capopaul/Toxic-Detection-PCB/SW/esp32/hello_world/README.md

# Hello World Example

Run the following command:

- `idf.py set-target esp32`
- `idf.py build`
- Put the jumper `JP1` to GND. You might need to press ESP reset button (`SW1`).
- `idf.py flash monitor`
- Put the jumper `JP1` to 3V3. Press ESP reset button (`SW1`).
