capopaul/Toxic-Detection-PCB/doc/design_notes_v4.0.pdf

design_notes.md | 2026-02-13

# Toxic Detection PCB - Schematic design notes

## Revision

Revision | Date | Author | Comment
v4.0 | 2026 Feb 12 | Paul Capgras | First draft : Pre-Layout

## Related Documents

Product Brief.
All components datasheets, reference manuals, evaluation boards available in doc/components/. Alphasense sensors' datasheets.

## Purpose

The purpose of Toxic Detection PCB - Schematic design notes is to document the design choices and provide details on the project.

## Table of Content

. Features
. Architecture
. Component choice
. Schematic
. Microcontroller - STM32H755ZIT3
. STM32 - Power Supply
. STM32 - Booting and programming . STM32 - Clocks
. STM32 - Debug
. STM32 - Flash
. Analog Front End
. LDOs
. Power Gating
. WiFi module - ESP32-WROOM-32E-N16 . ESP32 - Booting and programming . ESP32 - Debug
. STM32 - ESP32 communication . ESP32 - Pin assignments
. GNSS module and antenna - SAM-M10Q . MicroSD card
. Debug Features
. Shematic Revision 4.0
. Layout

## 1. Features

Toxic-Detection-PCB supports 2 sets of 4 chemical sensors from Alphasense. Toxic-Detection-PCB integrates an high performance microcontroller (STM32H755). Toxic-Detection-PCB can communicate via WiFi, Bluetooth v4.2 and BLE (ESP32). Toxic-Detection-PCB supports concurrent reception of four GNSS (GPS, GLONASS, Galileo, and BeiDou).
Toxic-Detection-PCB is powered through USB-C connector, or via 5V UARTs. Toxic-Detection-PCB is reprogrammable: ESP32 is programmable with UART, STM32 is programmable with UART and USB 2.0. Note: Programming thanks to usb can be disable. Toxic-Detection-PCB provide power for a 5V-fan.
STM32 and ESP32 can be debugged via JTAG.
STM32 have access to a 2MB internal flash, 32MB external flash (QSPI), MicroSD card (SDMMC 4 lines).
Toxic-Detection-PCB embedded protection against short ciruits (1A fuse), return currents, ESD (on UARTs, USB, SD card).
Toxic-Detection-PCB can turnoff power for each Analog Front End and for the fan. Toxic-Detection-PCB includes 1 red and 2 green LEDs. The red led indicates the board is powered and there are no short circuit detected. The 1rst green led is controlled by the ESP32, the 2nd by the STM32. It is up to the user to define their meaning.
Unused GPIOs of STM32, ESP32 and channels of ADCs are routed to headers.

## 2. Architecture

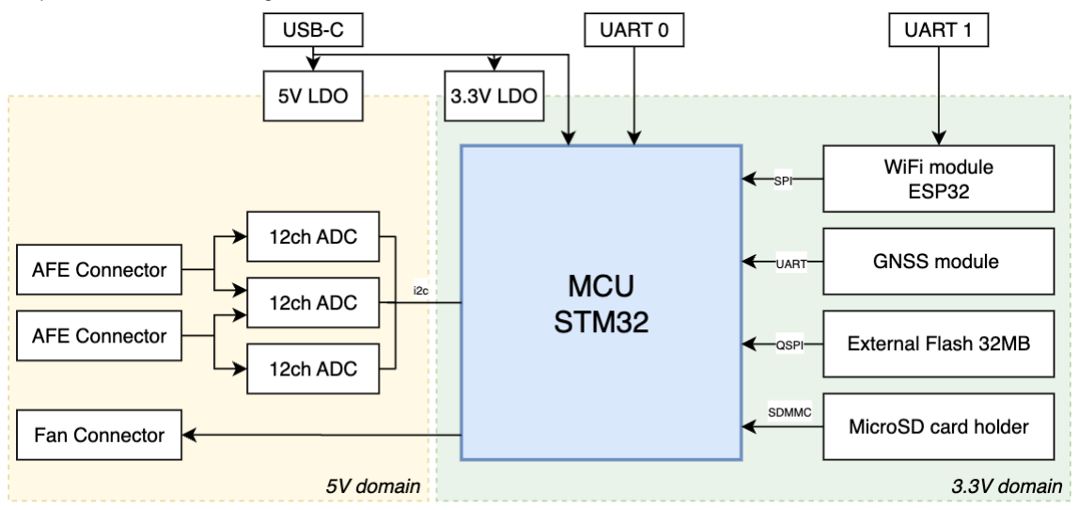
[picture p77: figure]

Simplified architecture diagram:

Complete architecture diagram:


## 3. Component choice

Many components are based on the previous board design: Revision 3.3 (April 2024) and Revision 3.3.1 (August 2024).

MCU: STM32H755ZIT3 is chosen as the Machine Learning applications have been tested on the Nucleo-h755zi development board which contains the STM32H755ZIT3.
WIFI: ESP32-WROOM-32E is picked because it is easy to use.
GNSS: SAM-M10Q is selected because it includes both GNSS module and antenna.

## 4. Schematic

4.1 Microcontroller - STM32H755ZIT3

4.1.1 STM32 - Power supply

According to the STM 32 power supply figure:


There are multiple key power domain:

. VDD domain (clocks, Batterie charging, IOs ring) : It is powered by VDD (3.3V).
. Analog domain : it is powered by (3.3VA).
. Core domain : it can be powered by internal SMPS or internal LDO. Default configuration is SMPS (3.3V input, Vcore at 1.2V).
. USB power domain: not used in this board.


Schematic:

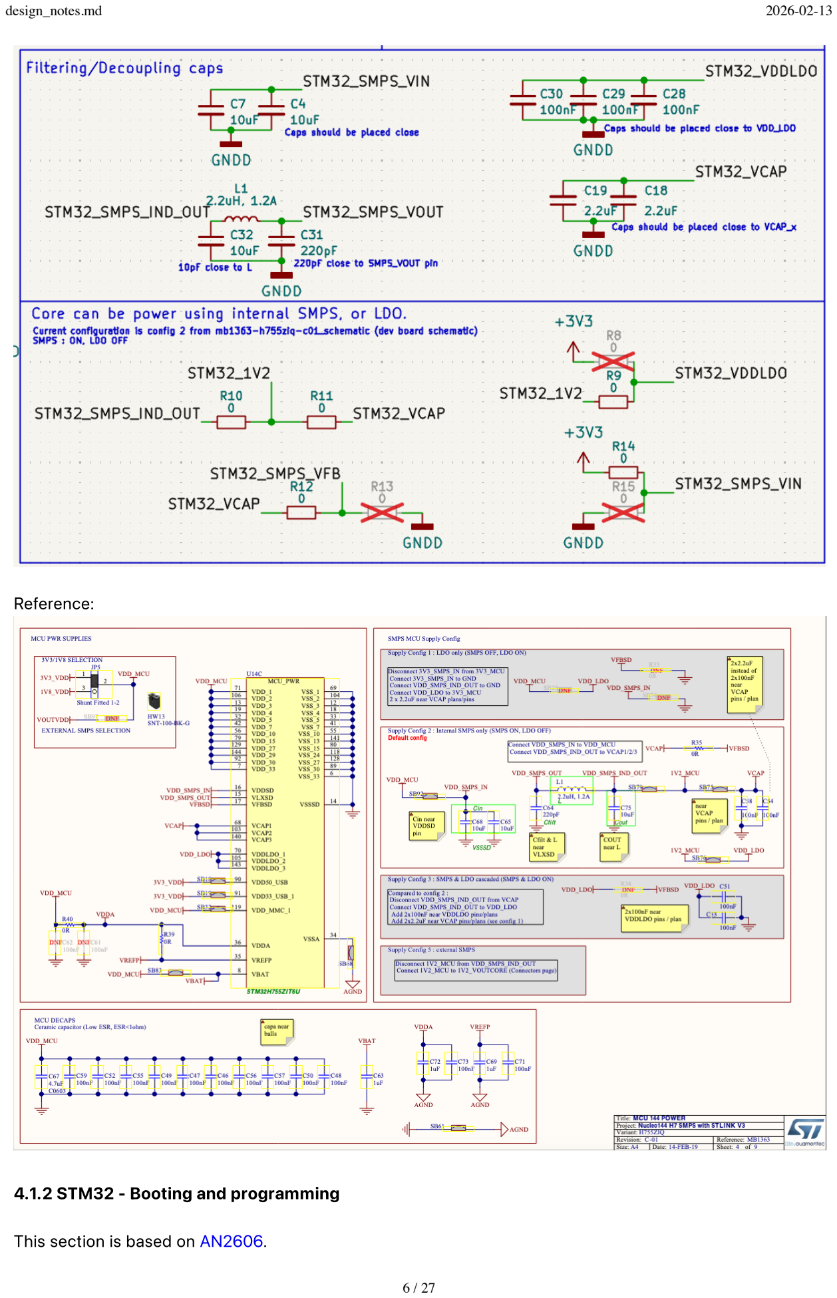
[picture p78: page 6]

Reference:

4.1.2 STM32 - Booting and programming

This section is based on AN2606.

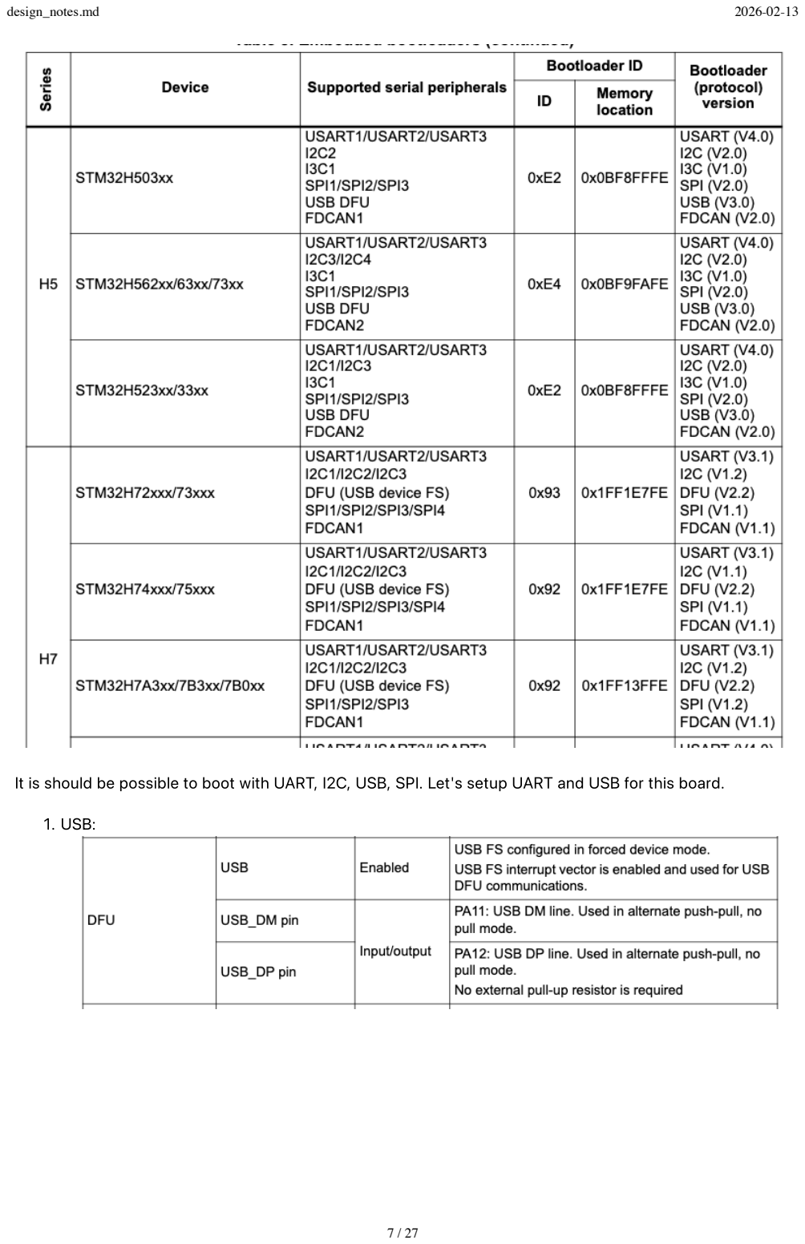
[picture p79: page 7]

It is should be possible to boot with UART, I2C, USB, SPI. Let's setup UART and USB for this board.

. USB:

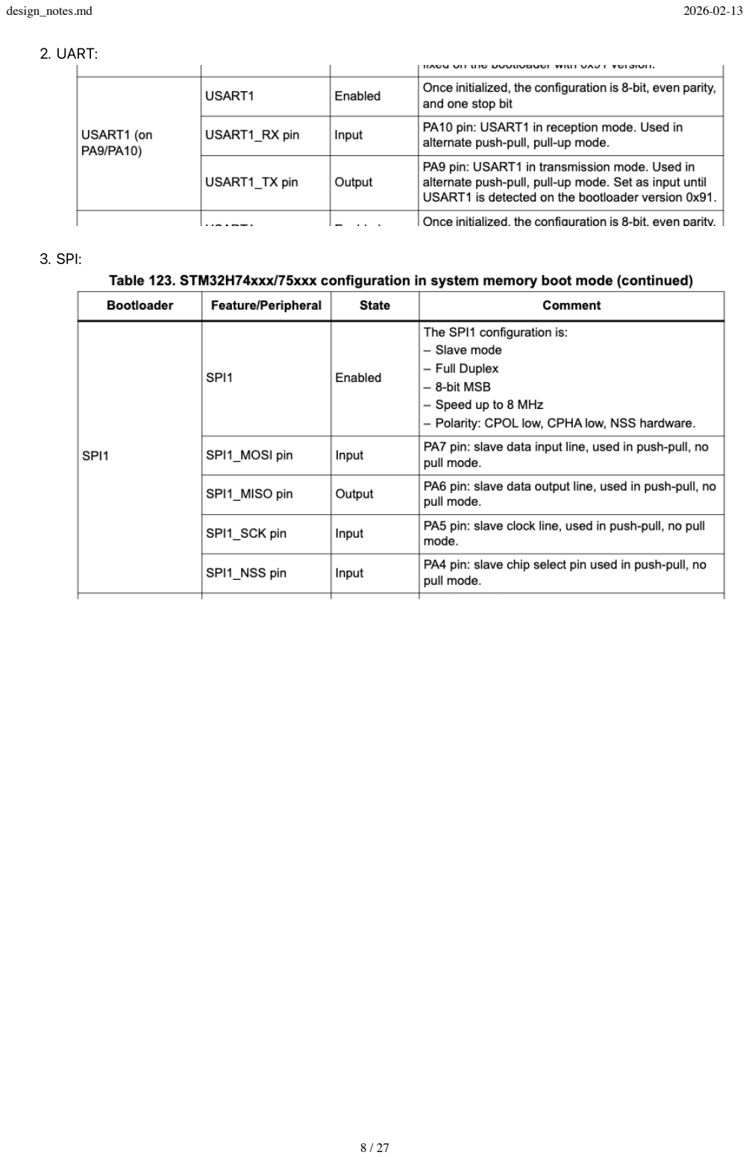
[picture p80: page 8]

. UART:

. SPI:


Schematic:

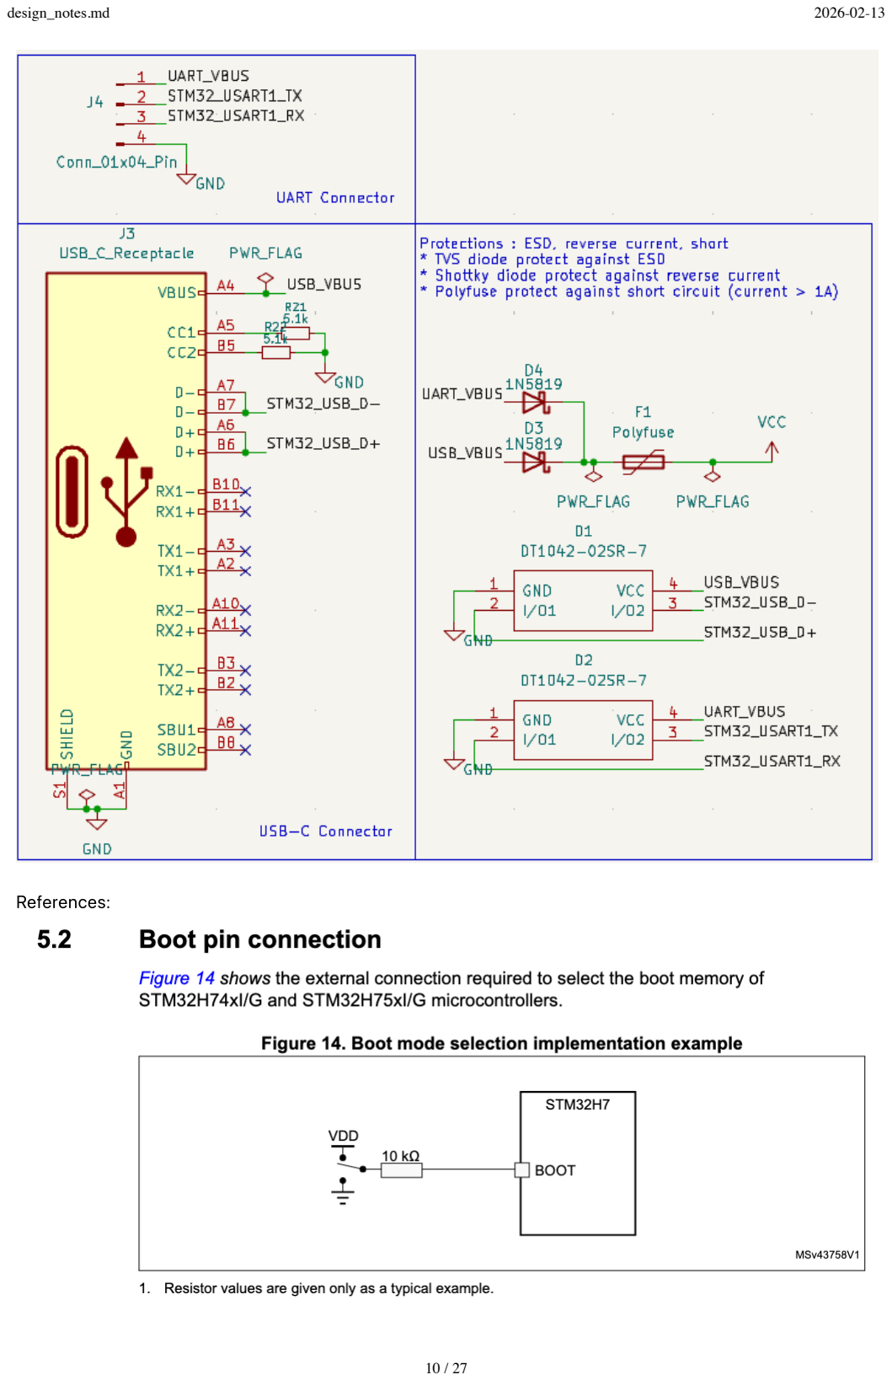
[picture p81: page 10]

References:

4.1.3 STM32 - Clocks

Schematic:


References: It is based on AN4938.


Section 4.1.2 of :

The external oscillator frequency ranges from 4 to 48 MHz. The external oscillator has the advantage of producing a very accurate main clock. The associated hardware configuration is shown in Figure 11. Using a 25 MHz oscillator frequency is a good choice to get accurate Ethernet, USB OTG high-speed peripheral, I2S, and SAI.
The resonator and the load capacitors have to be connected as close as possible to the oscillator pins to minimize the output distortion and startup stabilization time. The load capacitance values must be adjusted according to the selected oscillator.
For CL1 and CL2 it is recommended to use high-quality ceramic capacitors in the 5 pF to 25 pF range (typical), designed for high-frequency applications and selected to meet the requirements of the crystal or resonator. CL1 and CL2 are usually the same value. The crystal manufacturer typically specifies a load capacitance that is the series combination of CL1 and CL2. The PCB and MCU pin capacitances must be included when sizing CL1 and CL2 (10 pF can be used as a rough estimate of the combined pin and board capacitance).

Datasheet for the 25MHz clock (HSE): ECX_2236B2. The Load capacitance of this clock is 18pF (its in the name, do not refer to datasheet). So the Capacitors are 16pF to have 18 = 10 + 16/2

Datasheet for the 32.768kHz clock(OSC32): CM9V-T1A. The load capacitance of this clock is 12.5pF. So the capacitors are 5pF to have 12.5 = 10 + 5/2

4.1.4 STM32 - Debug

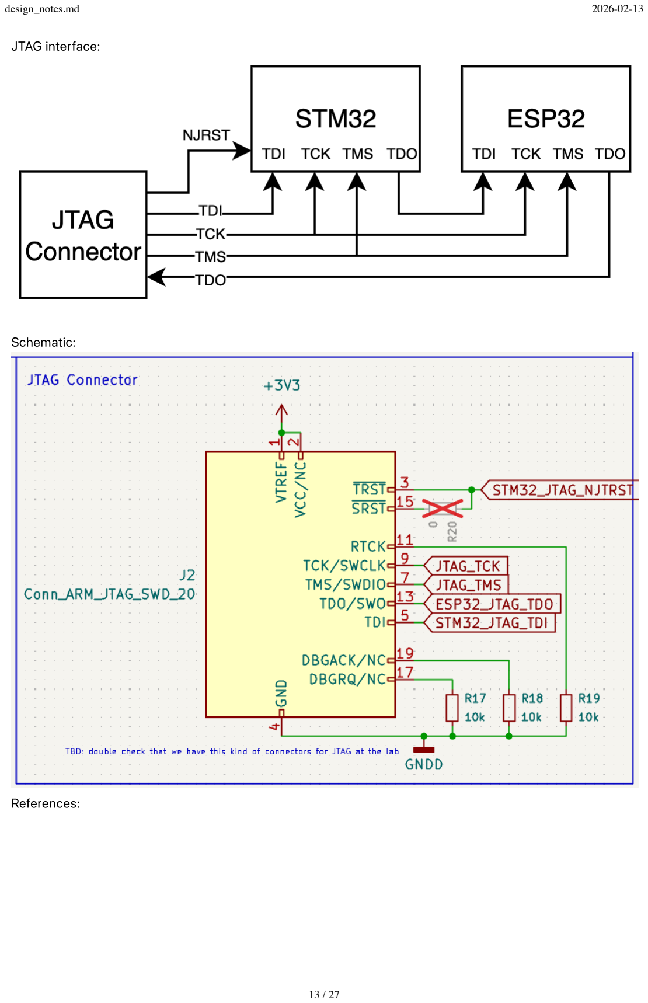
[picture p82: page 13]

JTAG interface:

Schematic:

References:

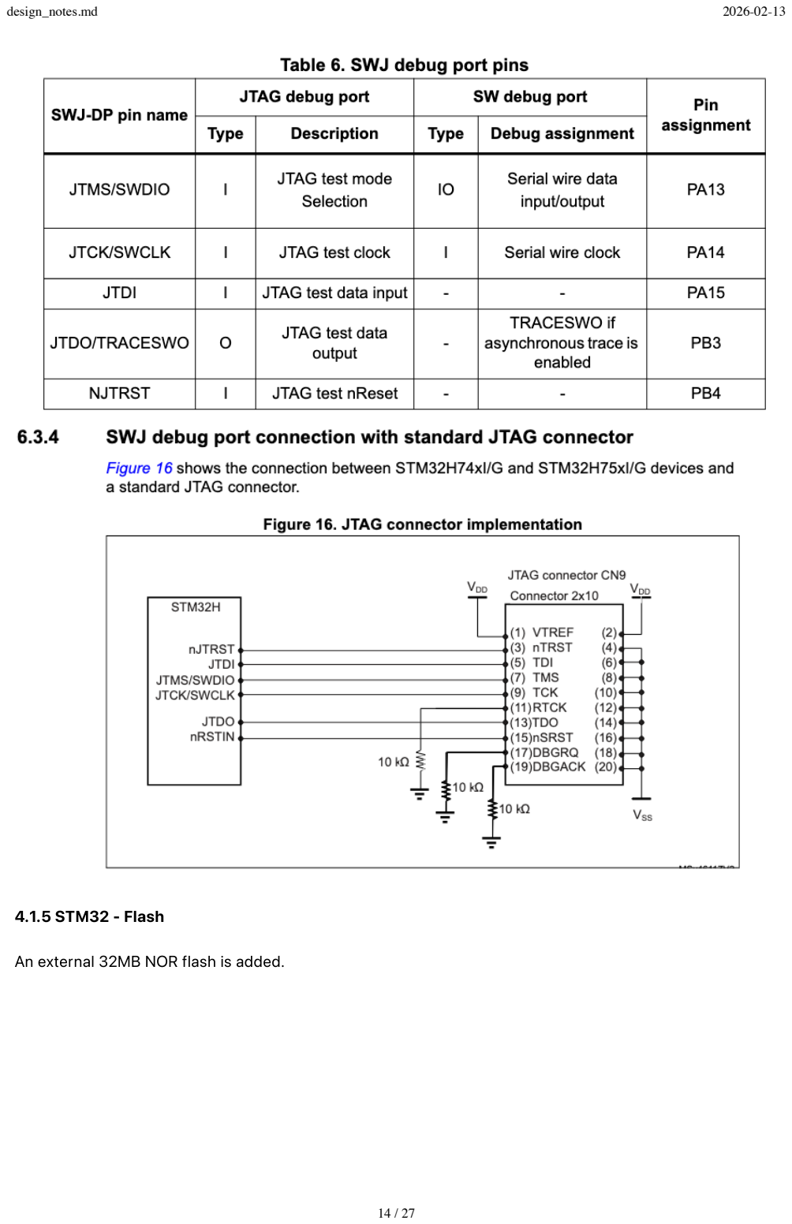
[picture p83: page 14]

4.1.5 STM32 - Flash

An external 32MB NOR flash is added.

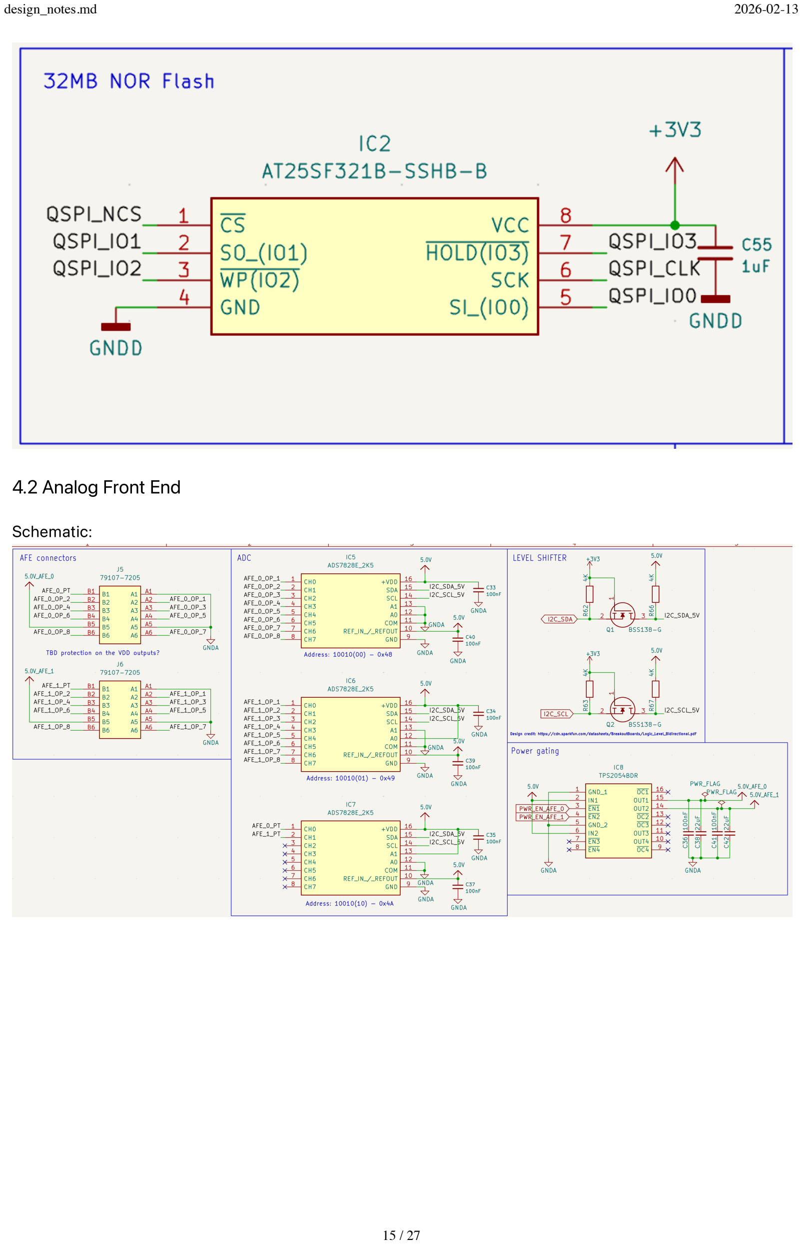
[picture p84: page 15]

4.2 Analog Front End

Schematic:

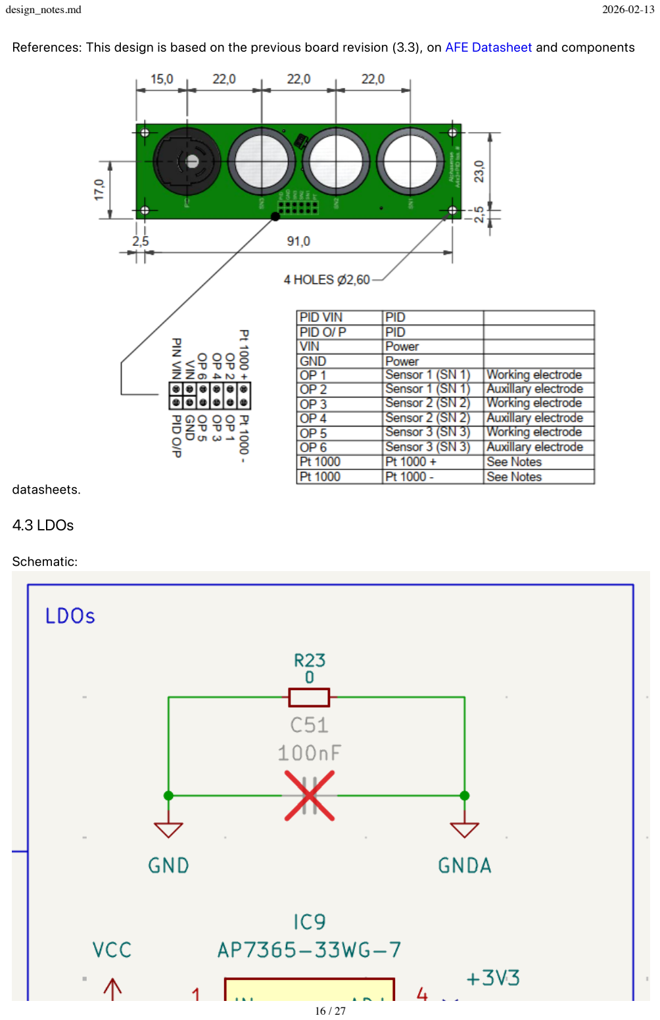
[picture p85: page 16]

References: This design is based on the previous board revision (3.3), on AFE Datasheet and components

datasheets.

4.3 LDOs

Schematic:

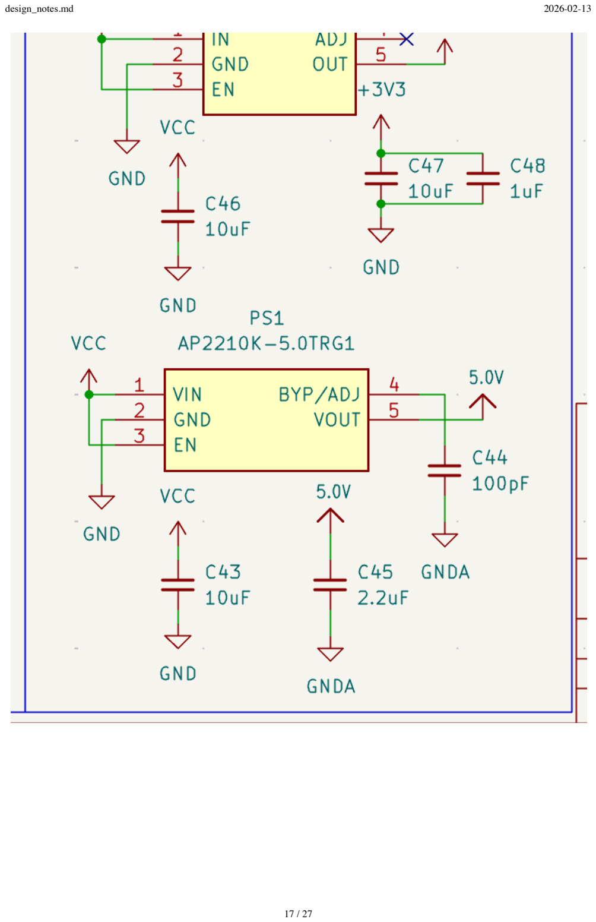
[picture p86: page 17]
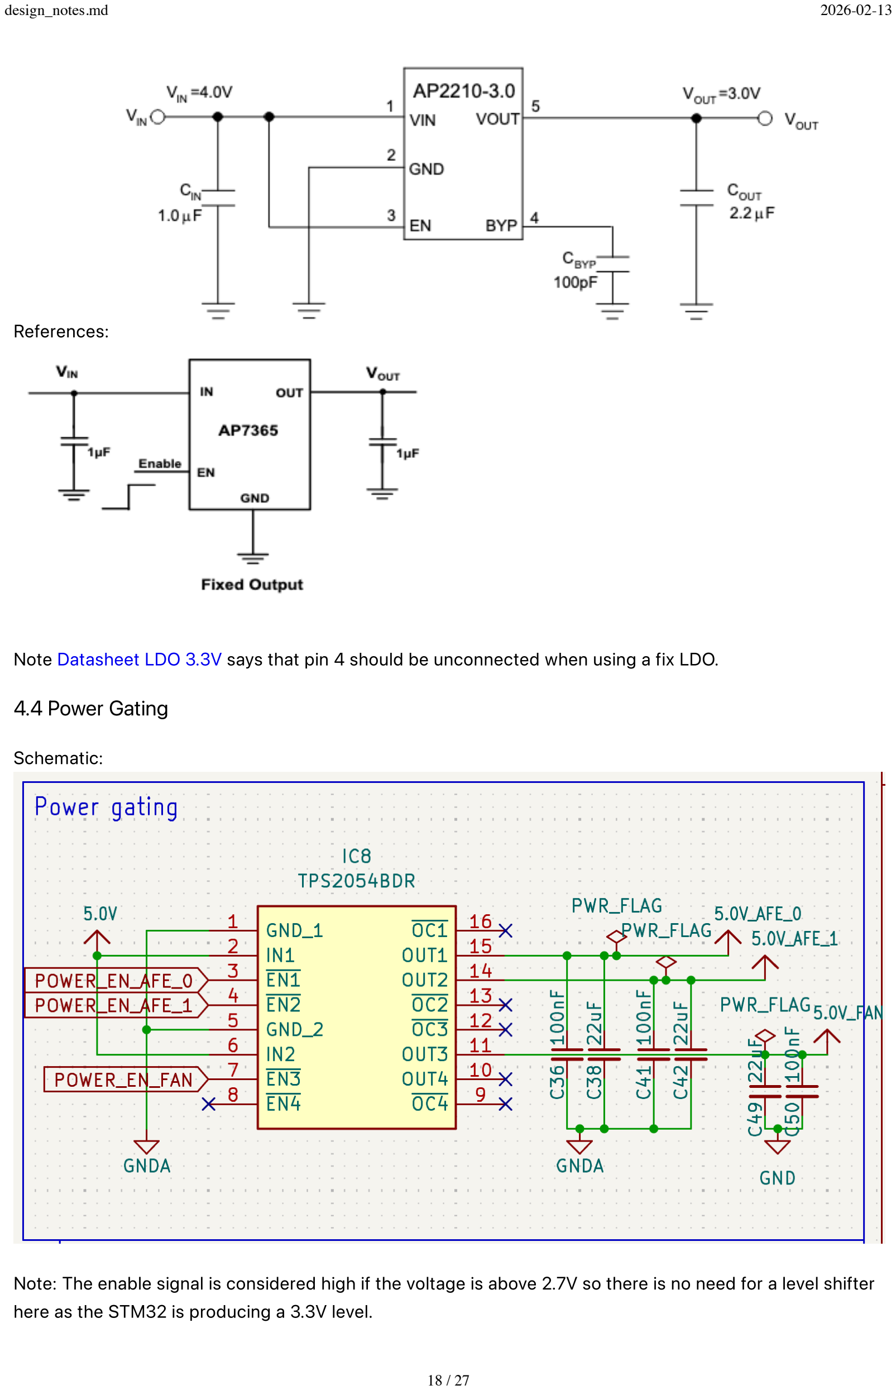
[picture p87: page 18]

References:

Note Datasheet LDO 3.3V says that pin 4 should be unconnected when using a fix LDO.

4.4 Power Gating

Schematic:

Note: The enable signal is considered high if the voltage is above 2.7V so there is no need for a level shifter here as the STM32 is producing a 3.3V level.

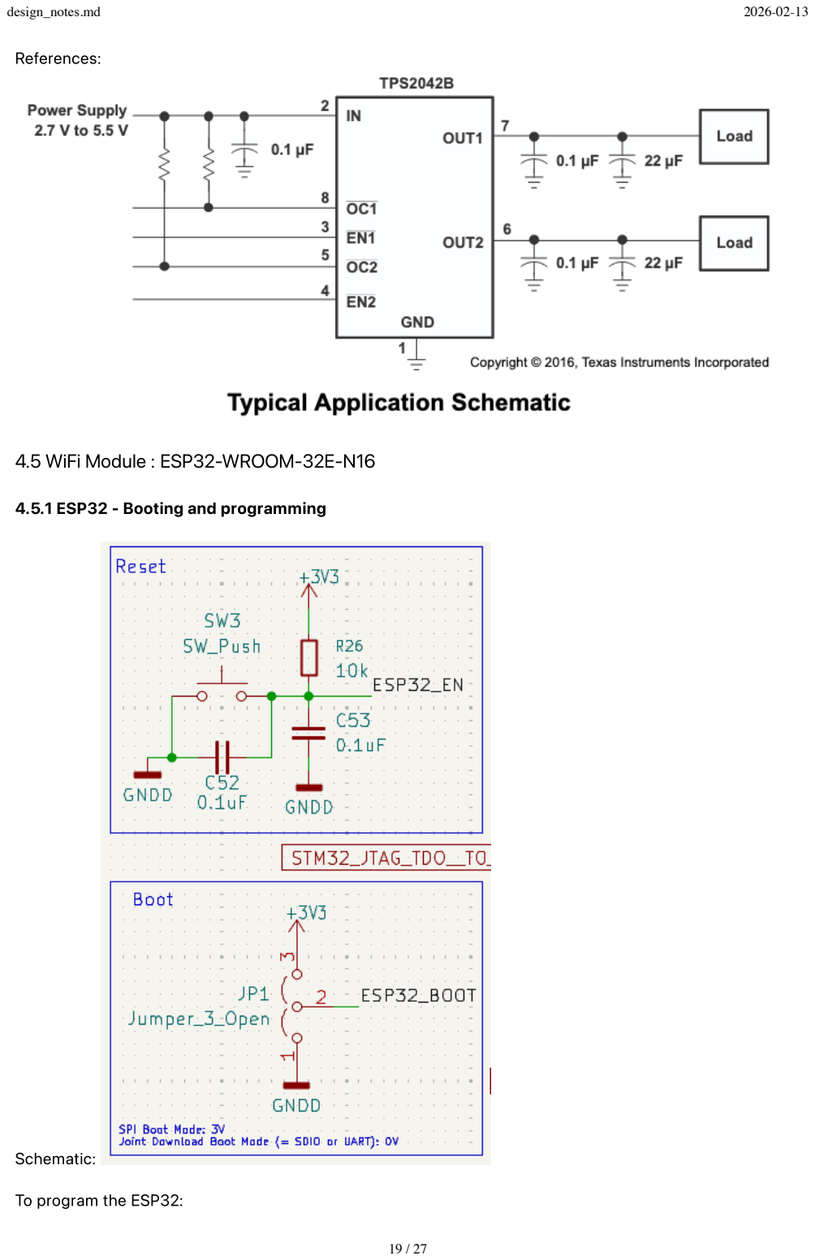
[picture p88: page 19]

References:

4.5 WiFi Module : ESP32-WROOM-32E-N16

4.5.1 ESP32 - Booting and programming

Schematic:

To program the ESP32:

First, connect ESP32_BOOT to GND using the jumper.
Then program the 16MB flash using UART.
Finally, put the jumper back to 3.3v to boot from the flash that has been programmed.

References:

DevKitC V4.

4.5.2 ESP32 - Debug

Debug can be performed via JTAG. See STM32 debug section.

4.5.3 STM32 - ESP32 communication

To communicate with the ESP from the STM32, decision is made to use SPI because it is fast and the ESP32 has SPI slave available natively.

References: The General Purpose SPI can behave in slave mode. For them any GPIO is possible, however for best performance, it is better to use parallel QSPI pins. Since HSPI pins are used by JTAG, decision is


made to use the VSPI pins.

Schematic:


4.5.4 ESP32 - Pin assignments

This table contains all the pin assignments. It was updated during layout to make rooting easier.

IO° | Type | Active Mode | Debug/Bringup
IO0 | I/O | | booting
IO1 TXD0 | I/O | | esp32_uart_tx
IO2 | I/O | | booting
IO3 RXD0 | I/O | | esp32_uart_rx
IO4 | I/O
IO5 | I/O | esp32_spi_cs
IO12 | I/O | | jtag_tdi
IO13 | I/O | | jtag_tck
IO14 | I/O | | jtag_tms
IO15 | I/O | | jtag_tdo
IO16 | I/O | esp32_led_0

IO° | Type | Active Mode | Debug/Bringup
IO17 | I/O
IO18 | I/O | esp32_spi_sclk
IO19 | I/O | esp32_spi_miso
IO21 | I/O
IO22 | I/O
IO23 | I/O | esp32_spi_mosi
IO25 | I/O
IO26 | I/O | stm32_esp32_irq_1
IO27 | I/O | stm32_esp32_irq_2
IO32 | I/O
IO33 | I/O
IO34 | I
IO35 | I
IO36 SENSOR_VP | I
IO39 SENSOR_VN | I

4.6 GNSS module and antenna - SAM-M10Q


Schematic:

References:


4.7 MicroSD card

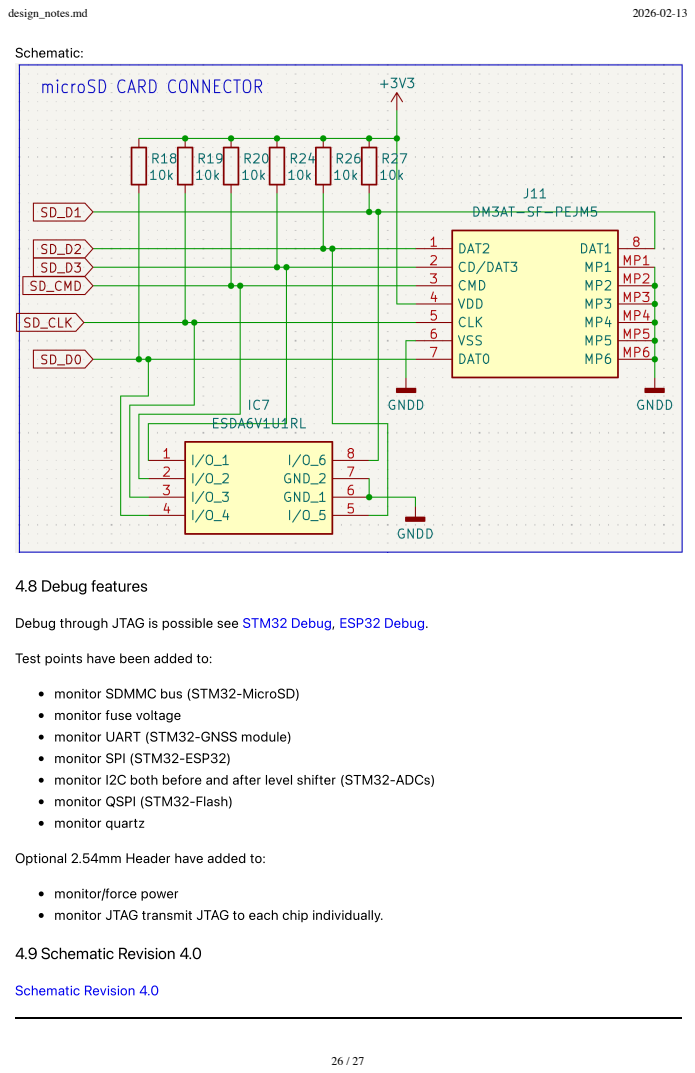
[picture p89: page 26]
Schematic:; 4.8 Debug features; 4.9 Schematic Revision 4.0; Schematic Revision 4.0

Debug through JTAG is possible see STM32 Debug, ESP32 Debug.

Test points have been added to:

monitor SDMMC bus (STM32-MicroSD)
monitor fuse voltage
monitor UART (STM32-GNSS module)
monitor SPI (STM32-ESP32)
monitor I2C both before and after level shifter (STM32-ADCs)
monitor QSPI (STM32-Flash)
monitor quartz

Optional 2.54mm Header have added to:

monitor/force power
monitor JTAG transmit JTAG to each chip individually.

## 5. Layout
