capopaul/Toxic-Detection-PCB/doc/images/AirU_System_Diagram.jpg

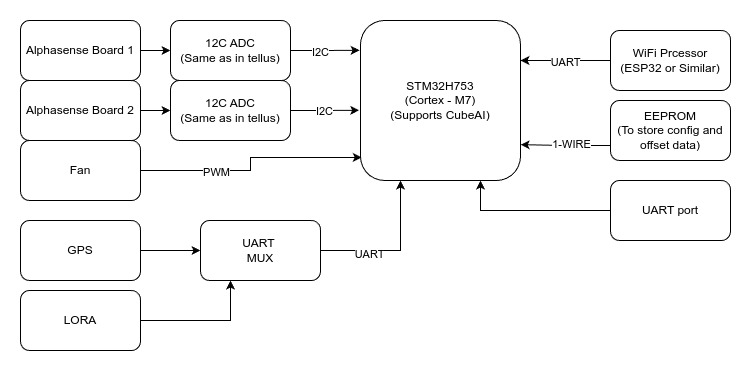
doc/images/AirU_System_Diagram.jpg
