capopaul/Toxic-Detection-PCB/doc/images/schematic_jtag.png

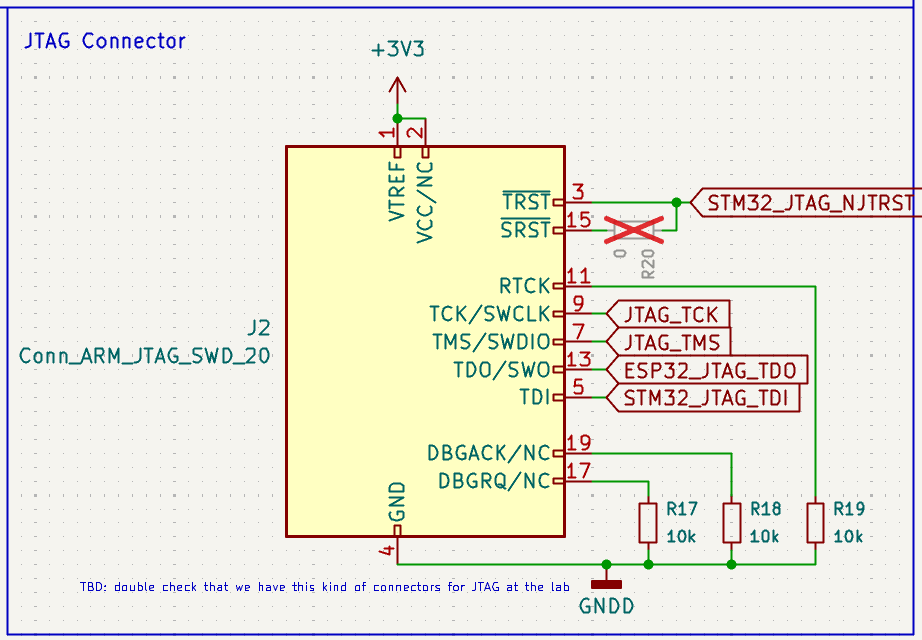
doc/images/schematic_jtag.png
