capopaul/Toxic-Detection-PCB/doc/components/AFE Connector 79107-7204/79107-7204.pdf

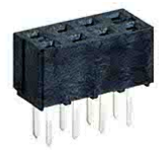
[picture p94: figure]

Part Number : 791077204 (https://www.molex.com/en-us/products/part-detail/791077204)
Product Description : 2.00mm Pitch Milli-Grid Receptacle, Vertical, Through Hole, Dual Row, 1.91mm Tail Length, 0.38µm Gold (Au) Selective Plating, 10 Circuits, Lead-Free, Tube
Series Number : 79107
Status : Active
Product Category : PCB Headers and Receptacles

### Documents and Resources

Drawings
791077204_sd.pdf (https://www.molex.com/content/dam/molex/molex-dot-com/products/automated/en-us/salesdrawingpdf/791/79107/791077204_sd.pdf)
PK-70873-0180-001.pdf (https://www.molex.com/content/dam/molex/molex-dot-com/products/automated/en-us/packagingdesigndrawing/708/70873/PK-70873-0180-001.pdf)
3D Models and Design Files STEP (https://www.molex.com/bin/molex/traceparts/cad-request?partNumber=791077204&cadFormatId=659) AP242 (https://www.molex.com/bin/molex/traceparts/cad-request?partNumber=791077204&cadFormatId=659)
SOLIDWORKS (https://www.molex.com/bin/molex/traceparts/cad-request?partNumber=791077204&cadFormatId=7)
Creo (https://www.molex.com/bin/molex/traceparts/cad-request?partNumber=791077204&cadFormatId=16)
Symbol (https://www.molex.com/en-us/products/part-3d-cad/791077204) and (https://www.molex.com/en-us/products/part-3d-cad/791077204) Footprint (https://www.molex.com/en-us/products/part-3d-cad/791077204) (Multi- (https://www.molex.com/en-us/products/part-3d-cad/791077204)Format) (https://www.molex.com/en-us/products/part-3d-cad/791077204) Specifications
503940001- (https://www.molex.com/content/dam/molex/molex-dot-com/products/automated/en-us/applicationspecificationspdf/503/50394/503940001-AS-000.pdf)AS-000.pdf (https://www.molex.com/content/dam/molex/molex-dot-com/products/automated/en-us/applicationspecificationspdf/503/50394/503940001-AS-000.pdf)
PS-79107-001.pdf (https://www.molex.com/content/dam/molex/molex-dot-com/products/automated/en-us/productspecificationpdf/791/79107/PS-79107-001.pdf)

### Product Environment Compliance

Compliance
GADSL/IMDS | Not Relevant
China RoHS | per SJ/T 11365-2006
EU ELV | Not Relevant
Low-Halogen Status | Low-Halogen per IEC 61249-2-21
REACH SVHC | Not Contained per D(2025)6375-DC (05 Nov 2025)
EU RoHS | Compliant per EU 2015/863

Compliance (https://www.molex.com/en-us/product-compliance#pn=791077204) Statements (https://www.molex.com/en-us/product-compliance#pn=791077204)
EU RoHS
REACH SVHC
Low-Halogen
Industry (https://www.molex.com/en-us/industry-compliance?pn=791077204) Documents (https://www.molex.com/en-us/industry-compliance?pn=791077204)
IPC 1752A Class C
IPC 1752A Class D
Molex Product Compliance Declaration IEC-62474
chemSHERPA (xml)
Substances (https://www.molex.com/en-us/substances-of-interest?pn=791077204) of (https://www.molex.com/en-us/substances-of-interest?pn=791077204) Interest (https://www.molex.com/en-us/substances-of-interest?pn=791077204)
PFAS
EU (https://www.molex.com/en-us/rohs-pdf?pn=791077204) RoHS (https://www.molex.com/en-us/rohs-pdf?pn=791077204) Certificate (https://www.molex.com/en-us/rohs-pdf?pn=791077204) of (https://www.molex.com/en-us/rohs-pdf?pn=791077204) Compliance (https://www.molex.com/en-us/rohs-pdf?pn=791077204) Additional (https://www.molex.com/en-us/about/product-compliance) Product (https://www.molex.com/en-us/about/product-compliance) Compliance (https://www.molex.com/en-us/about/product-compliance) Information (https://www.molex.com/en-us/about/product-compliance)

### Part Details

General
Status | Active
Category | PCB Headers and Receptacles
Series | 79107
Description | 2.00mm Pitch Milli-Grid Receptacle, Vertical, Through Hole, Dual Row, 1.91mm Tail Length, 0.38µm Gold (Au) Selective Plating, 10 Circuits, Lead-Free, Tube
Application | Board-to-Board, Signal
Component Type | PCB Receptacle
Product Name | Milli-Grid
UPC | 822348475018

Agency
CSA | LR19980
UL | E29179

Electrical
Current - Maximum per Contact | 1.0A
Voltage - Maximum | 125V

Physical
Circuits (Loaded) | 10
Circuits (maximum) | 10
Color - Resin | Black
Durability (mating cycles max) | 50
First Mate / Last Break | No
Flammability | 94V-0
Glow-Wire Capable | No
Lock to Mating Part | No
Material - Metal | Phosphor Bronze
Material - Plating Mating | Gold
Material - Plating Termination | Tin
Material - Resin | High Temperature Thermoplastic
Net Weight | 285.580/mg
Number of Rows | 2
Orientation | Vertical
Packaging Type | Tube
PCB Locator | No
PCB Retention | None
PCB Thickness - Recommended | 0.80mm
PC Tail Length | 1.91mm
Pitch - Mating Interface | 2.00mm
Pitch - Termination Interface | 2.00mm
Plating min - Mating | 0.381µm
Plating min - Termination | 1.905µm
Polarized to Mating Part | No
Polarized to PCB | No
Temperature Range - Operating | -55° to +125°C
Termination Interface Style | Through Hole

Solder Process Data
Max-Duration | 10
Lead-Free Process Capability | WAVE
Max-Cycle | 1
Max-Temp | 260

### Mates With / Use With

Mates with Part(s)
Description | Part Number
Milli-Grid Vertical Through Hole Headers | 87758 (https://www.molex.com/en-us/part-list/87758?physical_circuitsMaximum="10"&physical_numberOfRows="2")
Milli-Grid Vertical Surface Mount Headers | 87759 (https://www.molex.com/en-us/part-list/87759?physical_circuitsMaximum="10"&physical_numberOfRows="2")
Milli-Grid Right-Angle Through Hole Headers | 87760 (https://www.molex.com/en-us/part-list/87760?physical_circuitsMaximum="10"&physical_numberOfRows="2")
Milli-Grid Vertical, Dual Row, Through Hole Headers | 87831 (https://www.molex.com/en-us/part-list/87831?physical_circuitsMaximum="10"&physical_numberOfRows="2")
Milli-Grid Vertical, Dual Row, Surface Mount Headers | 87832 (https://www.molex.com/en-us/part-list/87832?physical_circuitsMaximum="10"&physical_numberOfRows="2")
Milli-Grid Vertical, Dual Row, Through Hole Headers | 151117 (https://www.molex.com/en-us/part-list/151117?physical_circuitsMaximum="10"&physical_numberOfRows="2")
Milli-Grid Vertical, Dual Row, Surface Mount Headers | 151118 (https://www.molex.com/en-us/part-list/151118?physical_circuitsMaximum="10"&physical_numberOfRows="2")
Milli-Grid Right-Angle, Dual Row, Through Hole Headers | 151119 (https://www.molex.com/en-us/part-list/151119?physical_circuitsMaximum="10"&physical_numberOfRows="2")
Milli-Grid Right-Angle, Dual Row, Surface Mount Headers | 151120 (https://www.molex.com/en-us/part-list/151120?physical_circuitsMaximum="10"&physical_numberOfRows="2")

This document was generated on Feb 10, 2026
