capopaul/Toxic-Detection-PCB/doc/components/Quartz 25MHz/ECX_2236B2.pdf

# ECX-2236B2 SMD CRYSTAL

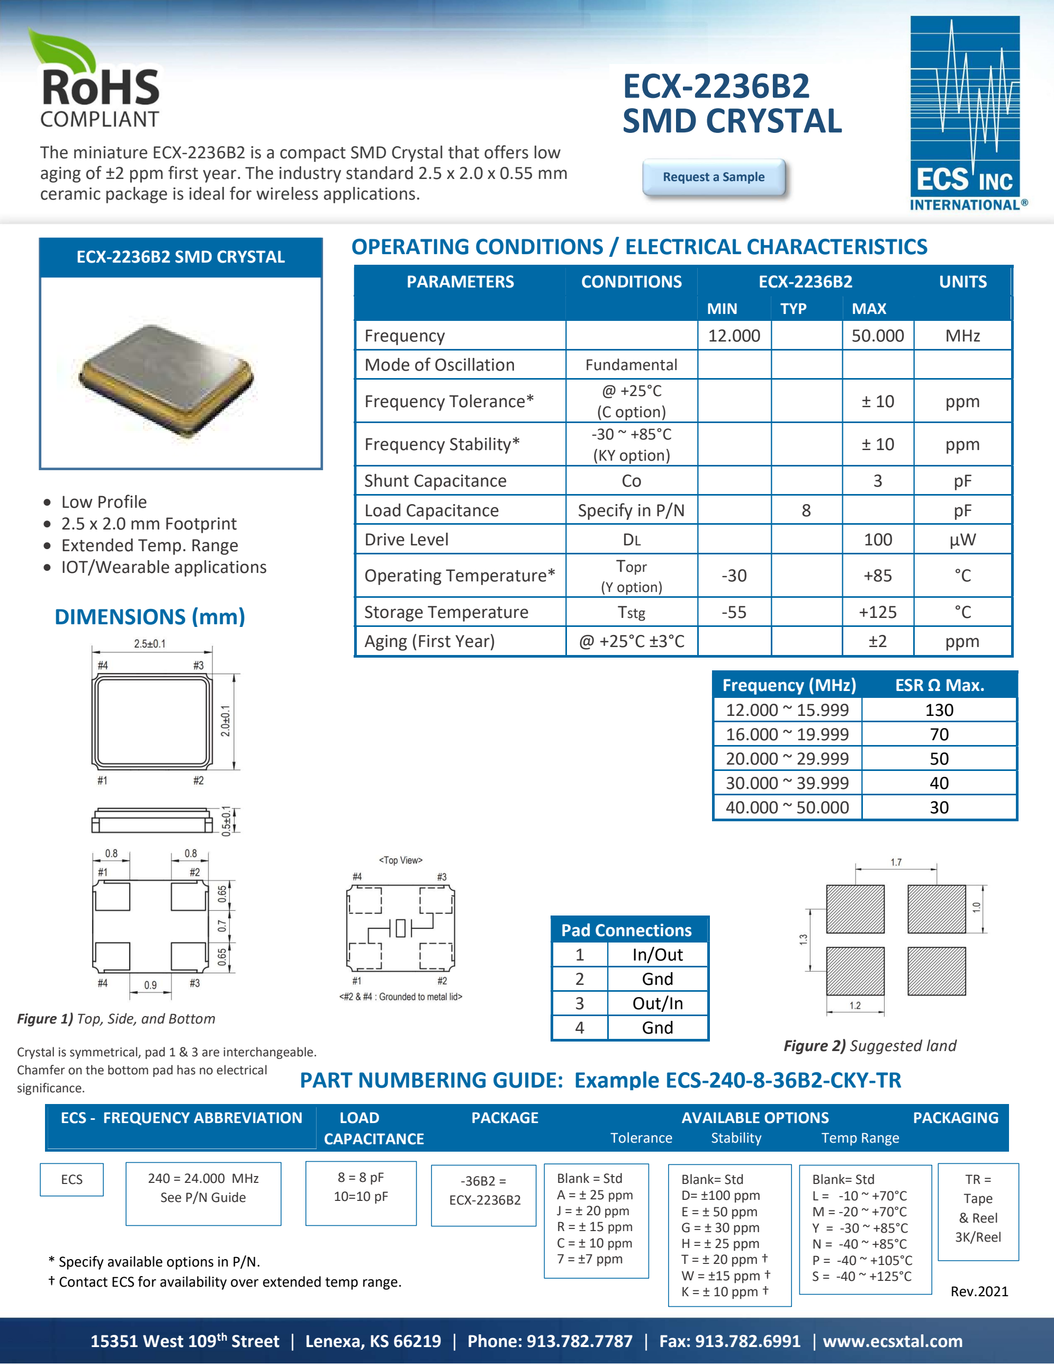
[picture p95: page 1]

15351 West 109th Street | Lenexa, KS 66219 | Phone: 913.782.7787 | Fax: 913.782.6991 | www.ecsxtal.com
PARAMETERS | CONDITIONS | ECX-2236B2 | UNITS
| | MIN | TYP | MAX
Frequency | | 12.000 | | 50.000 | MHz
Mode of Oscillation | Fundamental
Frequency Tolerance* | @ +25°C (C option) | | | ± 10 | ppm
Frequency Stability* | -30 ~ +85°C (KY option) | | | ± 10 | ppm
Shunt Capacitance | Co | | | 3 | pF
Load Capacitance | Specify in P/N | | 8 | | pF
Drive Level | DL | | | 100 | μW
Operating Temperature* | Topr (Y option) | -30 | | +85 | °C
Storage Temperature | Tstg | -55 | | +125 | °C
Aging (First Year) | @ +25°C ±3°C | | | ±2 | ppm
ECS - FREQUENCY ABBREVIATION | LOAD
CAPACITANCE
PACKAGE | AVAILABLE OPTIONS
Tolerance | Stability | Temp Range

PACKAGING

Frequency (MHz) | ESR Ω Max.
12.000 ~ 15.999 | 130
16.000 ~ 19.999 | 70
20.000 ~ 29.999 | 50
30.000 ~ 39.999 | 40
40.000 ~ 50.000 | 30

Pad Connections
1 In/Out
2 Gnd
3 Out/In
4 Gnd
- Low Profile
- 2.5 x 2.0 mm Footprint
- Extended Temp. Range
- IOT/Wearable applications

Figure 1) Top, Side, and Bottom

Crystal is symmetrical, pad 1 & 3 are interchangeable. Chamfer on the bottom pad has no electrical significance.

8 = 8 pF
10=10 pF | -36B2 =
| ECX-2236B2 Blank = Std
| A = ± 25 ppm
| J = ± 20 ppm
| R = ± 15 ppm
| C = ± 10 ppm
* Specify available options in P/N. | 7 = ±7 ppm
† Contact ECS for availability over extended temp range.

Blank= Std
D= ±100 ppm
E = ± 50 ppm
G = ± 30 ppm
H = ± 25 ppm
T = ± 20 ppm †
W = ±15 ppm †
K = ± 10 ppm †

Blank= Std
L = -10 ~ +70°C
M = -20 ~ +70°C
Y = -30 ~ +85°C
N = -40 ~ +85°C
P = -40 ~ +105°C
S = -40 ~ +125°C

### OPERATING CONDITIONS / ELECTRICAL CHARACTERISTICS

The miniature ECX-2236B2 is a compact SMD Crystal that offers low aging of ±2 ppm first year. The industry standard 2.5 x 2.0 x 0.55 mm ceramic package is ideal for wireless applications.

ECX-2236B2 SMD CRYSTAL

### DIMENSIONS (mm)

Figure 2) Suggested land

### PART NUMBERING GUIDE: Example ECS-240-8-36B2-CKY-TR

Request a Sample

240 = 24.000 MHz
See P/N Guide

TR =
Tape
& Reel
3K/Reel

Rev.2021

ECS

### POCKET TAPE DIMENSIONS (mm)

# ECX-2236B2

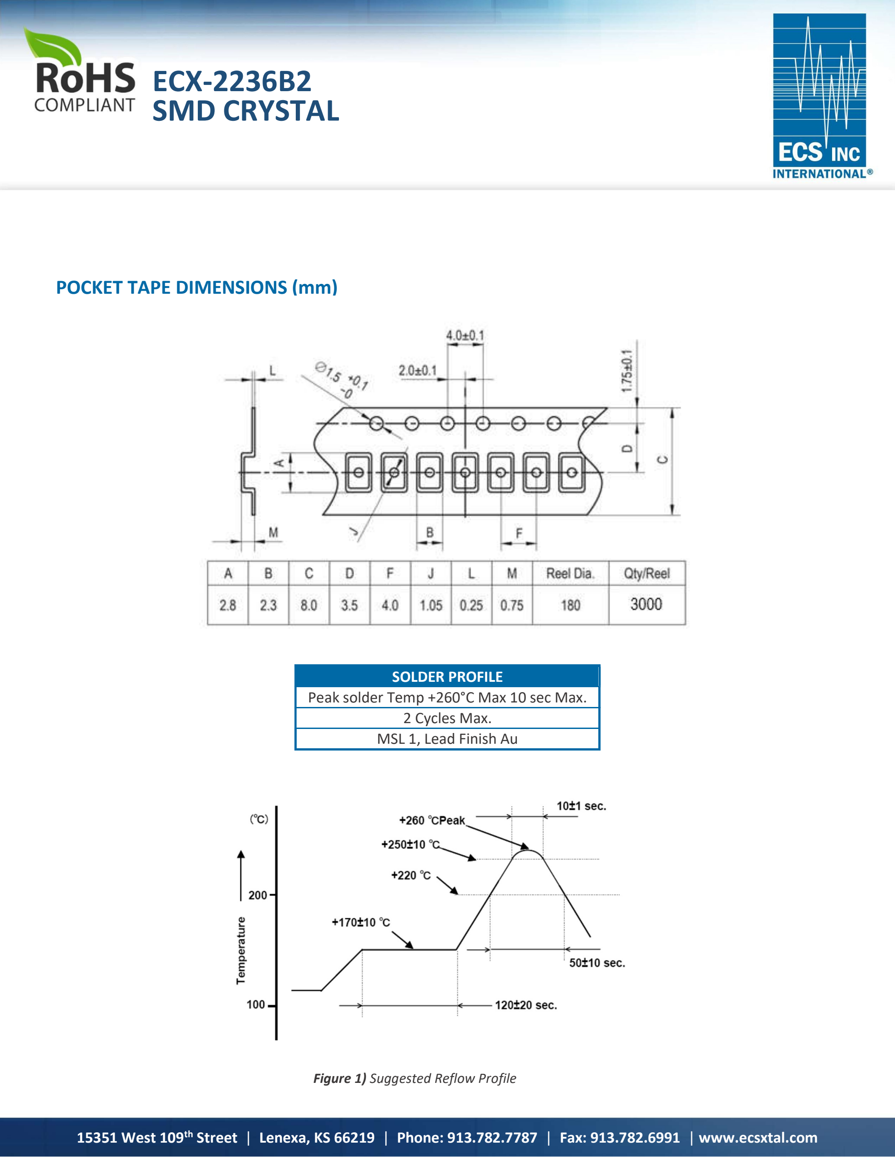
[picture p96: page 2]

15351 West 109th Street | Lenexa, KS 66219 | Phone: 913.782.7787 | Fax: 913.782.6991 | www.ecsxtal.com

SOLDER PROFILE
Peak solder Temp +260°C Max 10 sec Max. 2 Cycles Max.
MSL 1, Lead Finish Au

# SMD CRYSTAL

Figure 1) Suggested Reflow Profile
