capopaul/Toxic-Detection-PCB/doc/bom/bom_layout_v4.2_mouser.xlsm

Reference | Qty | Value | DNP | Footprint | In stock already | Mouser Order Qty | Mouser link
ANT1 | 1 | SAM-M10Q-00B |  | GNSS module and antenna:SAMM10Q00B_custom | 0 | 2 | https://www.mouser.com/ProductDetail/u-blox/MAX-M10M-00B?qs=A6eO%252BMLsxmQGh8%2FJ1ZmexA%3D%3D
C1,C3,C4,C6,C7,C9,C10,C11,C12,C13,C14,C15,C16,C17,C18,C19,C20,C27,C31,C32,C34,C36,C37,C38,C39,C40,C41,C49,C51,C54,C55 | 31 | 100nF |  | Capacitor_SMD:C_0805_2012Metric_Pad1.18x1.45mm_HandSolder | 88
C2,C46,C50,C52,C53 | 5 | 22uF |  | Capacitor_SMD:C_0805_2012Metric_Pad1.18x1.45mm_HandSolder | 9
C5 | 1 | 4.7uF |  | Capacitor_SMD:C_0805_2012Metric_Pad1.18x1.45mm_HandSolder | 97
C8,C25,C48,C56,C57,C58,C59,C60,C61,C62,C63,C64,C65,C66,C67,C68,C69,C70,C71,C72,C73,C74,C75,C76,C77,C78 | 26 | 1uF |  | Capacitor_SMD:C_0805_2012Metric_Pad1.18x1.45mm_HandSolder | 92
C21,C22,C23,C42,C43 | 5 | 10uF |  | Capacitor_SMD:C_0805_2012Metric_Pad1.18x1.45mm_HandSolder | 90
C24 | 1 | 220pF |  | Capacitor_SMD:C_0805_2012Metric_Pad1.18x1.45mm_HandSolder | 0 | 10 | https://www.mouser.com/ProductDetail/KYOCERA-AVX/KGM21BCG2A221JM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
C26,C35 | 2 | 16pF |  | Capacitor_SMD:C_0805_2012Metric_Pad1.18x1.45mm_HandSolder | 0 | 10 | https://www.mouser.com/ProductDetail/KEMET/C0805C160K3HACTU?qs=W0yvOO0ixfHxDqYJqurddw%3D%3D
C28,C33,C45 | 3 | 2.2uF |  | Capacitor_SMD:C_0805_2012Metric_Pad1.18x1.45mm_HandSolder | 0 | 10 | https://www.mouser.com/ProductDetail/Walsin/0805B225K100CT?qs=fIkAfuXiAQIAYTg2Qx2YBg%3D%3D
C29,C30 | 2 | 5pF |  | Capacitor_SMD:C_0805_2012Metric_Pad1.18x1.45mm_HandSolder | 0 | 10 | https://www.mouser.com/ProductDetail/KYOCERA-AVX/08053A5R0CAT2A?qs=bb%252B1MDm7h6IsPEvrtWkfEA%3D%3D
C44 | 1 | 100nF | DNP | Capacitor_SMD:C_0805_2012Metric_Pad1.18x1.45mm_HandSolder | 88
C47 | 1 | 100pF |  | Capacitor_SMD:C_0805_2012Metric_Pad1.18x1.45mm_HandSolder | 0 | 10 | https://www.mouser.com/ProductDetail/KEMET/C0805C101K5HACTU?qs=W0yvOO0ixfFGnDz2NfWDlg%3D%3D
D1,D2,D3 | 3 | DT1042-02SR-7 |  | USB_ESD_protection:DT104202SR7 | 0 | 10 | https://www.mouser.com/ProductDetail/Diodes-Incorporated/DT1042-02SR-7?qs=d9U39LAeJF0XUzMTT2aorQ%3D%3D
D4,D5 | 2 | 1N5819 |  | Diode_SMD:D_SOD-123 |  | 10 | https://www.mouser.com/ProductDetail/onsemi/SS25FA?qs=R26iFe%2FkX%2FL1fF1k08x8zQ%3D%3D
D6 | 1 | RED_LED_2mA |  | LED Green:LEDC2012X120N |  | 10 | https://www.mouser.com/ProductDetail/Kingbright/APT2012LSECK-J3-PRV?qs=6oMev5NRZMEkGJkKIsAalQ%3D%3D
D7,D8 | 2 | GREEN_LED_2mA |  | LED Green:LEDC2012X120N |  | 10 | https://www.mouser.com/ProductDetail/Kingbright/APTD2012LCGCK?qs=AQlKX63v8RvNHN%2F9EGvNTg%3D%3D
F1 | 1 | Polyfuse |  | Fuse:Fuse_1210_3225Metric_Pad1.42x2.65mm_HandSolder |  | 5 | https://www.mouser.com/ProductDetail/Littelfuse/1210L110-12WR?qs=TVaBpCI%2FeOiQpakeccCs1g%3D%3D
IC1 | 1 | ESP32-WROOM-32E-N16 |  | ESP32-WROOM-32E-N16:ESP32WROOM32EN16 |  | 2 | https://www.mouser.com/ProductDetail/Espressif-Systems/ESP32-WROOM-32E-N16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
IC2 | 1 | STM32H755ZIT3 |  | Package_QFP:LQFP-144_20x20mm_P0.5mm |  | 2 | https://www.mouser.com/ProductDetail/STMicroelectronics/STM32H755ZIT3?qs=sPbYRqrBIVmQlNF6lTdaDQ%3D%3D
IC3 | 1 | AT25SF321B-SSHB-B |  | NOR Flash:SOIC127P600X175-8N |  | 2 | https://www.mouser.com/ProductDetail/Renesas-Dialog/AT25SF321B-SSHB-B?qs=IS%252B4QmGtzzoKA0j9aoz1jA%3D%3D
IC4,IC5,IC6 | 3 | ADS7828E_2K5 |  | ADC ADS7828:SOP65P640X120-16N |  | 10 | https://www.mouser.com/ProductDetail/Texas-Instruments/ADS7828E-2K5?qs=%252BvKcWiXw%252BzTDfgQYOO5VWA%3D%3D
IC7 | 1 | ESDA6V1U1RL |  | TVS_diodes:SOIC127P600X175-8N |  | 2 | https://www.mouser.com/ProductDetail/STMicroelectronics/ESDA6V1U1RL?qs=jM0G0S7oE2ijLJcZLKDOhQ%3D%3D
IC8 | 1 | AZ1084CD-3.3TRG1 |  | LDO 3.3V:AZ1084CD33TRG1 |  | 10 | https://www.mouser.com/ProductDetail/Diodes-Incorporated/AZ1084CD-3.3TRG1?qs=FKu9oBikfSkIi2fxMEvJQA%3D%3D
IC9 | 1 | TPS2054BDR |  | Power Gating TPS2054BDR:SOIC127P600X175-16N |  | 2 | www.mouser.com/ProductDetail/Texas-Instruments/TPS2054BDR?qs=D8ivcil3VuyT4fCLpnAlBw%3D%3D
J1 | 1 | Conn_01x11_Pin |  | Connector_PinHeader_2.54mm:PinHeader_1x11_P2.54mm_Vertical | 100
J2 | 1 | Conn_01x10_Pin |  | Connector_PinHeader_2.54mm:PinHeader_1x10_P2.54mm_Vertical | 100
J3 | 1 | Conn_01x14_Pin |  | Connector_PinHeader_2.54mm:PinHeader_2x07_P2.54mm_Vertical | 100
J4 | 1 | Conn_01x16_Pin |  | Connector_PinHeader_2.54mm:PinHeader_2x08_P2.54mm_Vertical | 100
J5 | 1 | Conn_01x18_Pin |  | Connector_PinHeader_2.54mm:PinHeader_2x09_P2.54mm_Vertical | 100
J6,J7 | 2 | 79107-7205 |  | AFE Connector 79107-7205:791077205 |  | 4 | https://www.mouser.com/ProductDetail/Molex/79107-7205?qs=twZKxcNrvDYEJ65%2FtIoaGw%3D%3D
J8 | 1 | Conn_01x06_Pin |  | Connector_PinHeader_2.54mm:PinHeader_2x03_P2.54mm_Vertical | 100
J9,J10 | 2 | Conn_01x04_Pin |  | Connector_PinHeader_2.54mm:PinHeader_1x04_P2.54mm_Vertical | 100
J11 | 1 | USB_C_Receptacle |  | Connector_USB:USB_C_Receptacle_GCT_USB4105-xx-A_16P_TopMnt_Horizontal | 10
J12 | 1 | DM3AT-SF-PEJM5 |  | SD card holder:DM3ATSFPEJM5 |  | 2 | https://www.mouser.com/ProductDetail/Hirose-Connector/DM3AT-SF-PEJM5?qs=LZSZKJVF%252B2WTDKp%252BR7IYAQ%3D%3D
J13 | 1 | Conn_01x03_Pin |  | Connector_PinHeader_2.54mm:PinHeader_1x03_P2.54mm_Vertical | 100
J14,J15,J16,J18 | 4 | Conn_01x01_Pin | DNP | Connector_PinSocket_2.54mm:PinSocket_1x01_P2.54mm_Vertical | 100
J20 | 1 | Conn_01x02_Pin |  | Connector_PinHeader_2.54mm:PinHeader_1x02_P2.54mm_Vertical | 100
J21 | 1 | FTSH-105-01-L-DV-K |  | jtag connector:FTSH10501LDVK |  | 2 | https://www.mouser.com/ProductDetail/Samtec/FTSH-105-01-L-DV-K?qs=%252B5JSS813miOqo3Vy%252BvhCFg%3D%3D
JP1,JP2 | 2 | Jumper_3_Open |  | Connector_PinHeader_2.54mm:PinHeader_1x03_P2.54mm_Vertical | 100
L1 | 1 | 2.2uH, 1.2A |  | Inductor_SMD:L_0805_2012Metric_Pad1.05x1.20mm_HandSolder |  | 5 | https://www.mouser.com/ProductDetail/Murata-Electronics/LQM21PN2R2MGHL?qs=wM4AZDOQ8I6HkSUIfztW6Q%3D%3D
PS1 | 1 | AP2210K-5.0TRG1 |  | LDO 5V:SOT95P282X145-5N |  | 2 | https://www.mouser.com/ProductDetail/Diodes-Incorporated/AP2210K-5.0TRG1?qs=x6A8l6qLYDCAXUjYnFg7HQ%3D%3D
Q1,Q2 | 2 | BSS138-G |  | NMOS-BSS138G:SOT96P237X111-3N |  | 4 | https://www.mouser.com/ProductDetail/Comchip-Technology/BSS138-G?qs=PqoDHHvF64%252BWsXO1u6lRRQ%3D%3D
R1,R2,R9,R18,R19,R20,R24,R26,R27,R14,R15,R16,R17 | 13 | 10k |  | Resistor_SMD:R_0805_2012Metric_Pad1.20x1.40mm_HandSolder | 87
R3,R7,R8,R10,R13 | 5 | 0 | DNP | Resistor_SMD:R_0805_2012Metric_Pad1.20x1.40mm_HandSolder | 93
R4,R5,R6,R11,R12,R21,R22,R28 | 8 | 0 |  | Resistor_SMD:R_0805_2012Metric_Pad1.20x1.40mm_HandSolder | 93
R23,R25 | 2 | 5.1k |  | Resistor_SMD:R_0805_2012Metric_Pad1.20x1.40mm_HandSolder | 98
R29,R30,R33 | 3 | 2k |  | Resistor_SMD:R_0805_2012Metric_Pad1.20x1.40mm_HandSolder | 0 | 10 | https://www.mouser.com/ProductDetail/TE-Connectivity-Holsworthy/CRG0805F2K0
R31,R32,R34,R35,R36,R37,R38,R39,R40,R41,R42,R43,R44,R45,R46,R47,R48,R49,R50,R51,R52,R53,R54,R55 | 24 | 6.2 |  | Resistor_SMD:R_0805_2012Metric_Pad1.20x1.40mm_HandSolder | 0 | 100 | https://www.mouser.com/ProductDetail/KOA-Speer/RK73H2ATTD6R20F
SW1,SW2 | 2 | SW_Push |  | Button_Switch_THT:SW_PUSH_6mm | 100
TP1,TP2,TP3,TP4,TP5,TP6,TP7,TP8,TP9,TP10,TP11,TP12,TP13,TP14,TP15,TP16,TP17,TP18,TP19,TP20,TP21,TP22,TP23,TP24,TP25 | 25 | TestPoint_Small |  | TestPoint:TestPoint_Pad_D1.0mm | 100
Y1 | 1 | ECS-250-18-36B2-CTY-TR |  | Quartz 25MHz:ECS2501836B2CTYTR_custom |  | 2 | https://www.mouser.com/ProductDetail/ECS/ECS-250-18-36B2-CTY-TR?qs=aP1CjGhiNiFniXuPEM212w%3D%3D
Y2 | 1 | CM9V-T1A-32.768KHZ-12.5PF-20PPM-TA-QC |  | Quartz 32.768KHz:CM9VT1A |  | 2 | https://www.mouser.com/ProductDetail/Micro-Crystal/CM9V-T1A-32.768kHz-12.5pF-20PPM-TA-QC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
