capopaul/Toxic-Detection-PCB/doc/components/STM32H755/dev_board_nucleo/mb1363/MB1363C/MB1363-H745ZIQ-C01_BOM.xlsx

 |  |  | Bill of materials
 |  |  | Board reference: | MB1363
 |  |  | Variant: | H745ZIQ
 |  |  | PCB revision: | C
 |  |  | Assembly revision: | 01
 |  |  | Date: | 14/02/2019
Designator | Description | Package | Manufacturer | Manufacturer_Part_Number | Fitted | Quantity
LD4 | LED Bicolor |  | AVAGO TECHNOLOGIES | HSMF-A201-A00J1 | Fitted | 1
U17 | Discrete Magnetic Transformer Module, 16 pins, SMT, 100 Base-TX |  | DONGGUAN KEYOUDA ELECTRONIC TECHNOLOGY | KMS-1102NL | Fitted | 1
CN14 | RJ45 jack, single port, with LEDS, Metal shielded dip low profile |  | DONGGUAN KEYOUDA ELECTRONIC TECHNOLOGY | KRJ-CB4.2GYZNL | Fitted | 1
LD6 | LED, Red, 0603 | LED 0603 | EVERLIGHT | 19-213-R6C-AP1Q2B/3T | Fitted | 1
CN13 | USB-MICRO-AB Receptacle, RA, SMT + DIP, Standard, Top Mount, USB certified (symbol & footprint compatible with MCD-00022) |  | HIROSE | ZX62RD-AB-5P8(30) | Fitted | 1
HW9 | Blue Hat for switch TD0341X-G01-BLU |  | JIUBABA | 988.16.09.3.00002_SH-517 | Fitted | 1
HW11 | Black Hat for switch TD0341X-G01-BLA |  | JIUBABA | 988.16.09.3.00003_SH-517 | Fitted | 1
U15 | 10/100M RMII Ethernet transceiver |  | MICROCHIP | LAN8742A-CZ-TR | Fitted | 1
CN1 | USB-MICRO-B, 0.65mm, RA, SMT, Bottom Mount, |  | MOLEX | 1050170001 | Fitted | 1
L1 | Inductor, 2.2uH, 20%, Isat 1.2A, DCR 0.228Ohm, 0805 | L0805 | MURATA | DFE201210U-2R2M=P2 | Fitted | 1
C80 | Capacitor, MLCC, 1uF, 6V3, X5R, 10%, 0402, T=0,5mm | C0402 | MURATA | GRM155R61E105KA12 | Fitted | 1
C75 | Capacitor, MLCC, 10uF, 6V3, X5R, 20%, 0603, T=0,8mm | C0603 | MURATA | GRM188R60J106ME47D | Fitted | 1
C87 | Capacitor, MLCC, 10µF, 10V, X5R, 10%, 0603, T=0.8mm | C0603 | MURATA | GRM188R61A106KAAL | Fitted | 1
C39, C43, C45, C67 | Capacitor, MLCC, 4.7µF, 10V, X5R, 20%, 0603, T=0,8mm | C0603 | MURATA | GRM188R61A475ME15 | Fitted | 4
C40 | Capacitor, MLCC, 4.7uF, 16V, X5R, 20%, 0603, T=0,8mm | C0603 | MURATA | GRM188R61C475KE11 | Fitted | 1
HW20 | BLISTER CARD |  | n/a | n/a | Fitted | 1
HW21 | BLISTER |  | n/a | n/a | Fitted | 1
X4 | Crystal 25MHz, 6pF, +-20ppm, 80ohms max, SMD | NX2016SA | NDK | NX2016SA 25MHz EXS00A-CS11321 | Fitted | 1
X3 | Crystal 32.768kHz, 6pF, +-20ppm, 50Kohms max, SMD |  | NDK | NX3215SA 32.768KHz EXS00A-MU00525 | Fitted | 1
X1 | Oscillator 25Mhz, +-50ppm, Vcc:3.3V typ, square wave: [0.1Vcc;0.9Vcc], Enable pin, SMD |  | NDK | NZ2520SH 25MHz END4869C | Fitted | 1
Q1, Q2, Q3, T1 | NPN Bipolar Transistor | SOT23 | ON SEMICONDUCTOR | BSR14 | Fitted | 4
LD1, LD5, LD8 | LED Green, 0603 SMD, Forward Voltage Typ=2V, Max=2.5V | LED 0603 | OSRAM OPTO SEMICONDUCTORS | LG Q396-PS-35 | Fitted | 3
LD3 | LED Red, 0603 SMD, Forward Voltage Typ=2V, Max=2.5V | LED 0603 | OSRAM OPTO SEMICONDUCTORS | LS Q976-NR-1 | Fitted | 1
LD2 | LED Yellow, 0603 SMD, Forward Voltage min=1.7V, Typ=2V, Max=2.3V |  | OSRAM OPTO SEMICONDUCTORS | LY Q396-P1Q2-36 | Fitted | 1
CN5 | Header 5x2, 1.27mm, Dual row, Straight, Surface mount, vertical male connector. 3.05mm lead. Mates with FFSD connector. Footprint compatible with FTSH-107-01-L-DV,-K,-A,-P,-ES (STDC14 MEDIUM) |  | SAMTEC | FTSH-105-01-L-DV-K | Fitted | 1
HW1, HW2, HW3, HW4, HW6, HW7, HW8, HW12, HW13, HW14, HW15 | SHUNT 2.54mm BLACK |  | SAMTEC | SNT-100-BK-G | Fitted | 11
CN8 | Socket, 8x2, 2.54mm, VR, TH, Height 8.51mm/10mm, Low insertion force. |  | SAMTEC | SSW-108-23-x-D | Fitted | 1
CN7 | Socket, 10x2, 2.54mm, VR, TH, Height 8.51mm/10mm, Low insertion force. |  | SAMTEC | SSW-110-23-x-D | Fitted | 1
CN9 | Socket, 15x2, 2.54mm, VR, TH, Height 8.51mm/10mm, Low insertion force. |  | SAMTEC | SSW-115-23-x-D | Fitted | 1
CN10 | Socket, 17x2, 2.54mm, VR, TH, Height 8.51mm/10mm, Low insertion force |  | SAMTEC | SSW-117-23-x-D | Fitted | 1
JP1 | Header, 2x1, 2,54mm, VR, TH, Height 5.84mm/2.54mm |  | SAMTEC | TSW-102-07-x-S | Fitted | 1
JP3, JP4, JP6, JP7, JP8 | Header, 2x1, 2,54mm, VR, TH, Height 5.84mm/2.54mm - Shunt Fitted by default |  | SAMTEC | TSW-102-07-x-S | Fitted | 5
CN3, CN4, CN15, CN16 | Header, 2x1, 2,54mm, VR, TH, Height 5.84mm/10.16mm |  | SAMTEC | TSW-102-09-x-S | Fitted | 4
JP5 | Header, 3x1, 2,54mm, VR, TH, Height 5.84mm/2.54mm - Shunt Fitted 1-2 by default |  | SAMTEC | TSW-103-07-F-S | Fitted | 1
JP2 | Header, 4x2, 2,54mm, VR, TH, Height 5.84mm/2.54mm - Shunt Fitted 1-2 |  | SAMTEC | TSW-104-07-x-D | Fitted | 1
D1, D2, D3 | BAT60JFILM |  | STMICROELECTRONICS | BAT60JFILM | Fitted | 3
U5 | Common mode filter with ESD protection for USB 2.0 interface |  | STMICROELECTRONICS | ECMF02-2AMX6 | Fitted | 1
U6, U21 | High power transient voltage suppressor, 7V breakdown |  | STMICROELECTRONICS | ESDA7P60-1U1M | Fitted | 2
U3, U4, U20, U22, U23 | ESD protection 6V1 |  | STMICROELECTRONICS | ESDALC6V1-1U2 | Fitted | 5
U8, U24 | Dual Transil array for ESD protection |  | STMICROELECTRONICS | ESDALC6V1W5 | Fitted | 2
U12 | IC REG LDO 5V 0.8A SOT223 | SOT-223 | STMICROELECTRONICS | LD1117S50TR | Fitted | 1
U9 | Ultra low drop-low noise BiCMOS voltage, regulators low ESR capacitors compatible |  | STMICROELECTRONICS | LD3985M33R | Fitted | 1
U13 | LDO Linear Voltage Regulator IC Positive Adjustable 1 Output Adjustable 1.3A 6-DFN (3x3) | DFN6 (3x3) | STMICROELECTRONICS | ST1L05BPUR | Fitted | 1
U11 | LDO, 3.3V, 1.3A, Very low quiescent current BiCMOS voltage regulator | DFN6-3x3 | STMICROELECTRONICS | ST1L05CPU33R | Fitted | 1
U7 | STM32F723IEK (STM32F7) BGA176 |  | STMICROELECTRONICS | STM32F723IEK6 | Fitted | 1
U14 | STM32H745ZIT6U, LQFP144 package, 20x20 | LQFP144 20x20 | STMICROELECTRONICS | STM32H745ZIT6U | Fitted | 1
U18 | Enhanced single channel power switches with active low enable pin |  | STMICROELECTRONICS | STMPS2141STR | Fitted | 1
U2 | 500mA, Enhanced single channel power switches with active high enable pin |  | STMICROELECTRONICS | STMPS2151STR | Fitted | 1
U19 | Very low capacitance ESD protection |  | STMICROELECTRONICS | USBLC6-2SC6 | Fitted | 1
U16 | Very low capacitance ESD protection , 4 lines |  | STMICROELECTRONICS | USBLC6-4SC6 | Fitted | 1
L2 | SMD Chip ferrite bead, 600R@100MHz +/-25%, 350mA, 500mohm DC, 0603, T=0.8mm |  | TAI-TECH | FCM1608KF-601T03 | Fitted | 1
U1, U10 | Dual bit dual supply bus transceiver |  | TEXAS INSTRUMENTS | SN74LVC2T45DCUT | Fitted | 2
LD7 | LED Red, 0603 SMD, 2V Forward Voltage | LED 0603 | VISHAY | VLMS1300-GS08 | Fitted | 1
B1 | Non-Open Push-Button 0.1A 24V |  | WEALTHMETAL | TD-0341 | Fitted | 1
B2 | Non-Open Push-Button 0.1A 24V BLACK |  | WEALTHMETAL | TD-0341 | Fitted | 1
C81, C83 | Capacitor, MLCC, 5.6pF, 50V, NPO, 5%, 0402, T=0,5mm | C0402 | YAGEO | CC0402BRNPO9BN5R6 | Fitted | 2
C6 | Capacitor, MLCC, 100pF, 50V, NPO, 5%, 0402, T=0,5mm | C0402 | YAGEO | CC0402JRNPO9BN101 | Fitted | 1
C5 | Capacitor, MLCC, 20pF, 50V, NPO, 5%, 0402, T=0,5mm | C0402 | YAGEO | CC0402JRNPO9BN200 | Fitted | 1
C64 | Capacitor, MLCC, 220pF, 50V, NPO, 5%, 0402, T=0,5mm | C0402 | YAGEO | CC0402JRNPO9BN221 | Fitted | 1
C82 | Capacitor, MLCC, 470pF, 50V, NPO, 5%, 0402, T=0,5mm | C0402 | YAGEO | CC0402JRNPO9BN471 | Fitted | 1
C19 | Capacitor, MLCC, 10nF, 16V, X7R, 10%, 0402, T=0.5mm | C0402 | YAGEO | CC0402KRX7R7BB103 | Fitted | 1
C38, C44, C46, C47, C48, C49, C50, C51, C52, C53, C54, C55, C56, C57, C58, C59, C71, C73 | Capacitor, MLCC, 100nF, 16V, X7R, 10%, 0402, T=0.5mm | C0402 | YAGEO | CC0402KRX7R7BB104 | Fitted | 18
C8, C9, C10, C11, C14, C15, C16, C17, C20, C21, C22, C24, C25, C28, C29, C30, C31, C32, C33, C34, C37 | Capacitor, MLCC, 100nF, 16V, X7R, 10%, 0402, T=0,5mm | C0402 | YAGEO | CC0402KRX7R7BB104 | Fitted | 21
C65, C68 | Capacitor, MLCC, 10uF, 6V3, X5R, 20%, 0402, T=0.5mm | C0402 | YAGEO | CC0402MRX5R5BB106 | Fitted | 2
C26, C27, C60, C66, C70, C79, C84, C85, C86, C88, C89 | Capacitor, MLCC, 100nF, 6V3, X5R, 10%, 0603, T=0,8mm | C0603 | YAGEO | CC0603KRX5R5BB104 | Fitted | 11
C1, C3, C18, C63, C69, C72 | Capacitor, MLCC, 1uF, 6V3, X5R, 10%, 0603, T=0,8mm | C0603 | YAGEO | CC0603KRX5R5BB105 | Fitted | 6
C7, C12, C13 | Capacitor, MLCC, 2.2uF, 10V, X5R, 10%, 0603, T=0,8mm | C0603 | YAGEO | CC0603KRX5R6BB225 | Fitted | 3
C23, C36 | Capacitor, MLCC, 1uF, 16V, X5R, 10%, 0603, T=0,8mm | C0603 | YAGEO | CC0603KRX5R7BB105 | Fitted | 2
C35, C91 | Capacitor, MLCC, 4.7uF, 16V, X5R, 10%, 0603, T=0.8mm | C0603 | YAGEO | CC0603KRX5R7BB475 | Fitted | 2
C2, C4 | Capacitor, MLCC, 100nF, 16V, X7R, 10%, 0603, T=0,8mm | C0603 | YAGEO | CC0603KRX7R7BB104 | Fitted | 2
C41, C42 | Capacitor, MLCC, 10uF, 25V, X5R, 10%, 0805, T=0,85mm | C0805 | YAGEO | CC0805KRX5R8BB106 | Fitted | 2
C90 | Capacitor, MLCC, 1nF, 2KV, X7R, 10%, 1206, T=1,25mm | C1206 | YAGEO | CC1206KKX7RDBB102 | Fitted | 1
R5, R17, R21 | Resistor,100R,0402,1%,1/16W | R0402 | YAGEO | RC0402FR-07100RL | Fitted | 3
R22, R24, R25, R30, R43, R45, R46, R49, R51, R60, R63, R66 | Resistor,10K,0402,1%,1/16W | R0402 | YAGEO | RC0402FR-0710KL | Fitted | 12
R54 | Resistor,12K1,0402,1%,1/16W | R0402 | YAGEO | RC0402FR-0712K1L | Fitted | 1
R50 | Resistor,1K5,0402,1%,1/16W | R0402 | YAGEO | RC0402FR-071K5L | Fitted | 1
R28, R61, R62, R69 | Resistor,270R,0402,1%,1/16W | R0402 | YAGEO | RC0402FR-07270RL | Fitted | 4
R31 | Resistor,27K,0402,1%,1/16W | R0402 | YAGEO | RC0402FR-0727KL | Fitted | 1
R15 | Resistor,2K7,0402,1%,1/16W | R0402 | YAGEO | RC0402FR-072K7L | Fitted | 1
R44, R47, R48, R52 | Resistor,33R,0402,1%,1/16W | R0402 | YAGEO | RC0402FR-0733RL | Fitted | 4
R68 | Resistor,360R,0402,1%,1/16W | R0402 | YAGEO | RC0402FR-07360RL | Fitted | 1
R6 | Resistor,3K,0402,1%,1/16W | R0402 | YAGEO | RC0402FR-073KL | Fitted | 1
R59, R64, R65 | Resistor,47K,0402,1%,1/16W | R0402 | YAGEO | RC0402FR-0747KL | Fitted | 3
R3, R10, R11, R13, R23, R29 | Resistor,47R,0402,1%,1/16W | R0402 | YAGEO | RC0402FR-0747RL | Fitted | 6
R78, R79, R80, R81 | Resistor,49R9,0402,1%,1/16W | R0402 | YAGEO | RC0402FR-0749R9L | Fitted | 4
R14, R18, R20 | Resistor,4K7,0402,1%,1/16W | R0402 | YAGEO | RC0402FR-074K7L | Fitted | 3
R32 | Resistor,56K,0402,1%,1/16W | R0402 | YAGEO | RC0402FR-0756KL | Fitted | 1
R55, R56 | Resistor,75R,0402,1%,1/16W | R0402 | YAGEO | RC0402FR-0775RL | Fitted | 2
R35, R53 | Resistor,0R,0402,5%,1/16W | R0402 | YAGEO | RC0402JR-070RL | Fitted | 2
SB14, SB37 | Solder Bridge 0402 ON | SB0402 | YAGEO | RC0402JR-070RL | Fitted | 2
R1, R4, R67, R71, R72, R73 | Resistor,100K,0603,1%,1/10W | R0603 | YAGEO | RC0603FR-07100KL | Fitted | 6
R7, R36, R37 | Resistor,10K,0603,1%,1/10W | R0603 | YAGEO | RC0603FR-0710KL | Fitted | 3
R2 | Resistor,1K,0603,1%,1/10W | R0603 | YAGEO | RC0603FR-071KL | Fitted | 1
R8, R9, R77 | Resistor,330R,0603,1%,1/10W | R0603 | YAGEO | RC0603FR-07330RL | Fitted | 3
R26 | Resistor,360R,0603,1%,1/10W | R0603 | YAGEO | RC0603FR-07360RL | Fitted | 1
R27 | Resistor,470R,0603,1%,1/10W | R0603 | YAGEO | RC0603FR-07470RL | Fitted | 1
R74, R75, R76 | Resistor,47K,0603,1%,1/10W | R0603 | YAGEO | RC0603FR-0747KL | Fitted | 3
R12 | Resistor,620R,0603,1%,1/10W | R0603 | YAGEO | RC0603FR-07620RL | Fitted | 1
R39, R40, R41, R42 | Resistor,0R,0603,5%,1/10W | R0603 | YAGEO | RC0603JR-070RL | Fitted | 4
SB1, SB2, SB6, SB7, SB11, SB16, SB17, SB18, SB19, SB21, SB26, SB27, SB28, SB29, SB30, SB31, SB32, SB33, SB34, SB35, SB36, SB40, SB41, SB42, SB43, SB45, SB46, SB48, SB49, SB50, SB51, SB52, SB53, SB54, SB57, SB59, SB60, SB61, SB63, SB68, SB69, SB72, SB73, SB75, SB76, SB79, SB80, SB82, SB83, SB84, SB85, SB86, SB87, SB88, SB89, SB92, SB93, SB96, SB98, SB100, SB103, SB104 | Solder Bridge ON | SB0603 | YAGEO | RC0603JR-070RL | Fitted | 62
X2 | Crystal 25MHz, 6pF, +-20ppm, 80ohms max, SMD | NX2016SA | NDK | NX2016SA 25MHz EXS00A-CS11321 | Not Fitted | 0
CN6 | Header, 4x2, 2,54mm, VR, TH, Height 5.84mm/2.54mm |  | SAMTEC | TSW-104-07-x-D | Not Fitted | 0
CN2 | Header, 4x1, 2,54mm, VR, TH, Height 5.84mm/2.54mm |  | SAMTEC | TSW-104-07-x-S | Not Fitted | 0
CN11, CN12 | Header, 35x2, 2,54mm, VR, TH, Height 5.84mm/2.54mm |  | SAMTEC | TSW-135-07-x-D | Not Fitted | 0
C74, C76 | Capacitor, MLCC, 5.6pF, 50V, NPO, 5%, 0402, T=0,5mm | C0402 | YAGEO | CC0402BRNPO9BN5R6 | Not Fitted | 0
C61, C62 | Capacitor, MLCC, 100nF, 16V, X7R, 10%, 0402, T=0.5mm | C0402 | YAGEO | CC0402KRX7R7BB104 | Not Fitted | 0
C77, C78 | Capacitor,5.1pF,0.25pF,50V,NPO,0603 | C0603 | YAGEO | CC0603CRNPO9BN5R1 | Not Fitted | 0
R70 | Resistor,100R,0402,1%,1/16W | R0402 | YAGEO | RC0402FR-07100RL | Not Fitted | 0
R57, R58 | Resistor,75R,0402,1%,1/16W | R0402 | YAGEO | RC0402FR-0775RL | Not Fitted | 0
R33, R34 | Resistor,0R,0402,5%,1/16W | R0402 | YAGEO | RC0402JR-070RL | Not Fitted | 0
SB13, SB24, SB38 | Solder Bridge 0402 ON | SB0402 | YAGEO | RC0402JR-070RL | Not Fitted | 0
R38 | Resistor,10K,0603,1%,1/10W | R0603 | YAGEO | RC0603FR-0710KL | Not Fitted | 0
SB3, SB4, SB5, SB8, SB9, SB10, SB12, SB15, SB20, SB22, SB23, SB25, SB39, SB44, SB47, SB55, SB56, SB58, SB62, SB64, SB65, SB66, SB67, SB70, SB71, SB74, SB77, SB78, SB81, SB90, SB91, SB94, SB95, SB97, SB99, SB101, SB102 | Solder Bridge ON | SB0603 | YAGEO | RC0603JR-070RL | Not Fitted | 0
