capopaul/Toxic-Detection-PCB/doc/components/ADC ADS7828/ADS7828E_2K5.stp

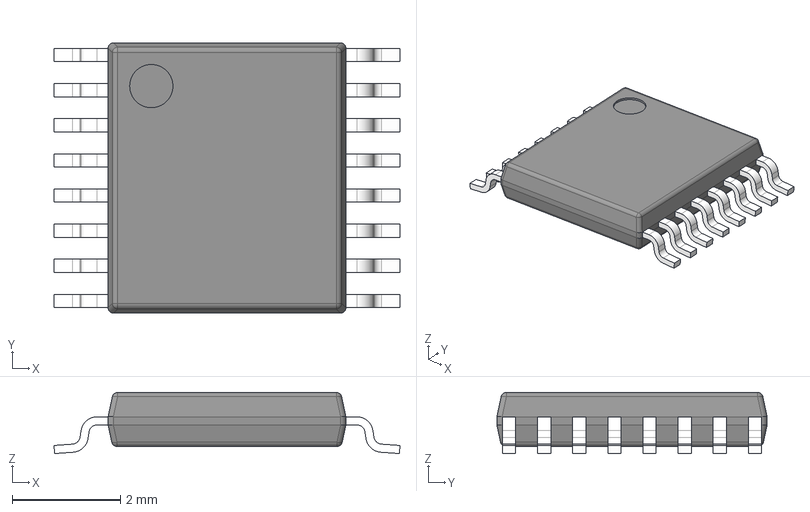
[picture p97: CAD file, 2026-02-09]
doc/components/ADC ADS7828/ADS7828E_2K5.stp
6.40 x 5.00 x 1.13 mm
BODY-TSSOP
LEAD-TSSOP x 16
PIN1
