capopaul/Toxic-Detection-PCB/doc/components/diode_1N5819/1N5819HW-7-F.stp

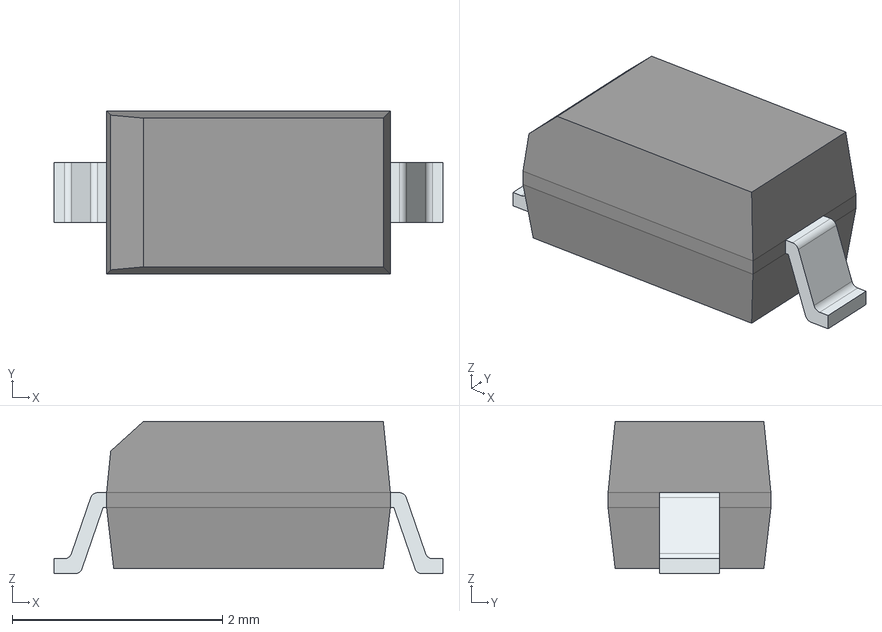
[picture p98: CAD file, 2026-02-13]
doc/components/diode_1N5819/1N5819HW-7-F.stp
3.70 x 1.55 x 1.45 mm
FilletPinL
FilletPinR
