capopaul/Toxic-Detection-PCB/doc/components/ESP32-WROOM-32E-N16/ESP32-WROOM-32E-N16.stp

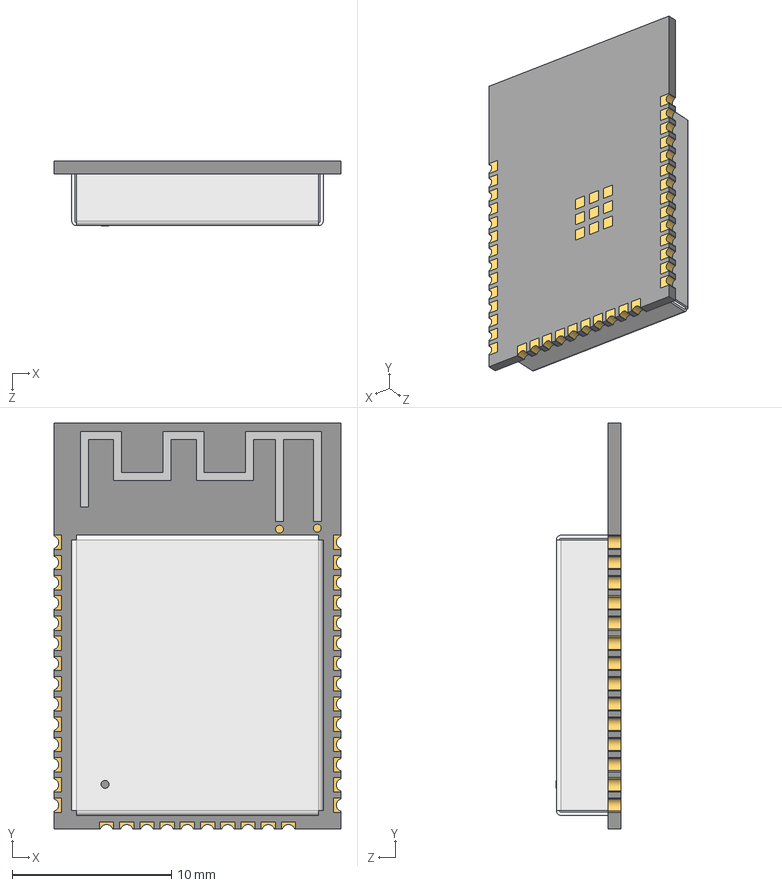
[picture p99: CAD file, 2026-02-09]
doc/components/ESP32-WROOM-32E-N16/ESP32-WROOM-32E-N16.stp
18.0 x 25.5 x 4.05 mm
Board
Top
Pieza143_26
Pieza143_15
Pieza143_9
Pieza143_28
Pieza143_42
Pieza143_36
Pieza143_1
Pieza143_19
Pieza143_32
Pieza143_12
Pieza143_6
Pieza143_18
Pieza143_29
Pieza143_10
Pieza143_40
Pieza143_35
Pieza143_41
Pieza143_24
Pieza143_8
Pieza143_14
Pieza143_22
Pieza143_30
Pieza143_23
Pieza143_45
Pieza143_46
Pieza143_25
Pieza143_33
Pieza143_3
Pieza143_20
Pieza143_2
Pieza143_39
Pieza143_11
Pieza143_34
Pieza143
Pieza143_16
Pieza143_38
Pieza143_17
Pieza143_5
Pieza143_37
Pieza143_44
Pieza143_7
Pieza143_27
Pieza143_13
Pieza143_43
Pieza143_21
Pieza143_31
Pieza143_4
Pieza144_2
Pieza144
Pieza144_1
Dot
