capopaul/Toxic-Detection-PCB/doc/components/GNSS module and antenna/SAM-M10Q-00B.stp

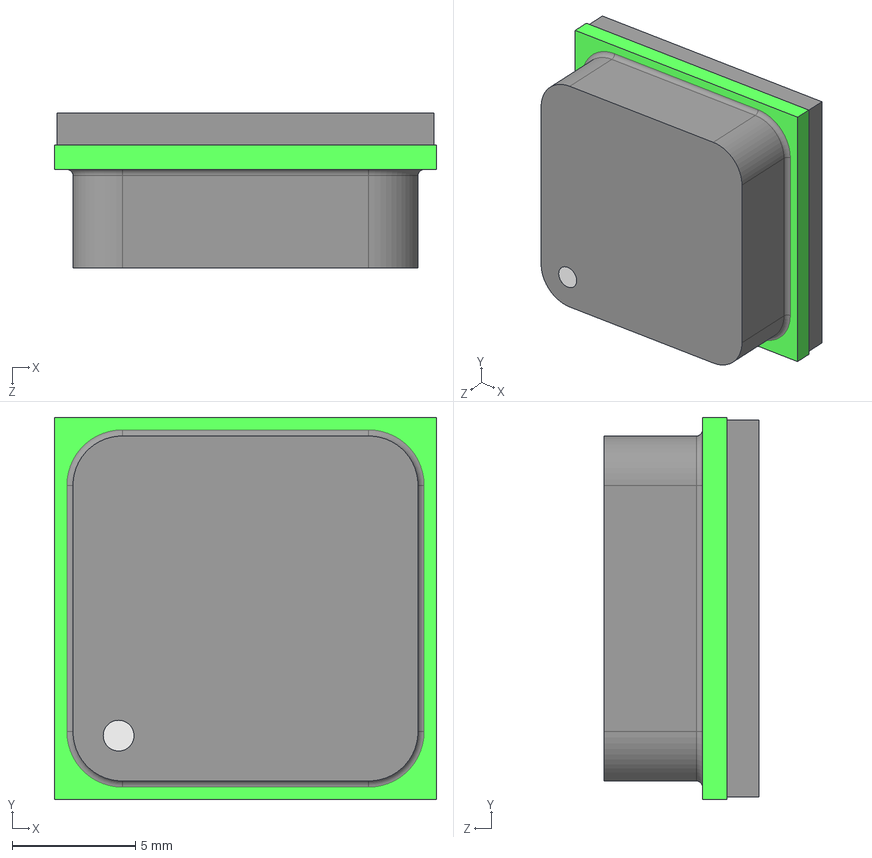
[picture p100: CAD file, 2026-02-12]
doc/components/GNSS module and antenna/SAM-M10Q-00B.stp
15.5 x 15.5 x 6.30 mm
