capopaul/Toxic-Detection-PCB/doc/components/jtag connector/FTSH-105-01-L-DV-K.stp

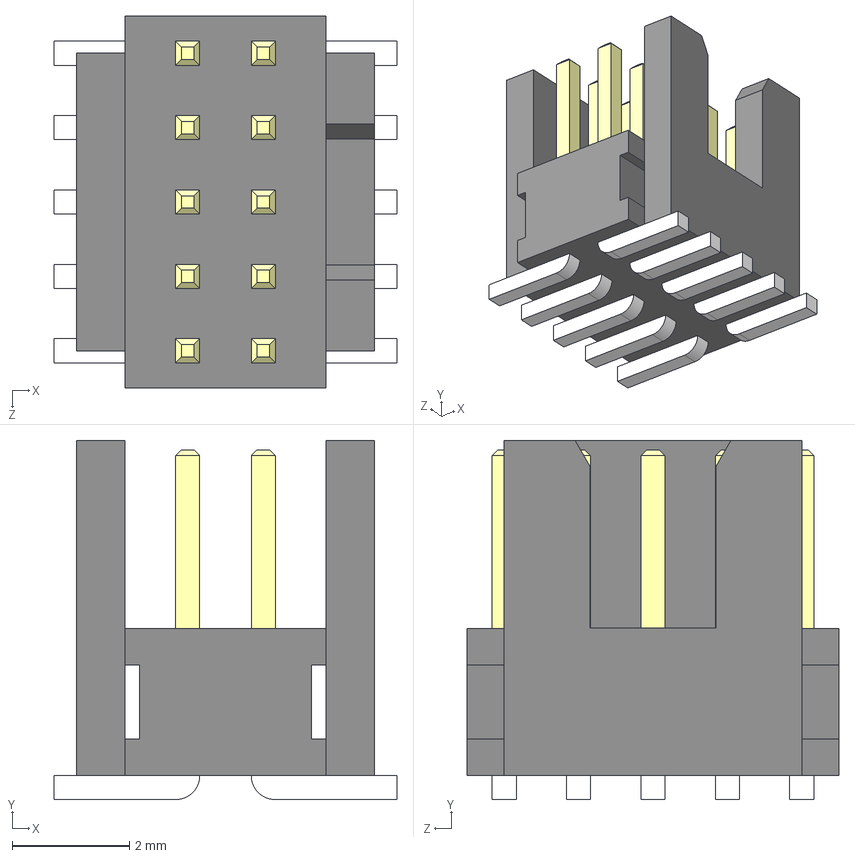
[picture p101: CAD file, 2026-03-03]
doc/components/jtag connector/FTSH-105-01-L-DV-K.stp
5.85 x 6.13 x 6.35 mm
