capopaul/Toxic-Detection-PCB/doc/components/LDO 3.3V/AZ1084CD-3.3TRG1.stp

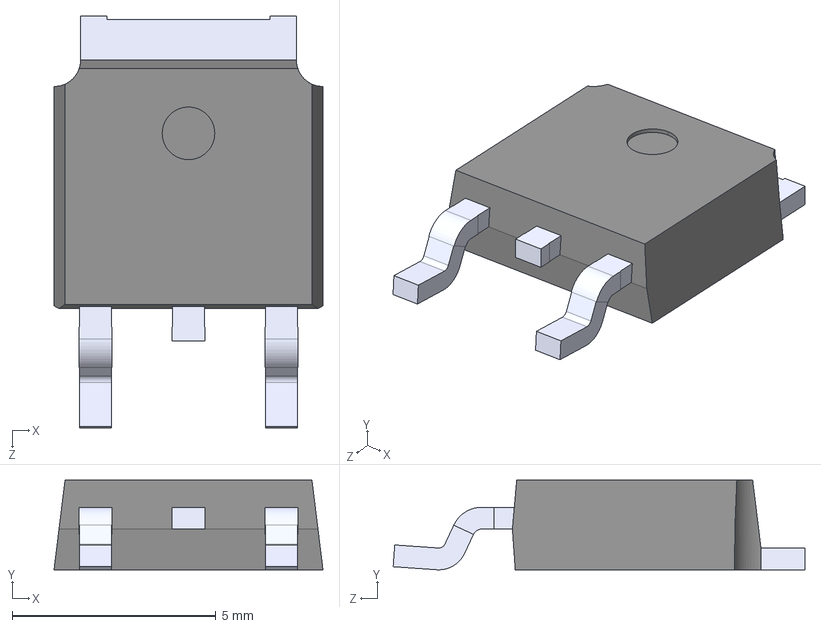
[picture p102: CAD file, 2026-03-17]
doc/components/LDO 3.3V/AZ1084CD-3.3TRG1.stp
6.60 x 2.20 x 10.1 mm
