capopaul/Toxic-Detection-PCB/doc/components/LDO 5V/AP2210K-5.0TRG1.stp

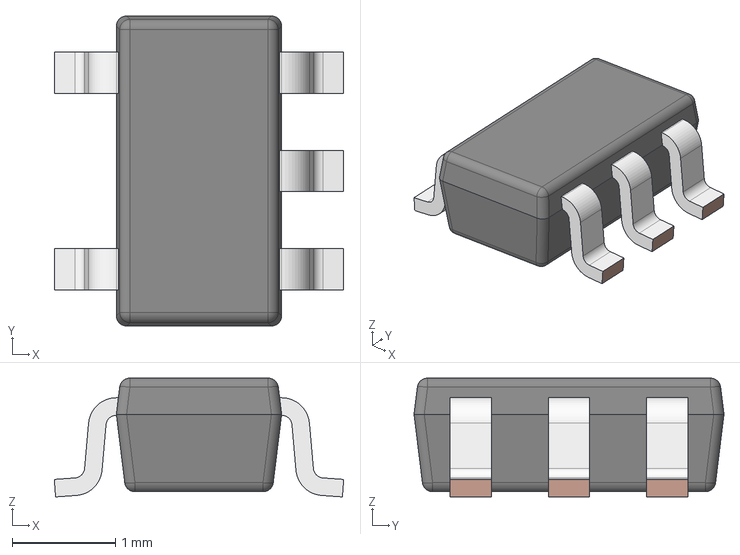
[picture p103: CAD file, 2026-02-10]
doc/components/LDO 5V/AP2210K-5.0TRG1.stp
2.80 x 3.00 x 1.15 mm
CPD
LDF
