capopaul/Toxic-Detection-PCB/doc/components/LED Green/APTD2012LCGCK.stp

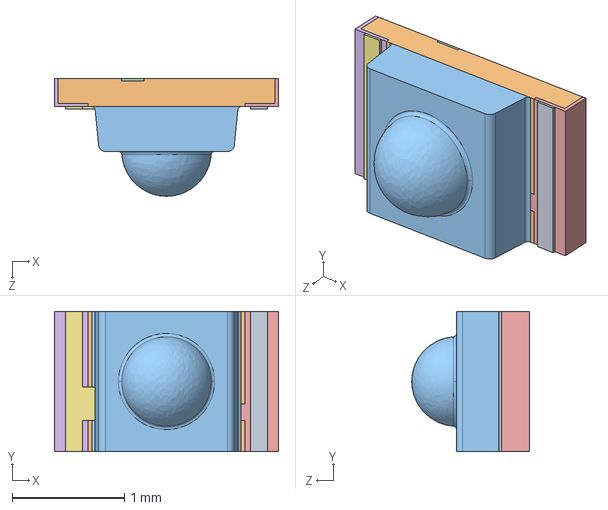
[picture p104: CAD file, 2026-02-12]
doc/components/LED Green/APTD2012LCGCK.stp
2.00 x 1.25 x 1.05 mm
