capopaul/Toxic-Detection-PCB/doc/components/NMOS-BSS138G/BSS138-G.stp

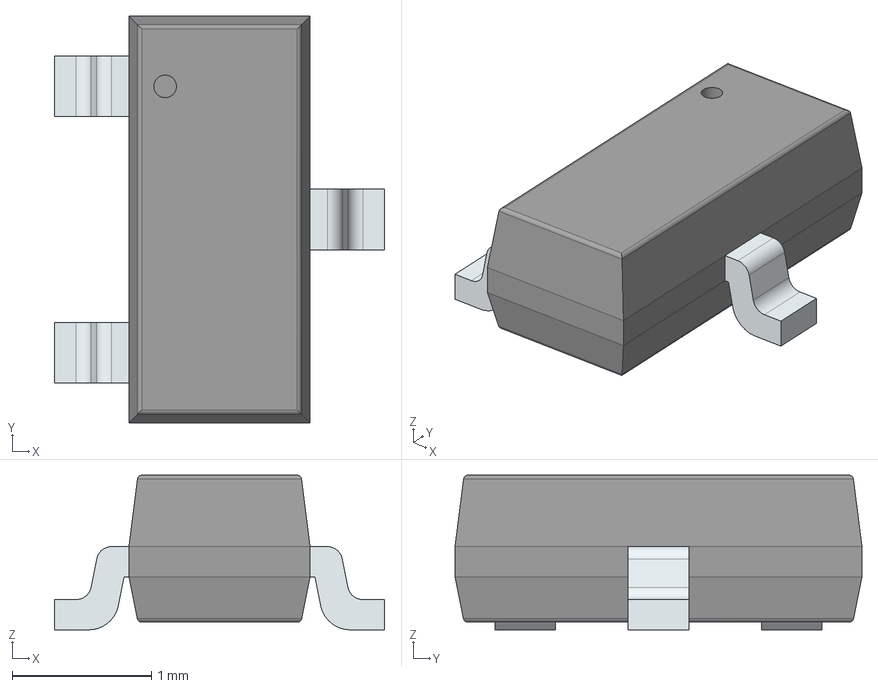
[picture p105: CAD file, 2026-02-09]
doc/components/NMOS-BSS138G/BSS138-G.stp
2.37 x 2.92 x 1.11 mm
PinsArrayL
FilletPinR
