capopaul/Toxic-Detection-PCB/doc/components/NOR Flash/AT25SF321B-SSHB-B.stp

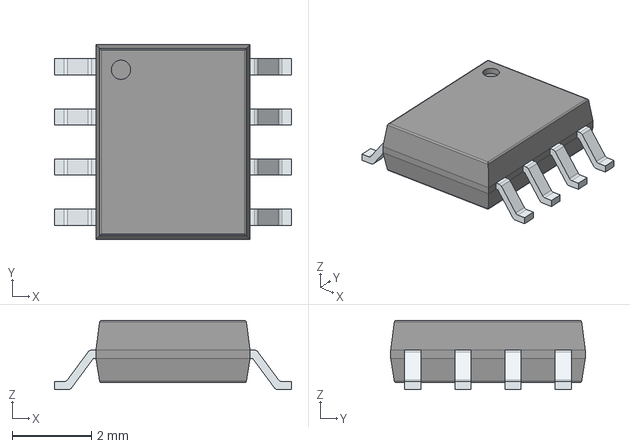
[picture p106: CAD file, 2026-02-12]
doc/components/NOR Flash/AT25SF321B-SSHB-B.stp
6.00 x 4.92 x 1.75 mm
PinsArrayLR
