capopaul/Toxic-Detection-PCB/doc/components/Power Gating TPS2054BDR/TPS2054BDR.stp

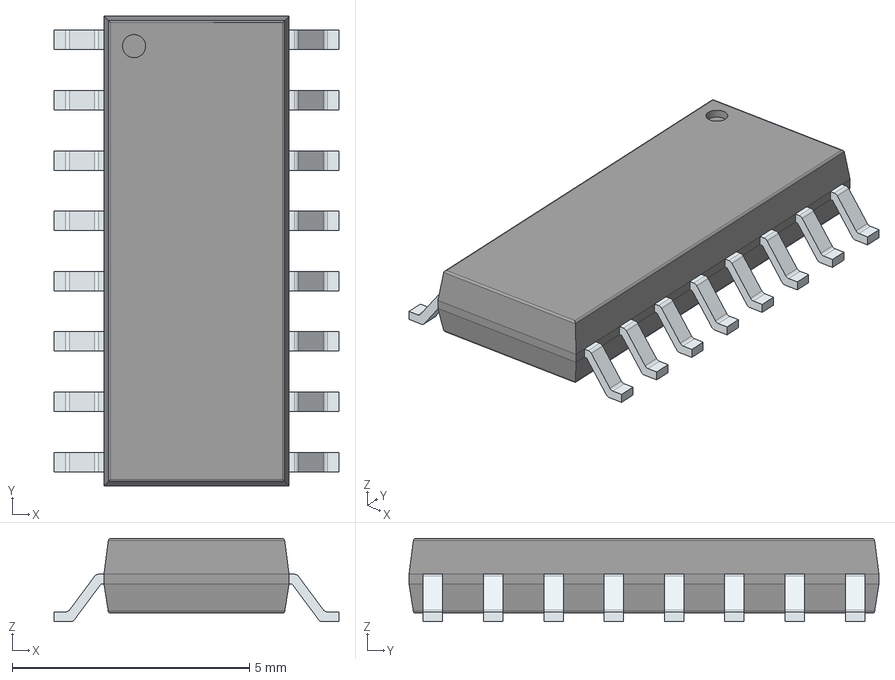
[picture p107: CAD file, 2026-02-10]
doc/components/Power Gating TPS2054BDR/TPS2054BDR.stp
6.00 x 9.90 x 1.75 mm
PinsArrayLR
