capopaul/Toxic-Detection-PCB/doc/components/Quartz 25MHz/ECS-250-18-36B2-CTY-TR.stp

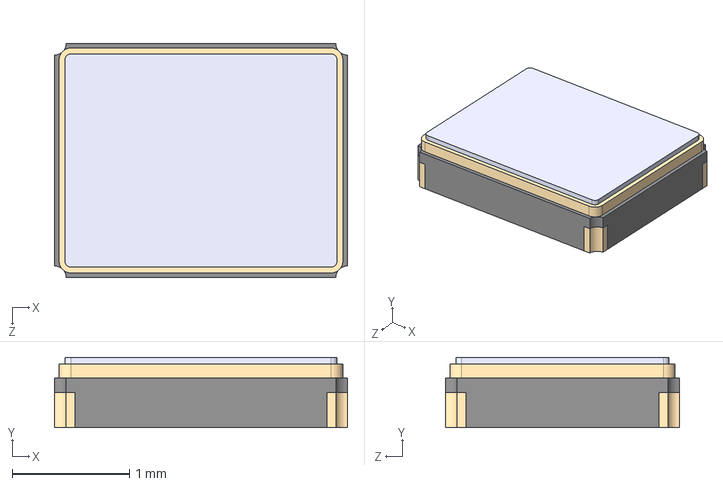
[picture p108: CAD file, 2026-02-09]
doc/components/Quartz 25MHz/ECS-250-18-36B2-CTY-TR.stp
2.50 x 0.6 x 2.00 mm
