capopaul/Toxic-Detection-PCB/doc/components/Quartz 32.768KHz/CM9V-T1A-32.768KHZ-12.5PF-20PPM-TA-QC.stp

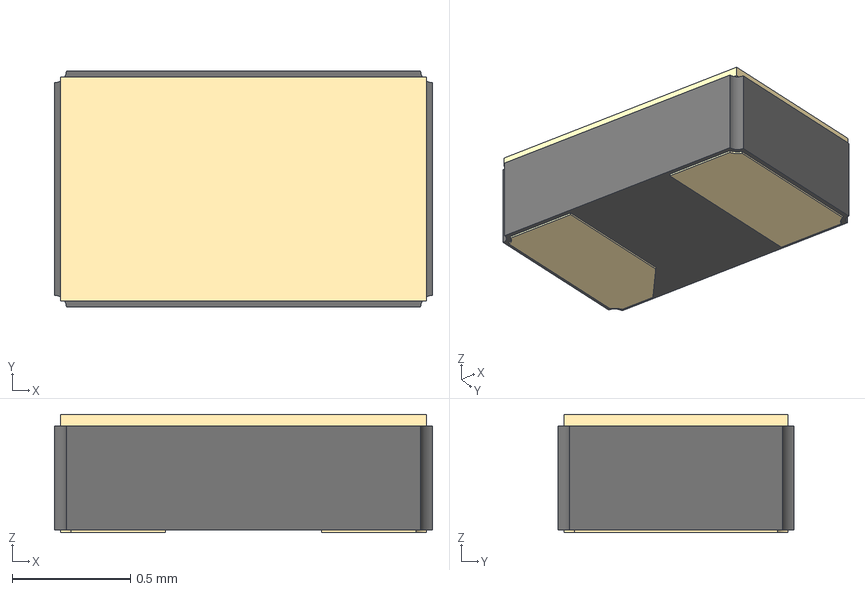
[picture p109: CAD file, 2026-02-09]
doc/components/Quartz 32.768KHz/CM9V-T1A-32.768KHZ-12.5PF-20PPM-TA-QC.stp
1.60 x 1.00 x 0.5 mm
Rect2
Terminal
