capopaul/Toxic-Detection-PCB/doc/components/USB_ESD_protection/DT1042-02SR-7.stp

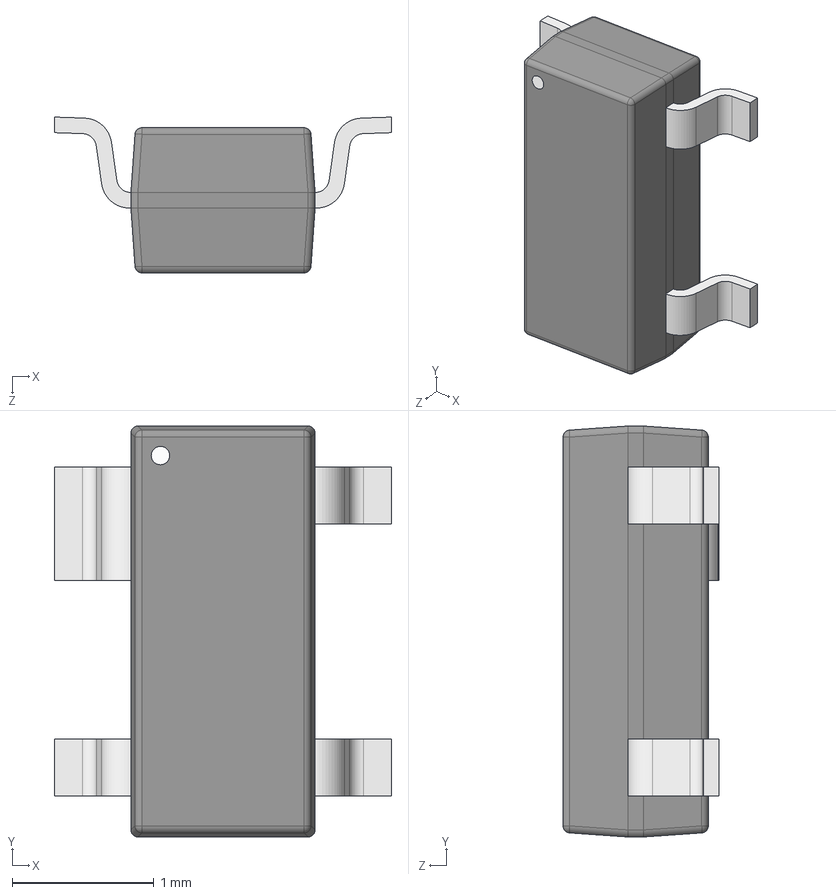
[picture p110: CAD file, 2026-02-09]
doc/components/USB_ESD_protection/DT1042-02SR-7.stp
2.38 x 2.90 x 1.10 mm
