capopaul/Toxic-Detection-PCB/doc/components/LDO 5V/NCP716BCSN500T1G.stp

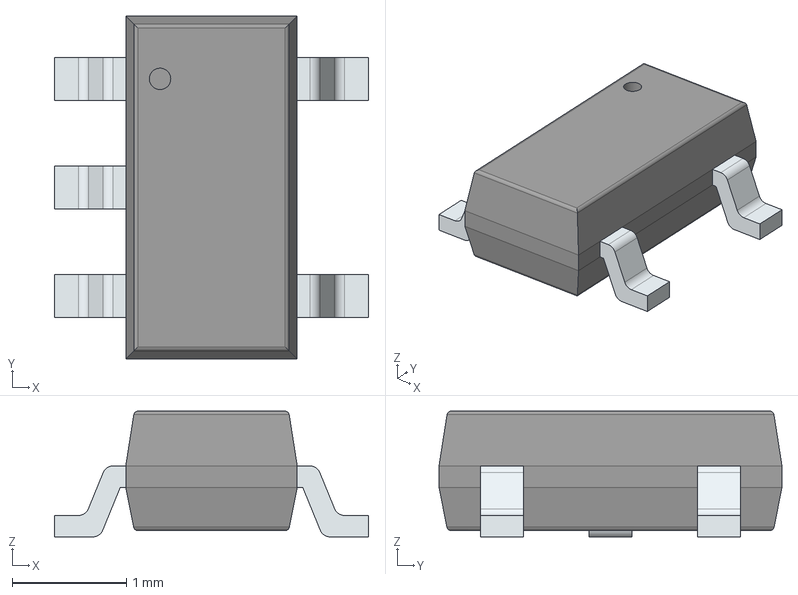
[picture p111: CAD file, 2026-02-09]
doc/components/LDO 5V/NCP716BCSN500T1G.stp
2.75 x 3.00 x 1.10 mm
PinsArrayL
PinsArrayR
