capopaul/Toxic-Detection-PCB/doc/components/AFE Connector 79107-7204/79107-7204.stp

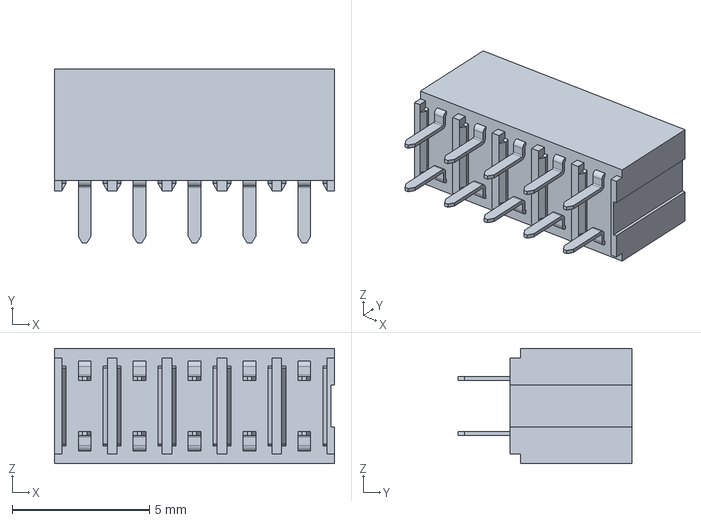
[picture p112: CAD file, 2026-02-10]
doc/components/AFE Connector 79107-7204/79107-7204.stp
10.2 x 6.35 x 4.19 mm
