capopaul/Toxic-Detection-PCB/doc/components/AFE Connector 79107-7205/79107-7205.stp

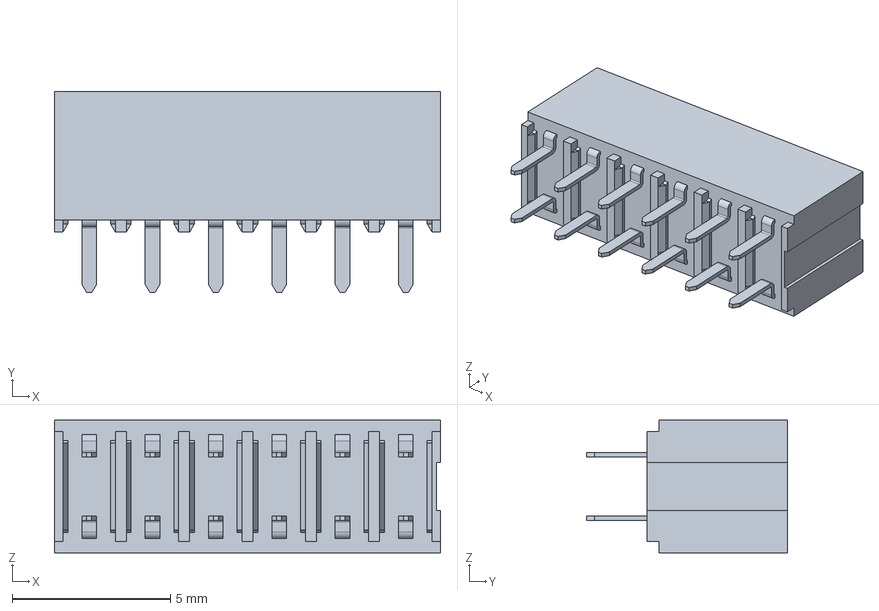
[picture p113: CAD file, 2026-02-10]
doc/components/AFE Connector 79107-7205/79107-7205.stp
12.2 x 6.35 x 4.19 mm
