capopaul/Toxic-Detection-PCB/(list of files, cad)

Other CAD files:
doc/components/TVS_diodes/ESDA6V1U1RL.stp
doc/components/USB-C connector/105450-0101.stp
