capopaul/Toxic-Detection-PCB/doc/schematic_v4.3.pdf

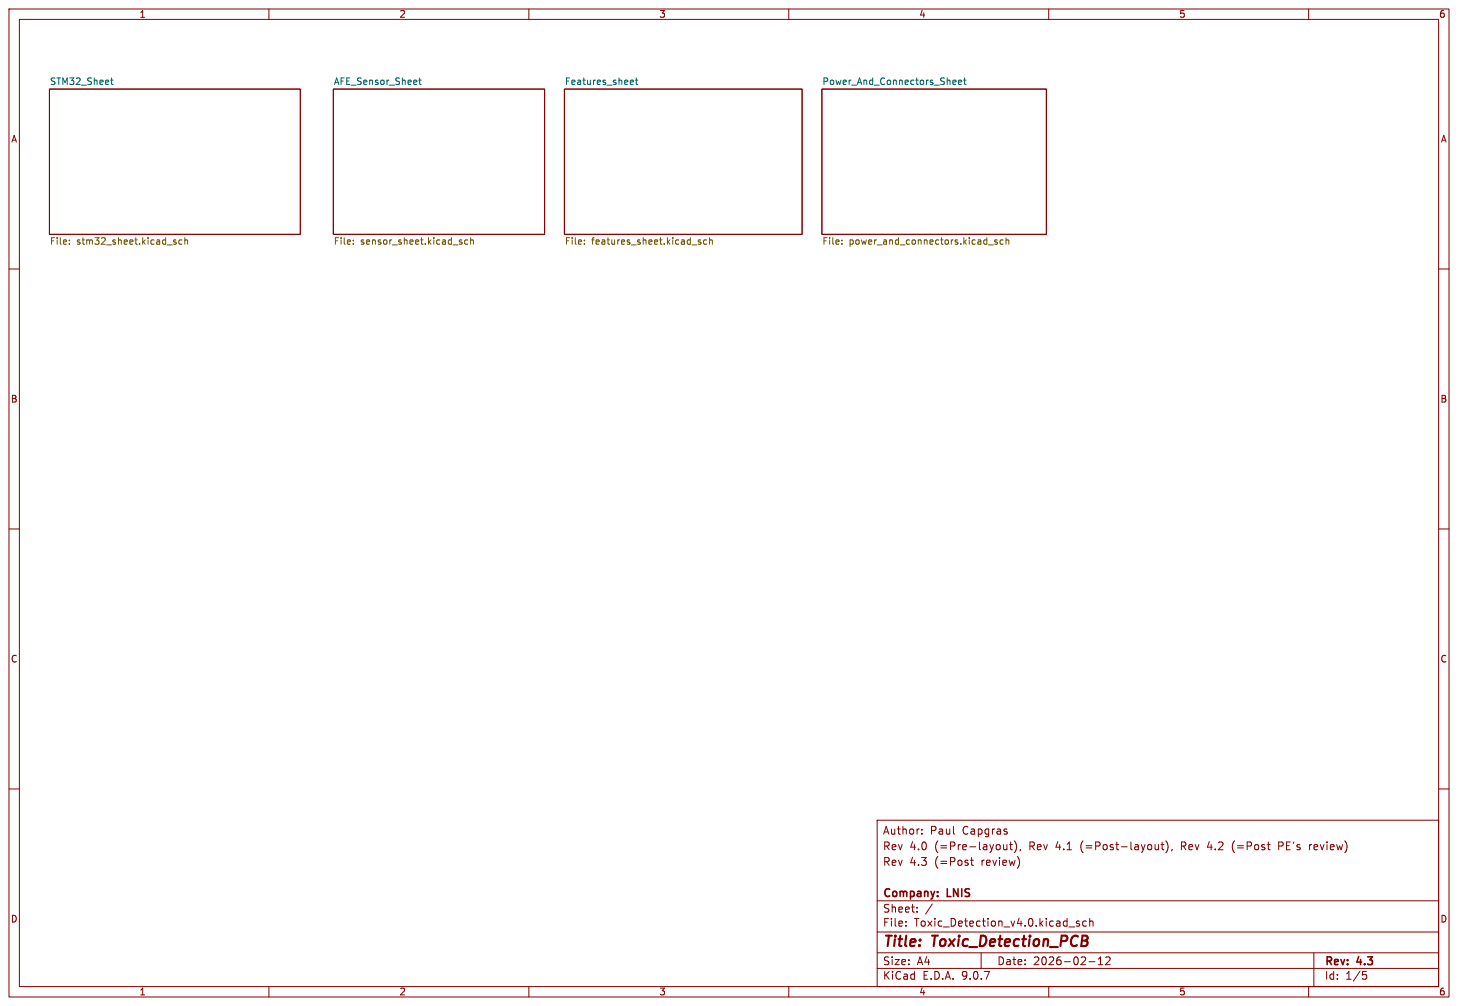
[picture p114: page 1]

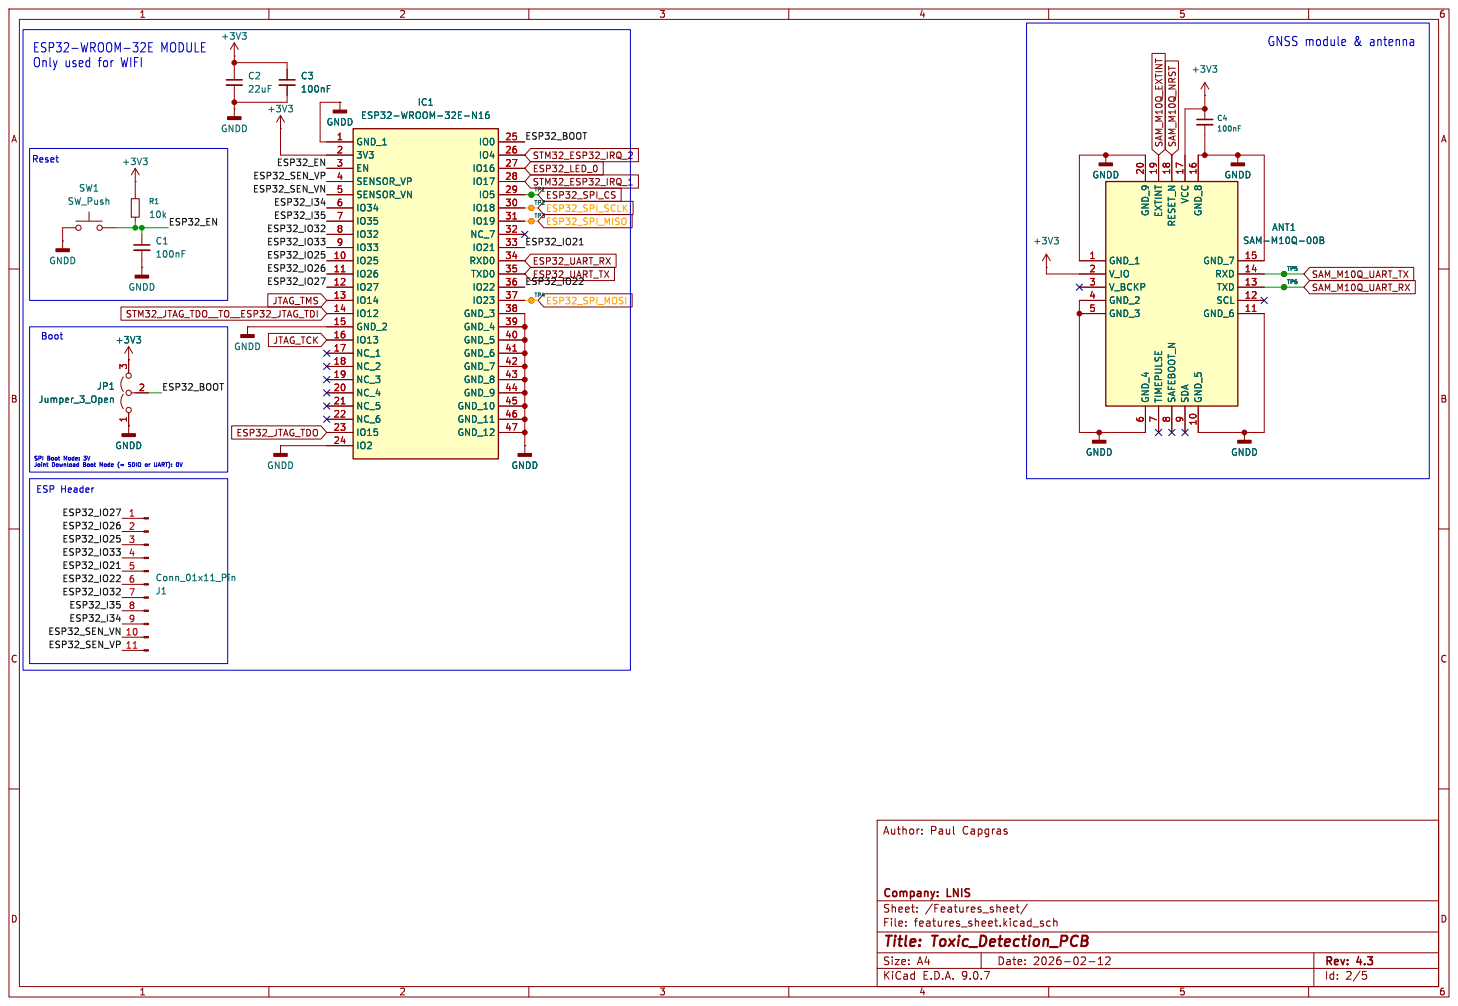
[picture p115: page 2]

Only used for WIFI Reset Boot SPI Boot Mode: 3V
22uF GNDD

9 GND_8 16 GND_5 10 GND_7 15 RXD 14 TXD 13 SCL 12 GND_6 11 ANT1 SAM-M10Q-00B GNDD GNDD

9 GND_8 16 GND_5 10 GND_7 15 RXD 14 TXD 13 SCL 12 GND_6 11 GNDD GNDD

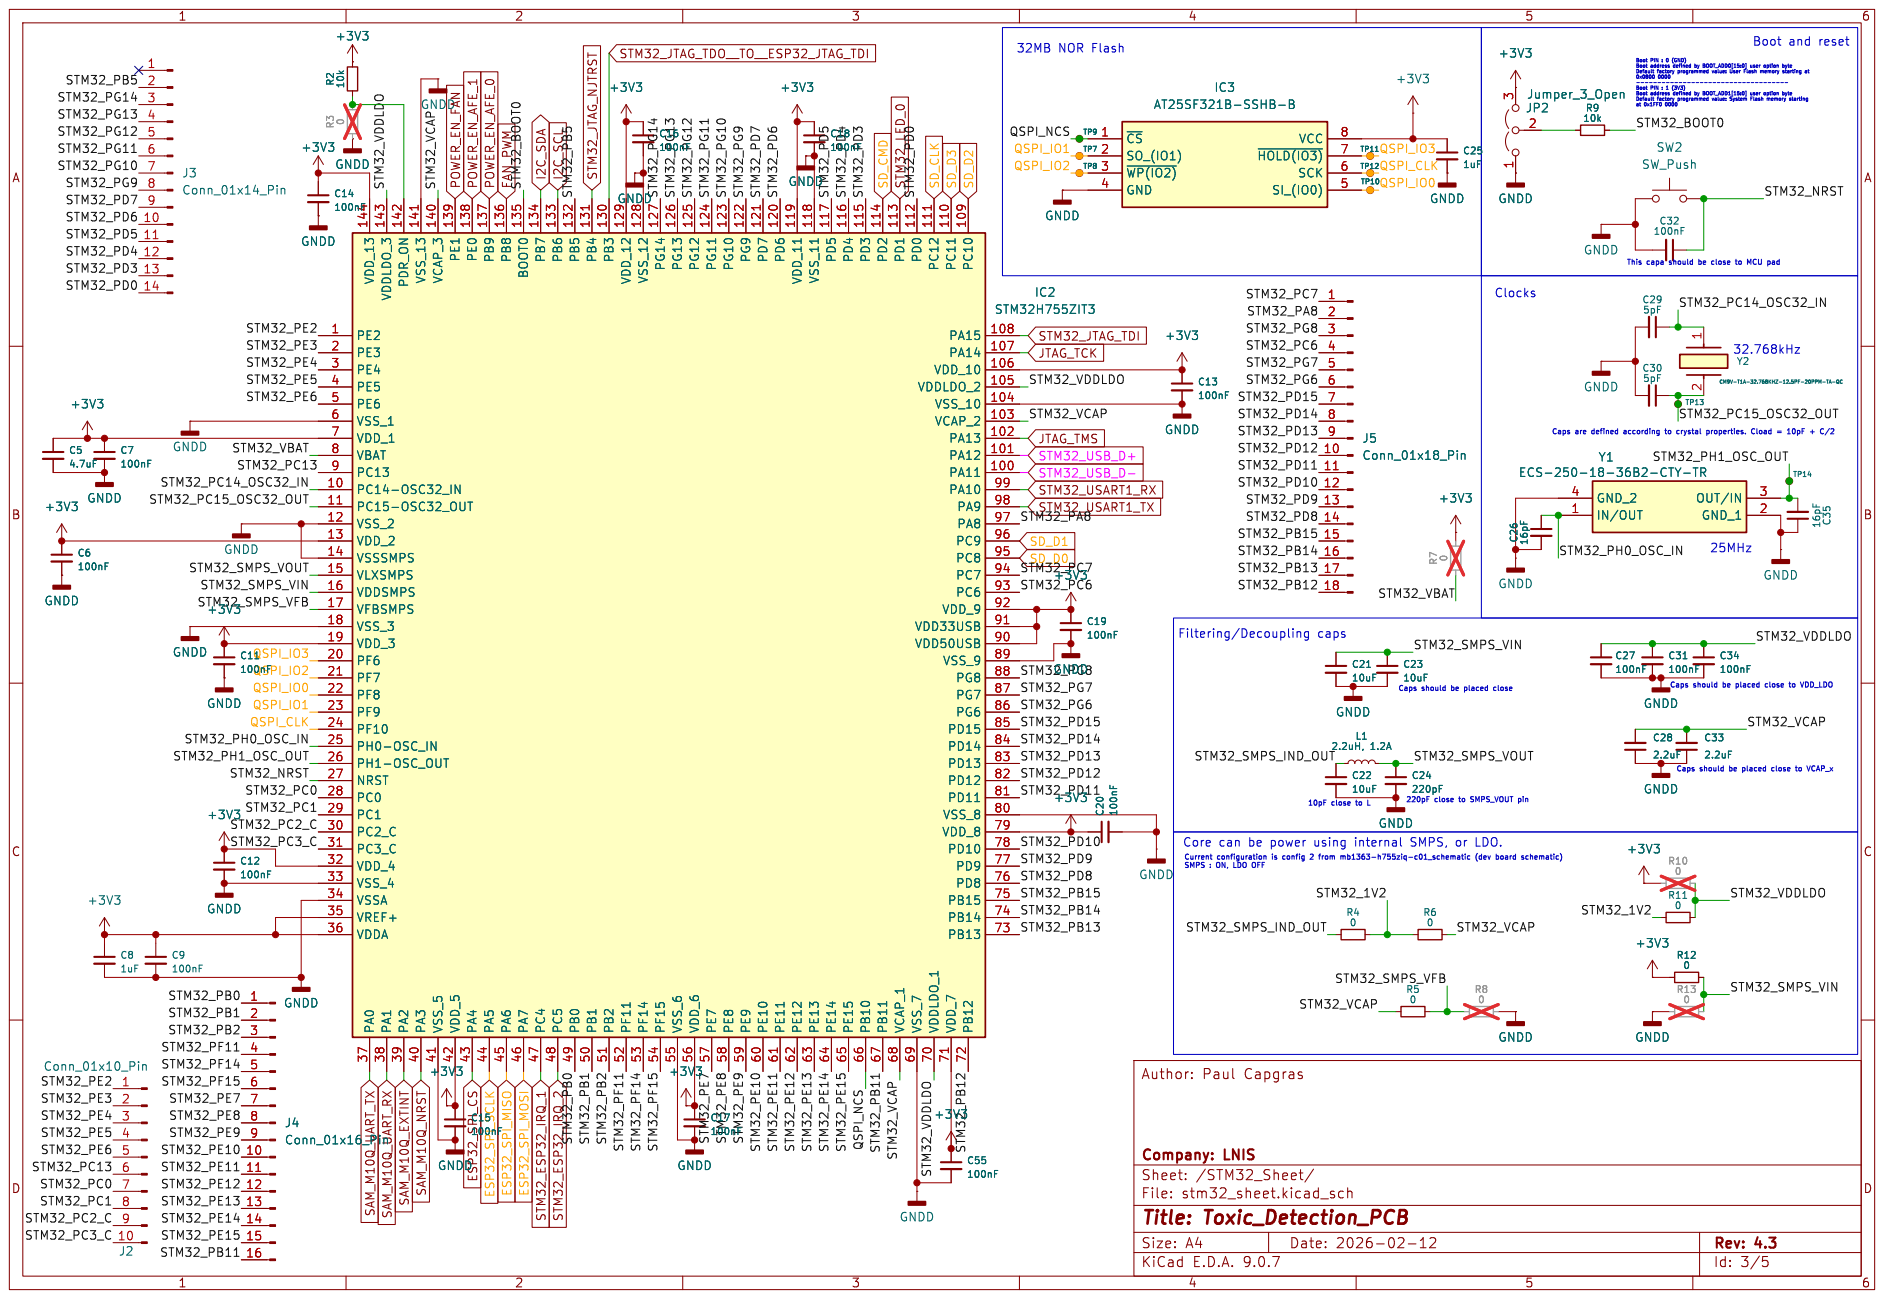
[picture p116: page 3]

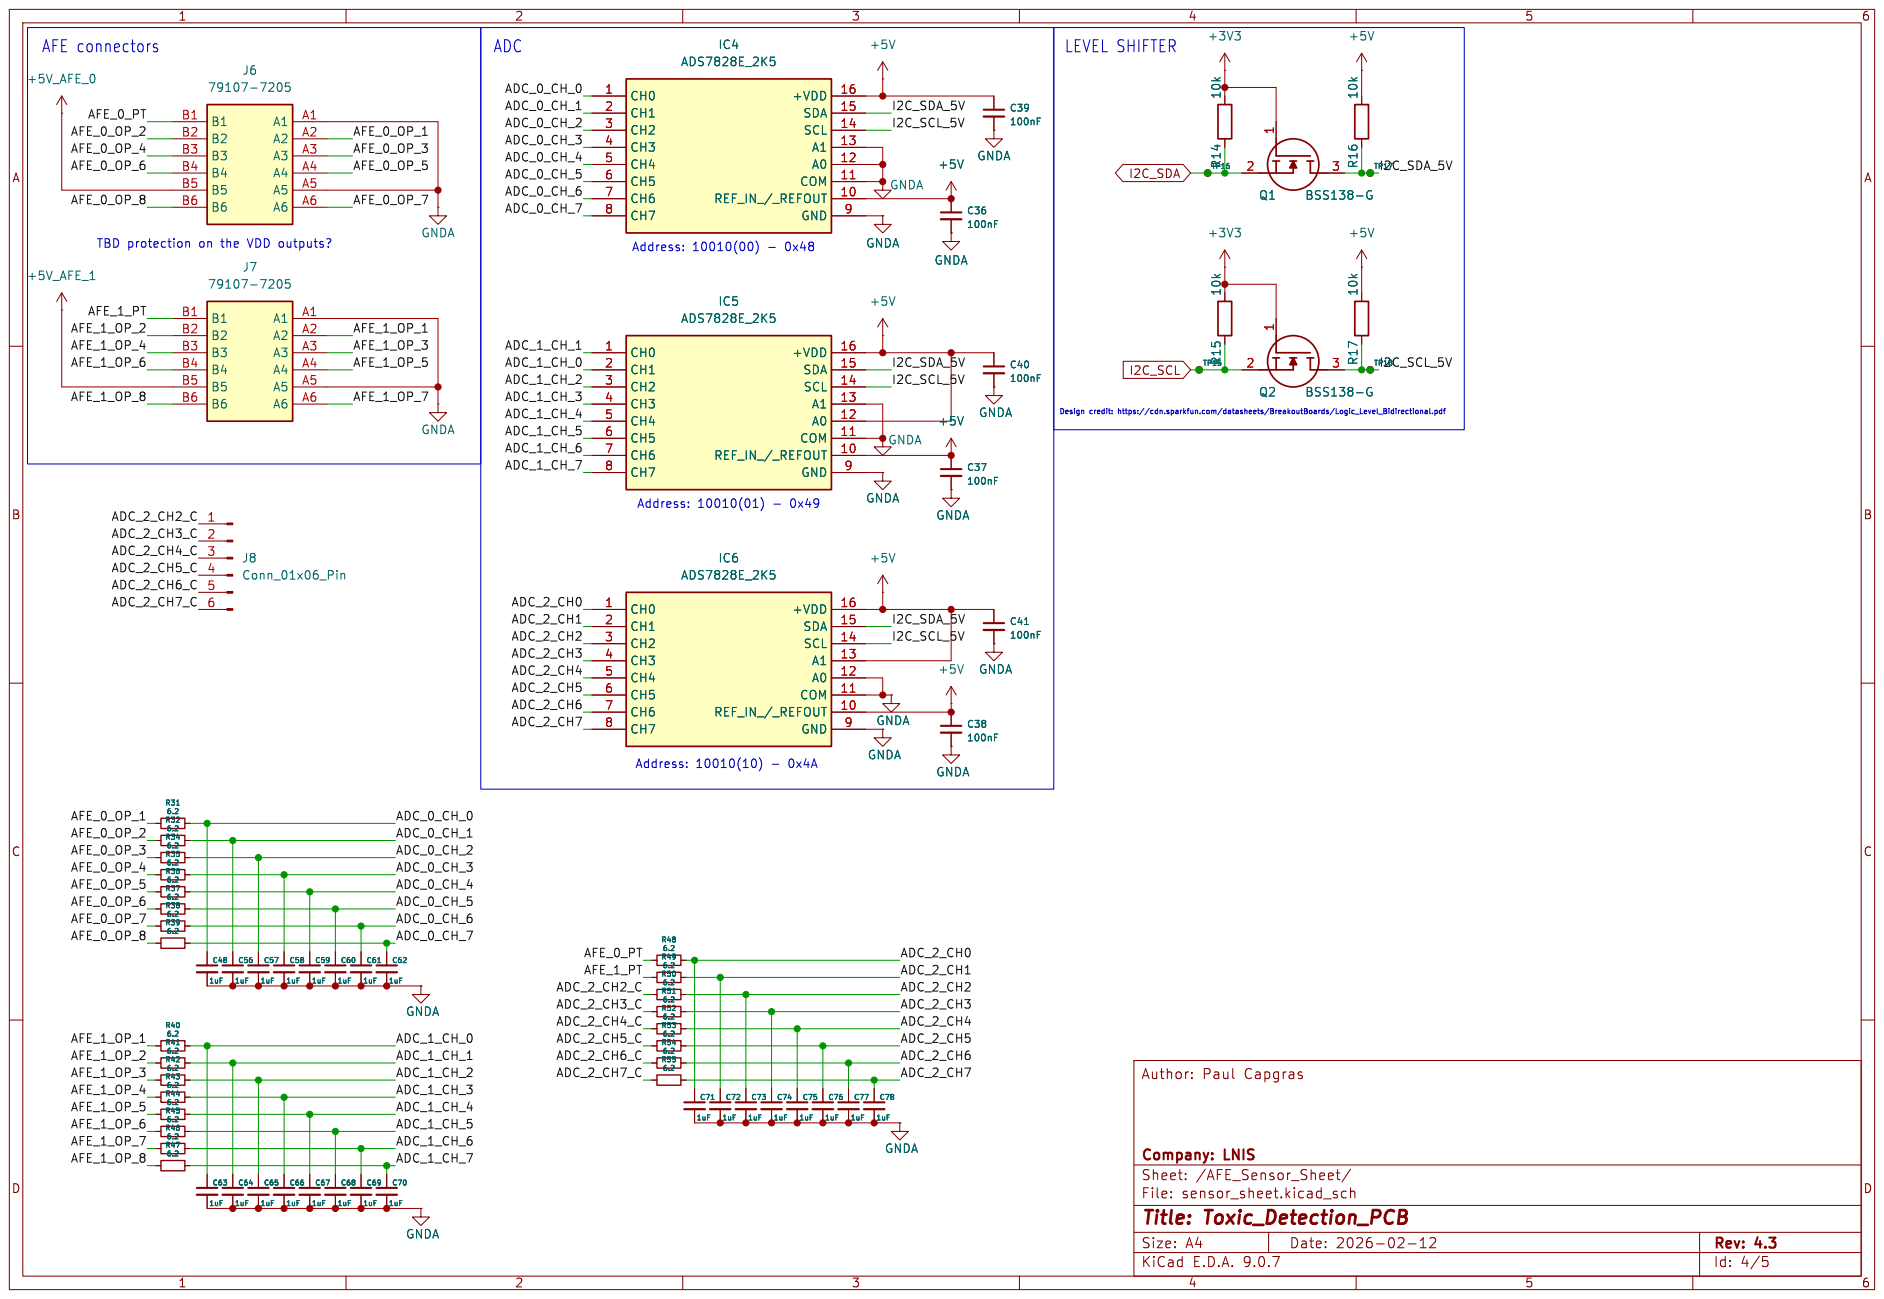
[picture p117: page 4]

100nF GNDA GNDA GNDA GNDA

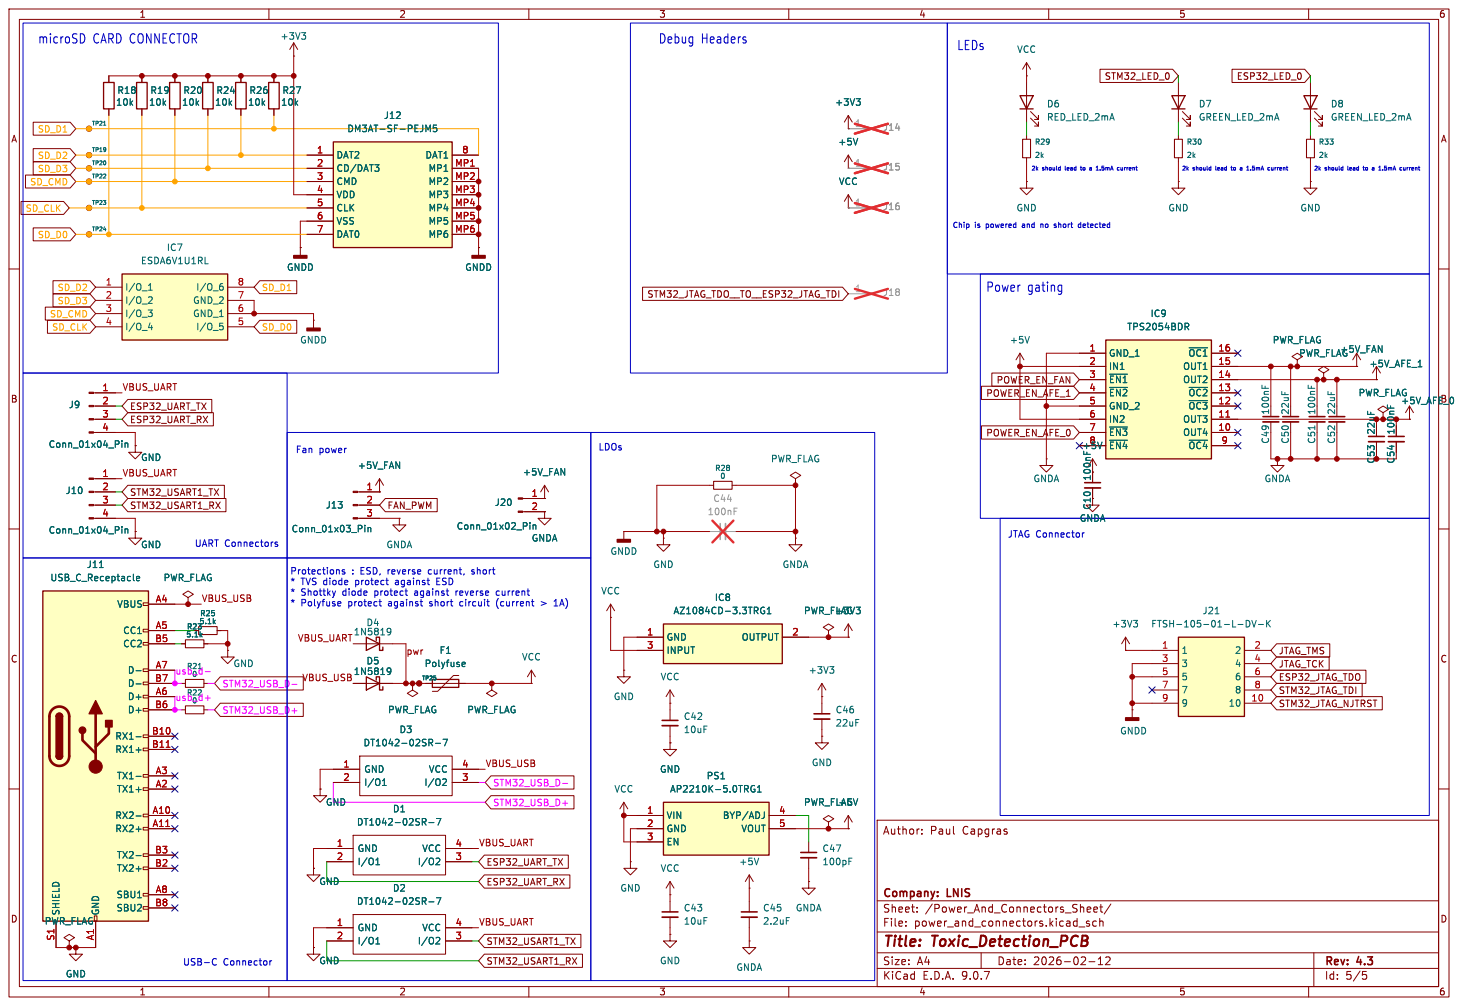
[picture p118: page 5]

JTAG Connector UART Connectors microSD CARD CONNECTOR
