capopaul/Toxic-Detection-PCB/doc/components/SD card holder/DM3AT_SF_PEJM5_CL0609_0031_0_00_2DDrawing_0000947170.pdf

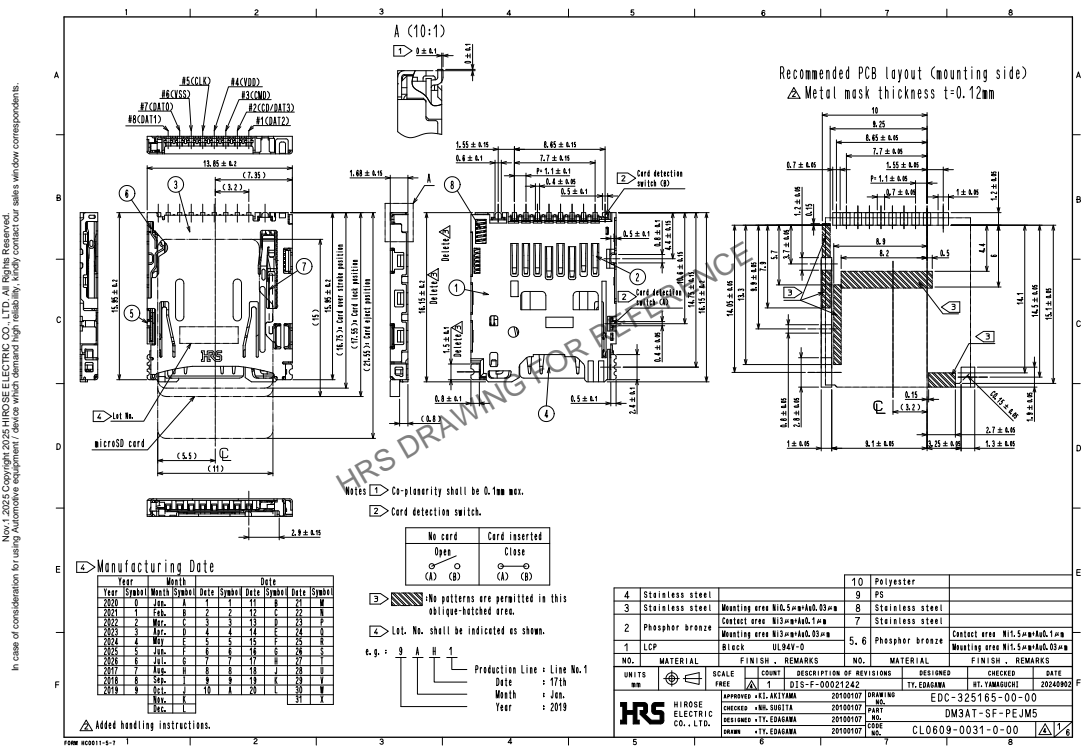
[picture p119: page 1]

HRS DRAWING FOR REFERENCE

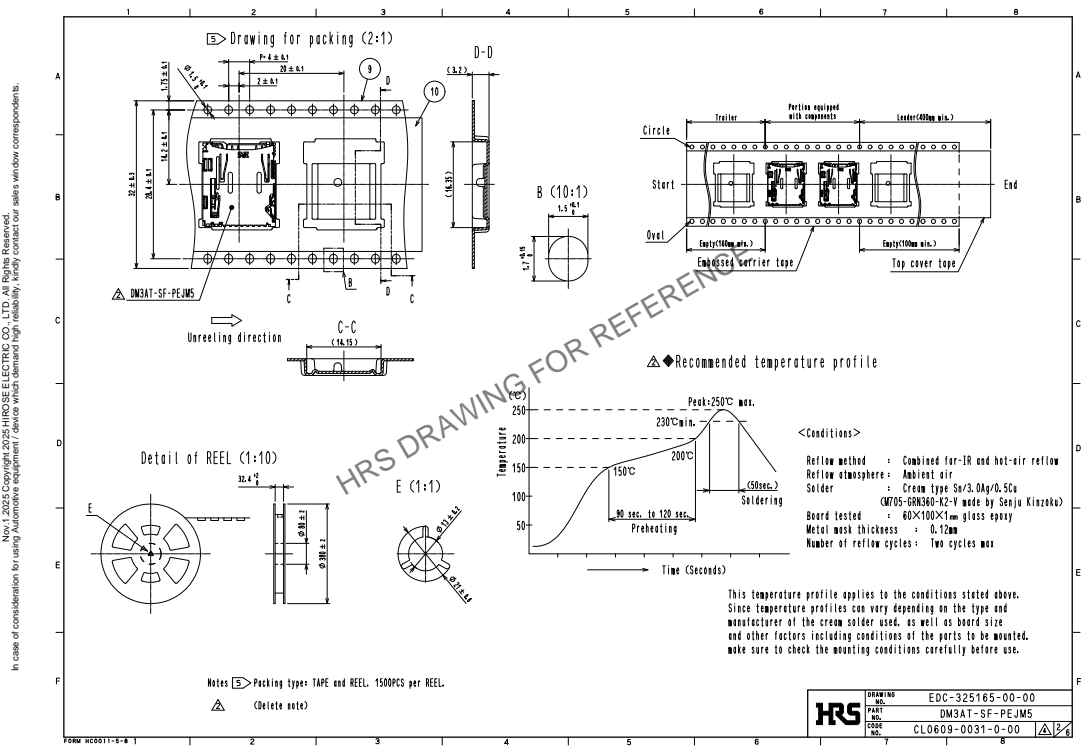
[picture p120: page 2]

HRS DRAWING FOR REFERENCE

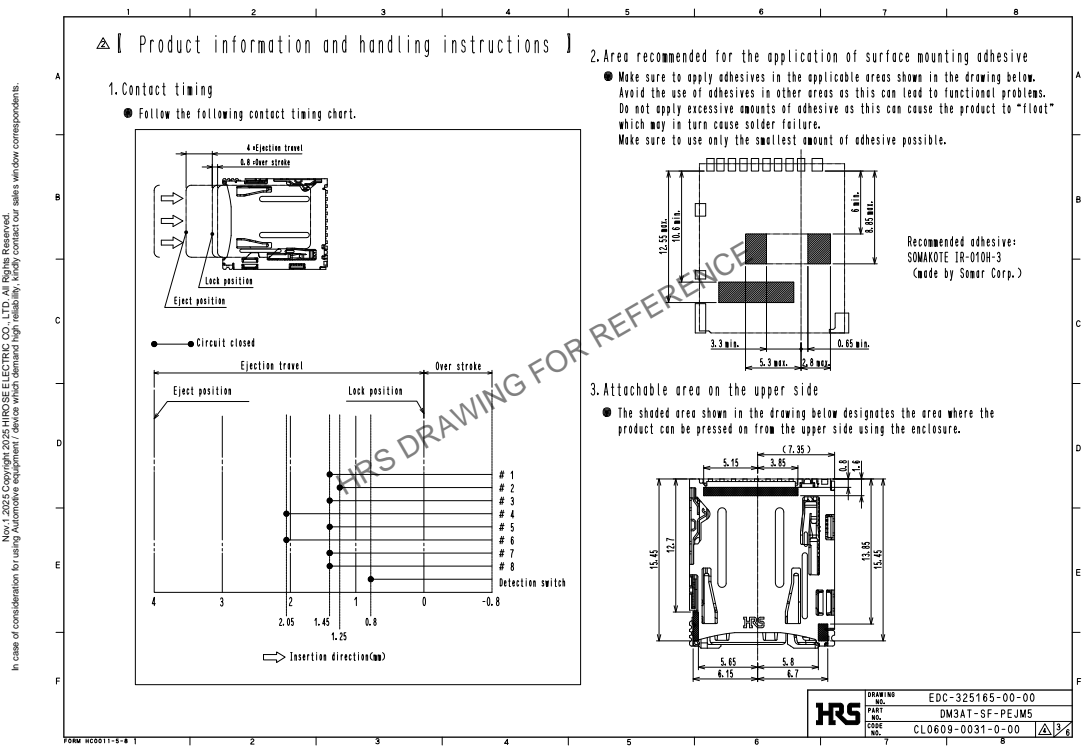
[picture p121: page 3]

HRS DRAWING FOR REFERENCE

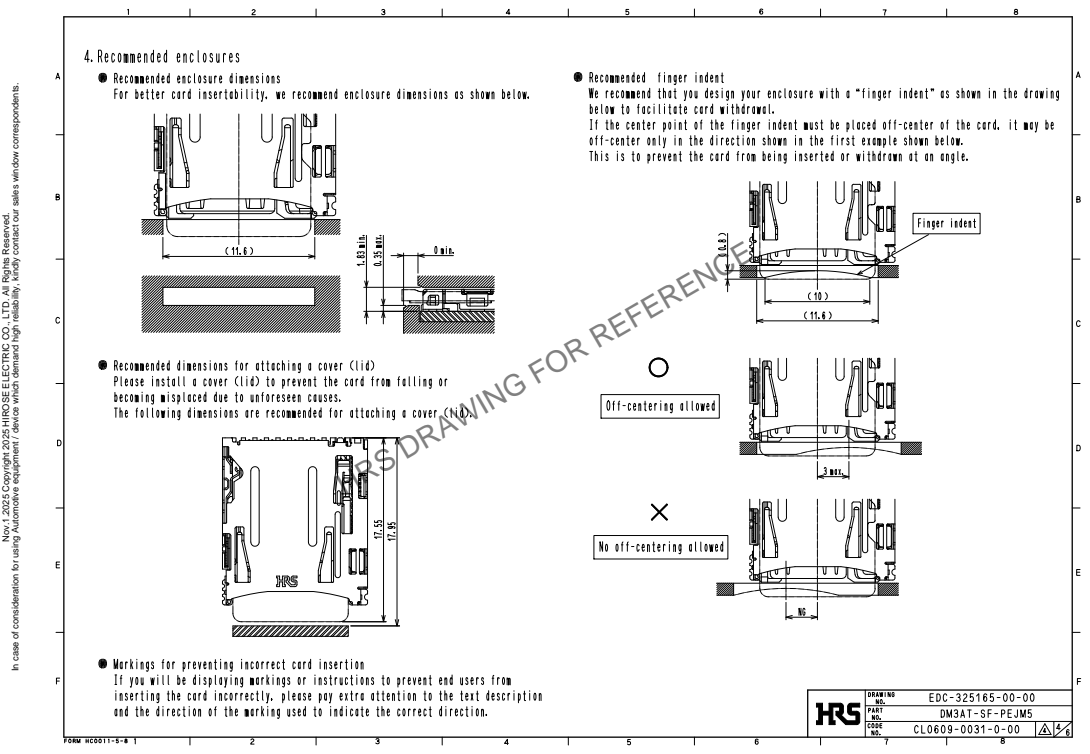
[picture p122: page 4]

HRS DRAWING FOR REFERENCE

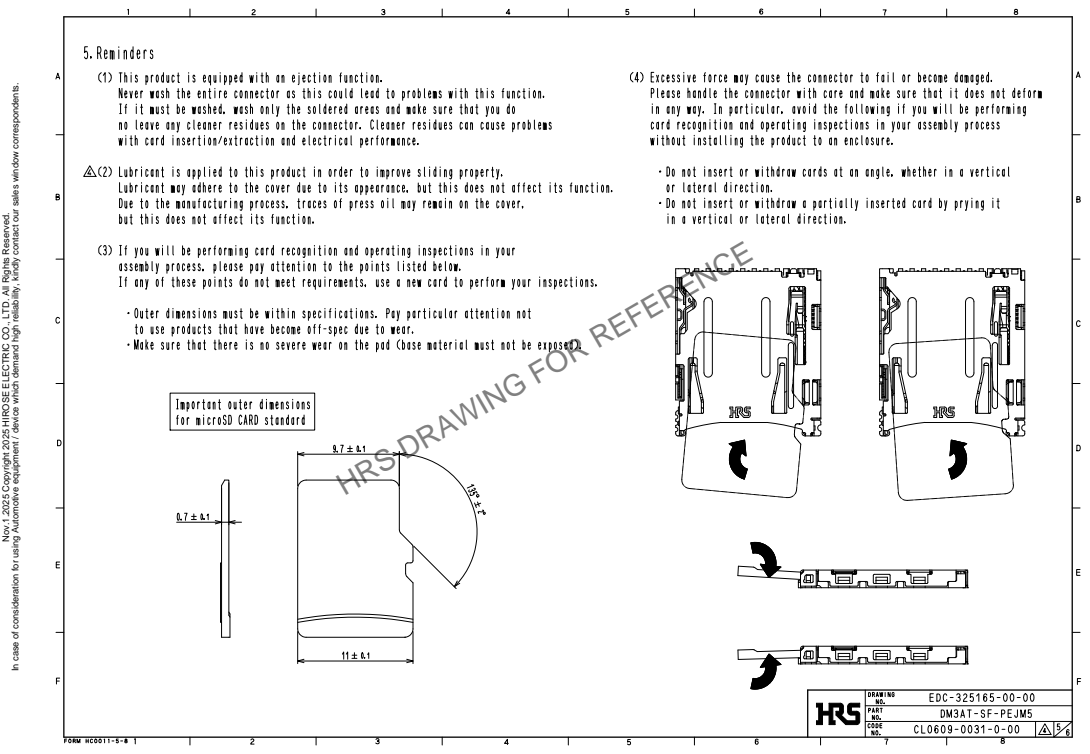
[picture p123: page 5]

HRS DRAWING FOR REFERENCE

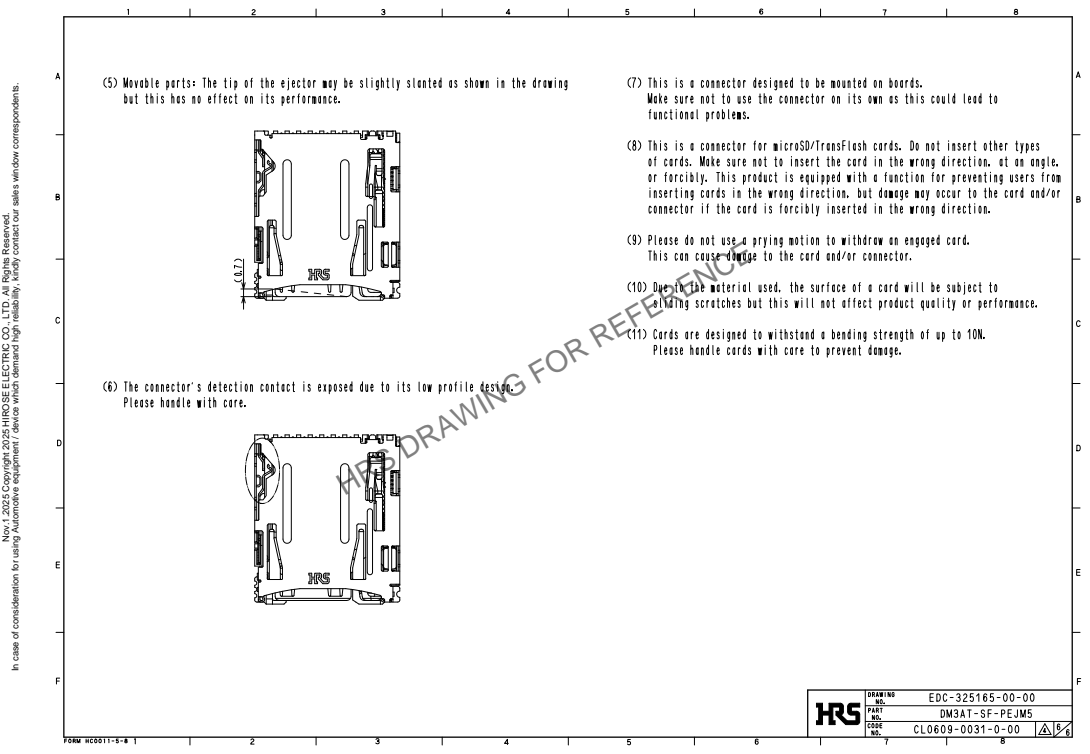
[picture p124: page 6]

HRS DRAWING FOR REFERENCE
