capopaul/Toxic-Detection-PCB/doc/layout_v4.2.pdf

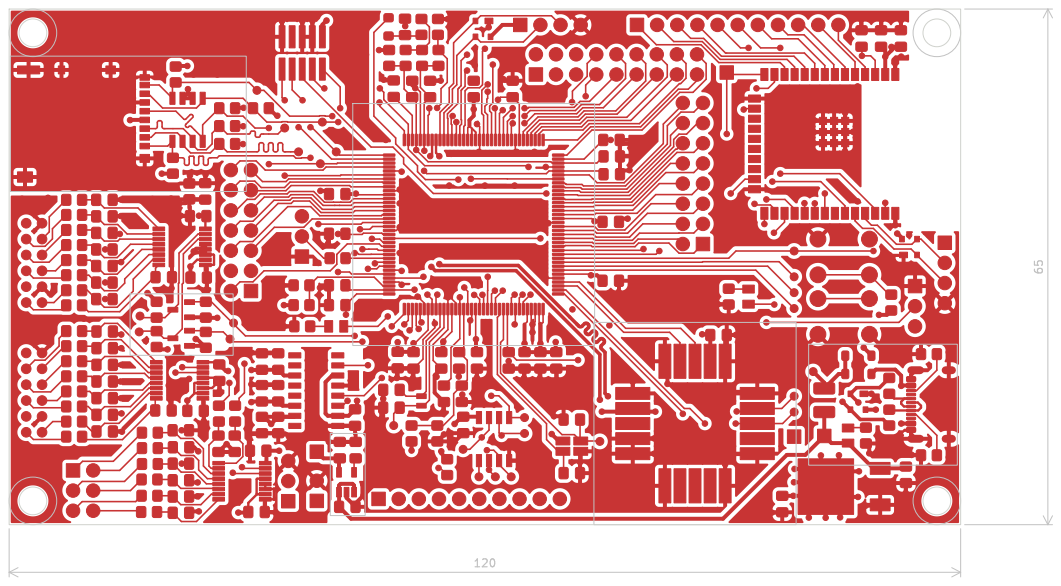
[picture p125: page 1]

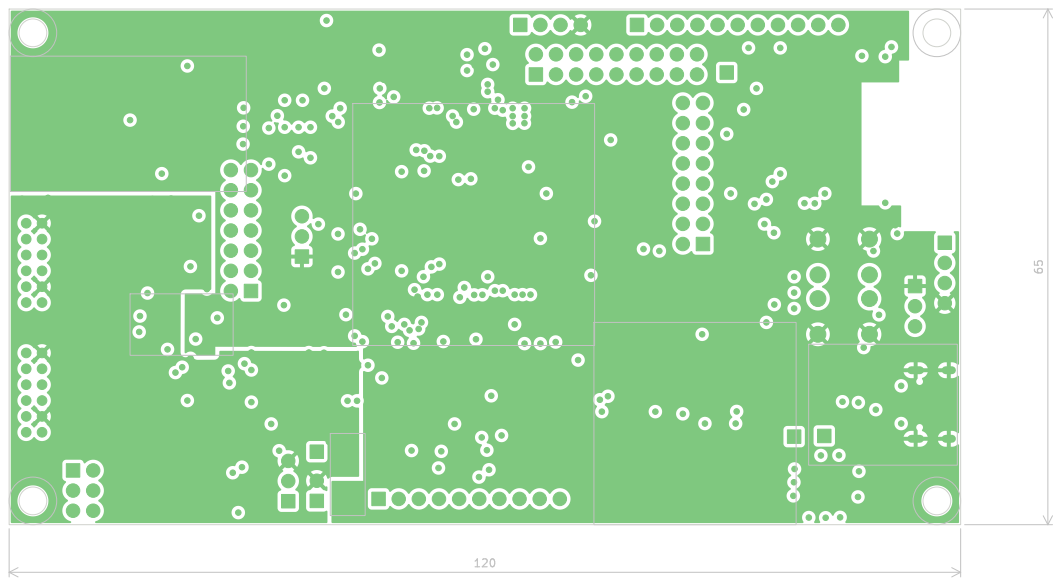
[picture p126: page 2]

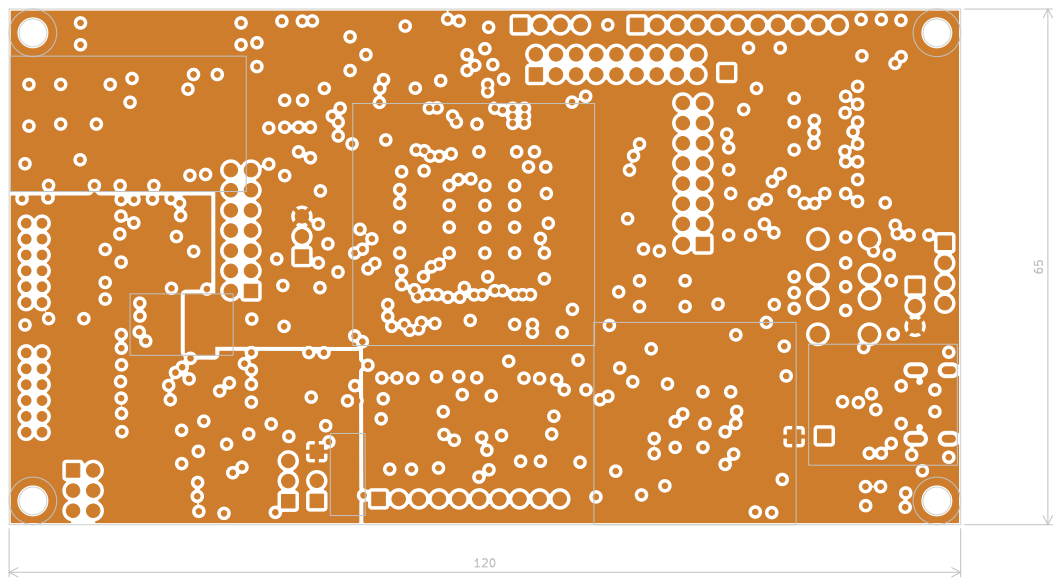
[picture p127: page 3]

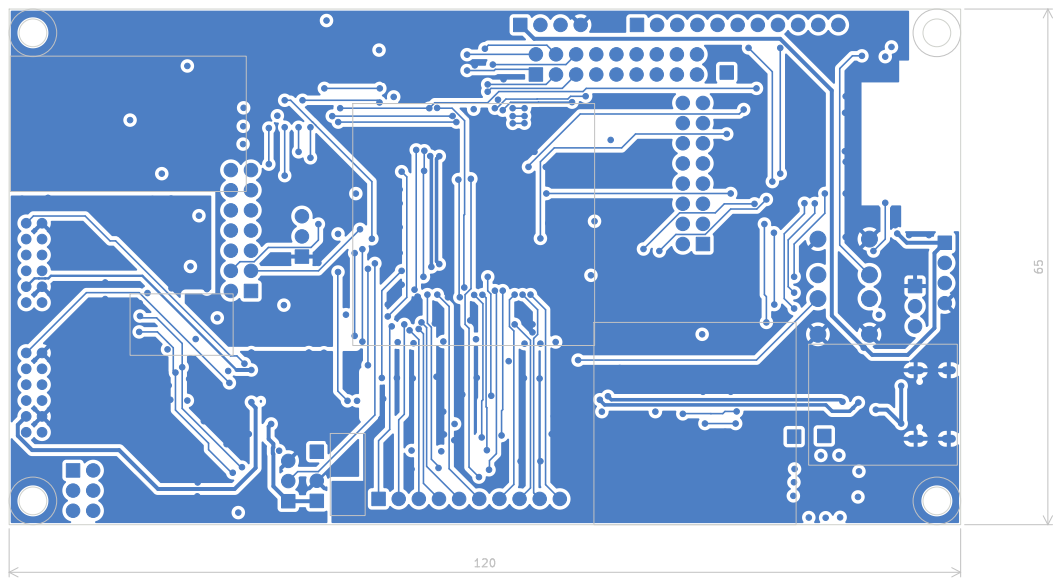
[picture p128: page 4]

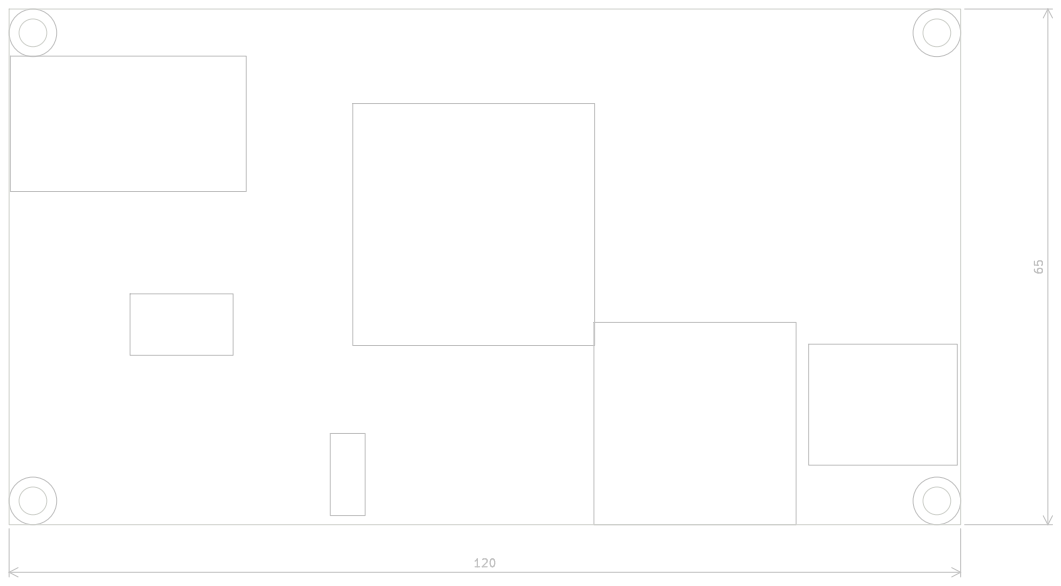
[picture p129: page 5]

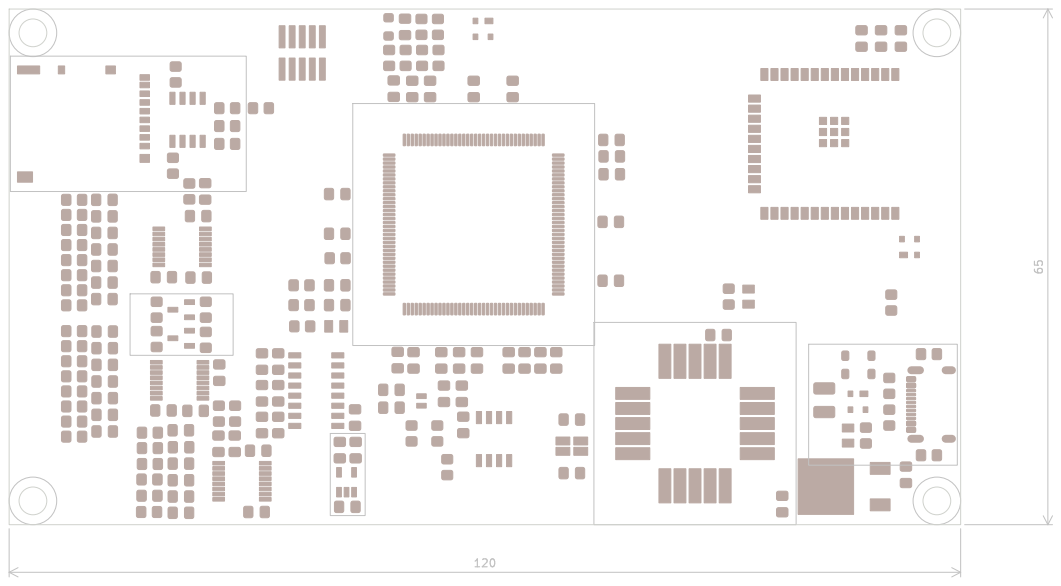
[picture p130: page 7]

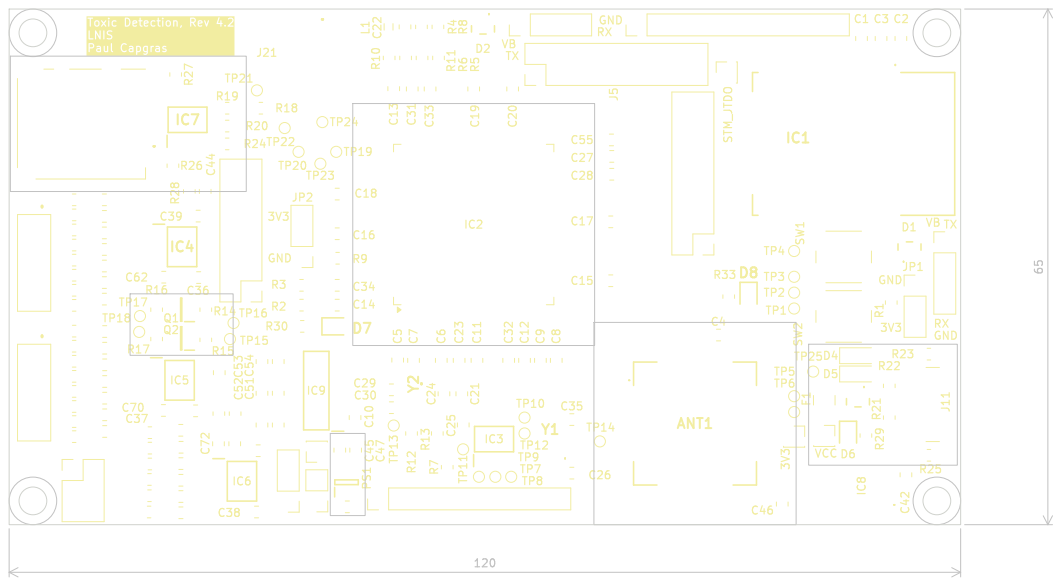
[picture p131: page 9]

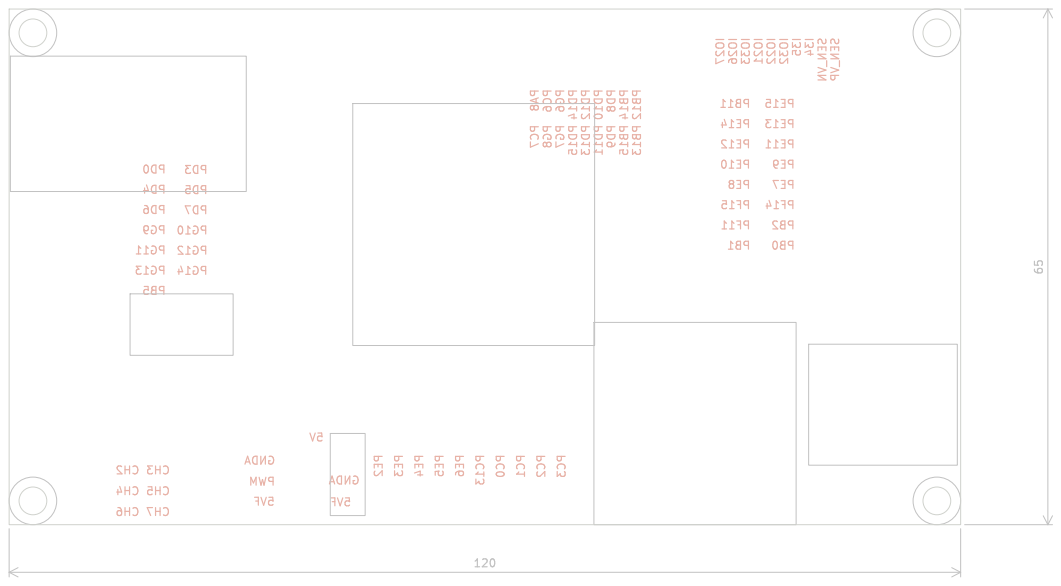
[picture p132: page 10]

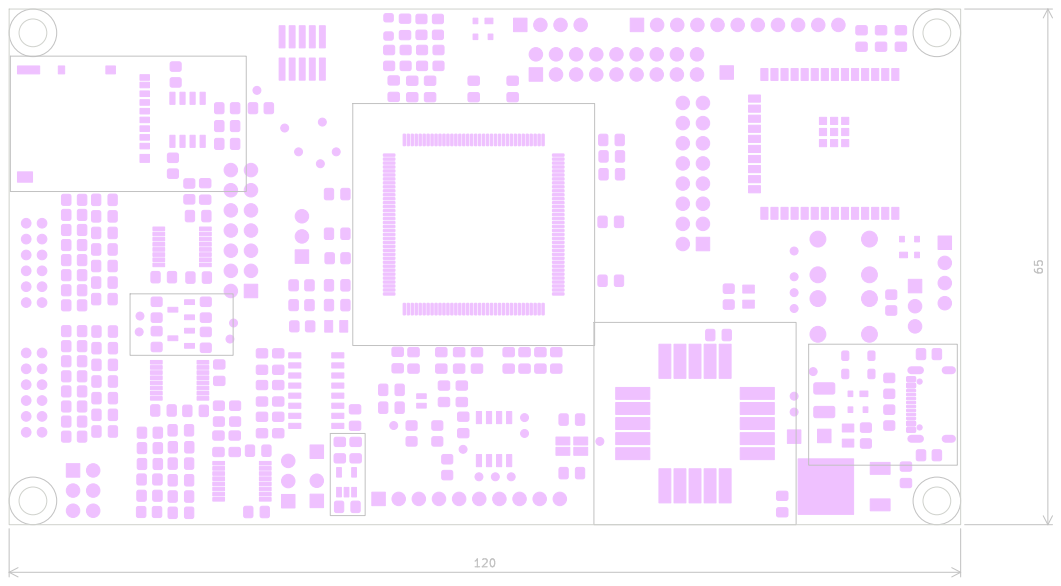
[picture p133: page 11]

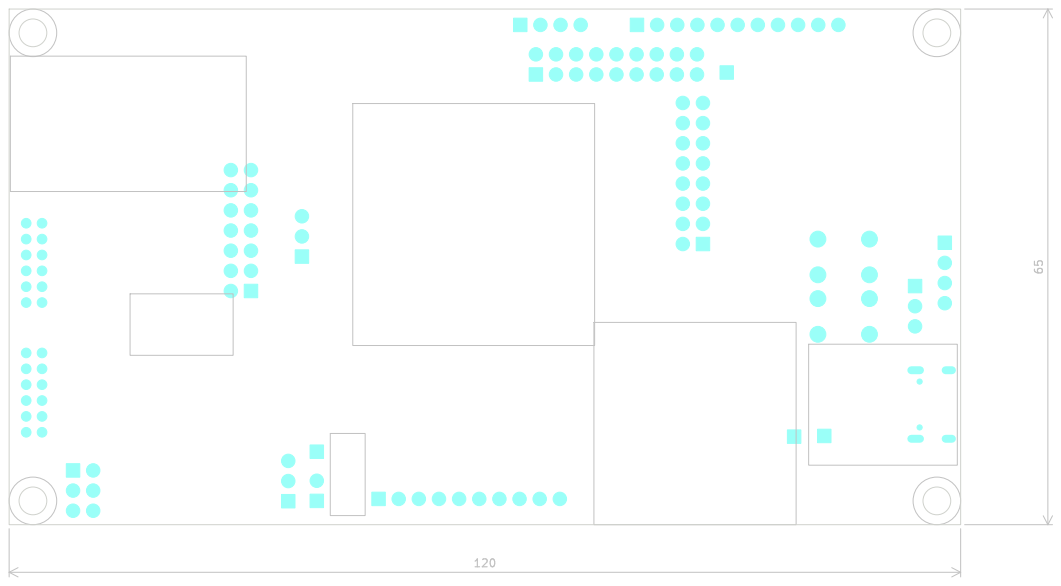
[picture p134: page 12]

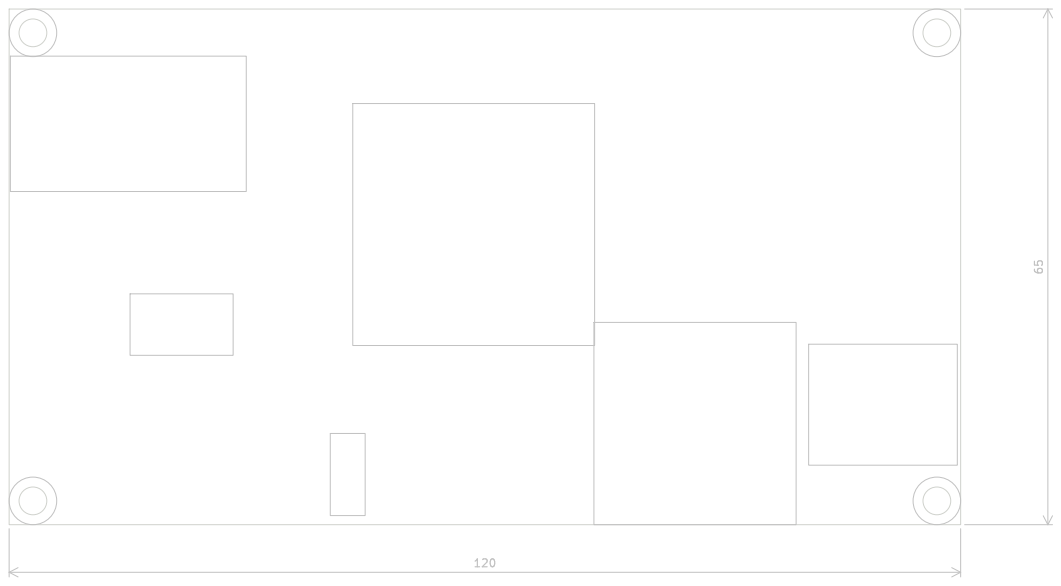
[picture p135: page 13]
