capopaul/Toxic-Detection-PCB/doc/schematic_v4.2.pdf

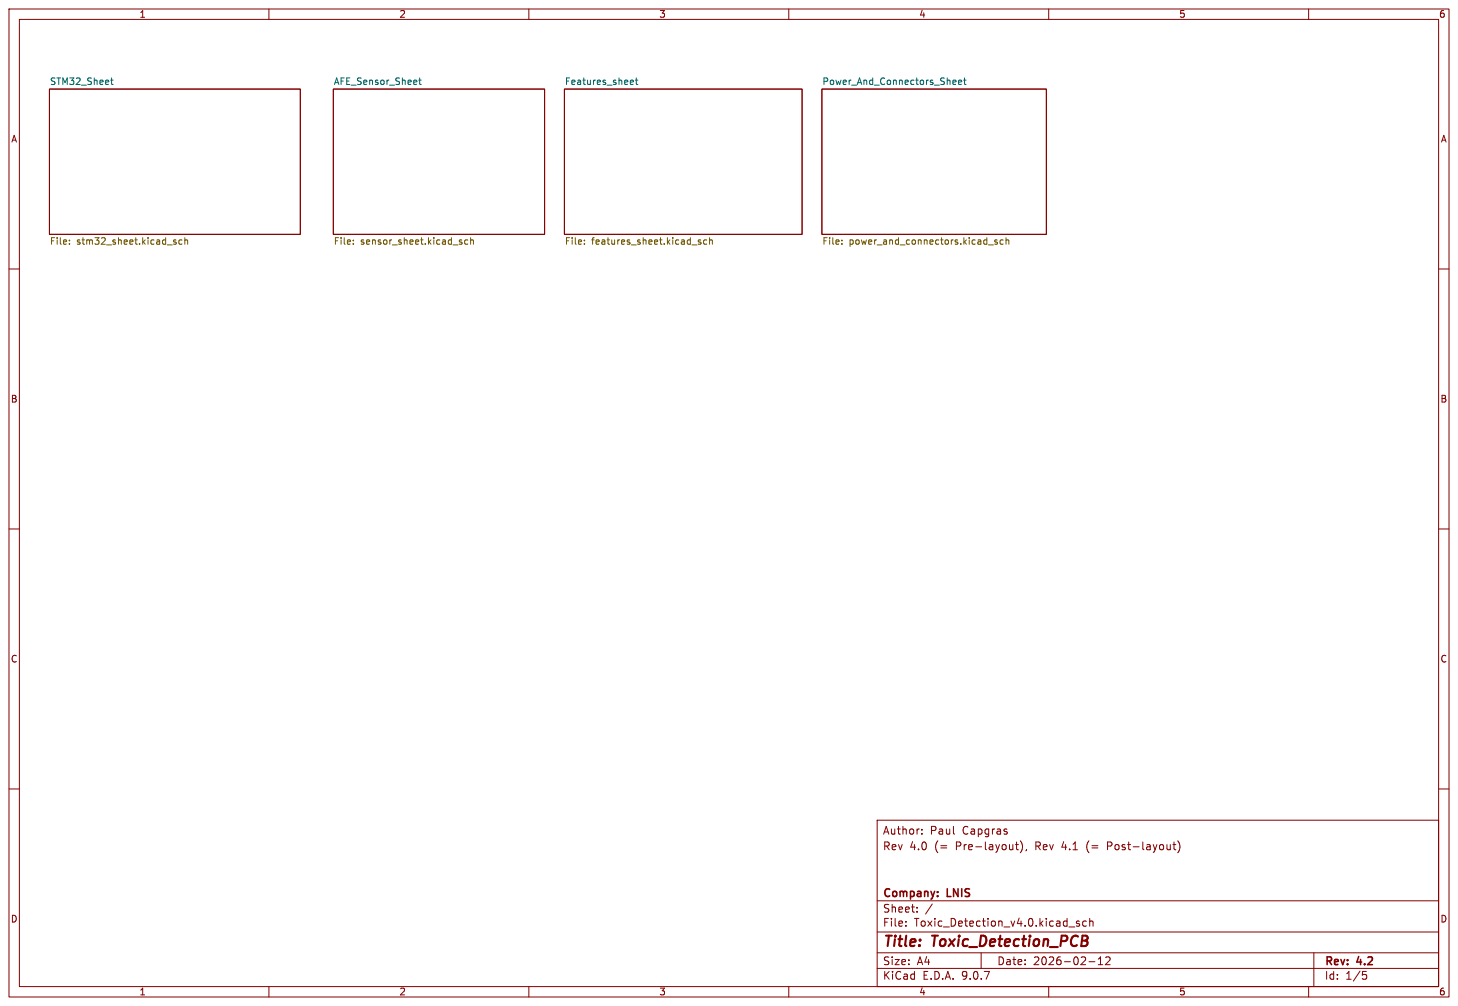
[picture p136: page 1]

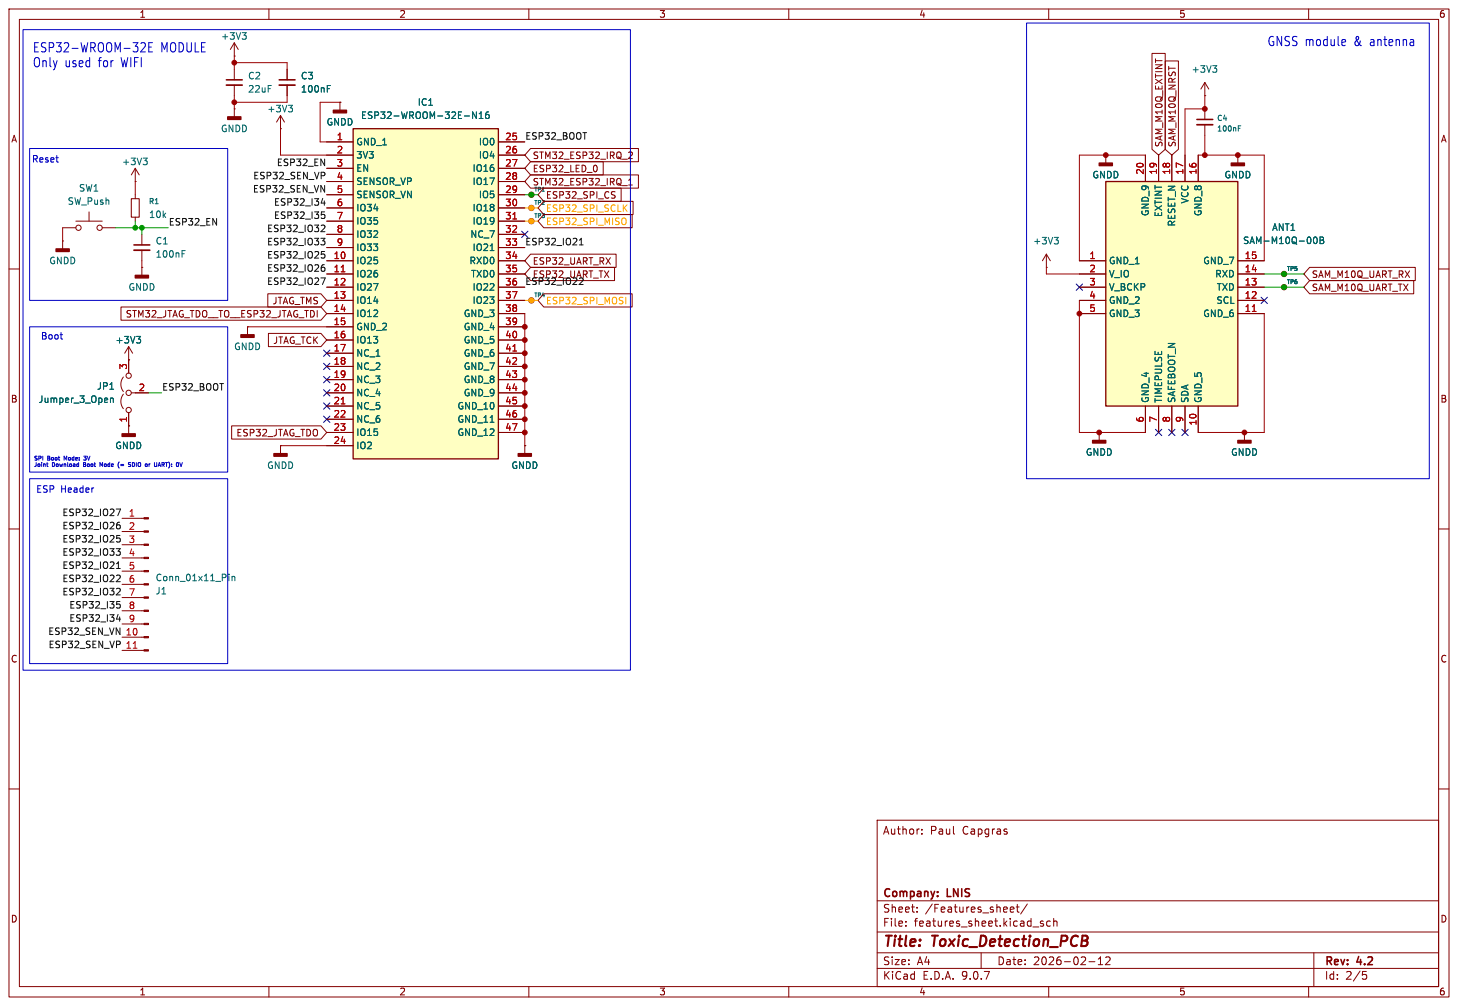
[picture p137: page 2]

Only used for WIFI Reset Boot SPI Boot Mode: 3V
22uF GNDD

9 GND_8 16 GND_5 10 GND_7 15 RXD 14 TXD 13 SCL 12 GND_6 11 ANT1 SAM-M10Q-00B GNDD GNDD

9 GND_8 16 GND_5 10 GND_7 15 RXD 14 TXD 13 SCL 12 GND_6 11 GNDD GNDD

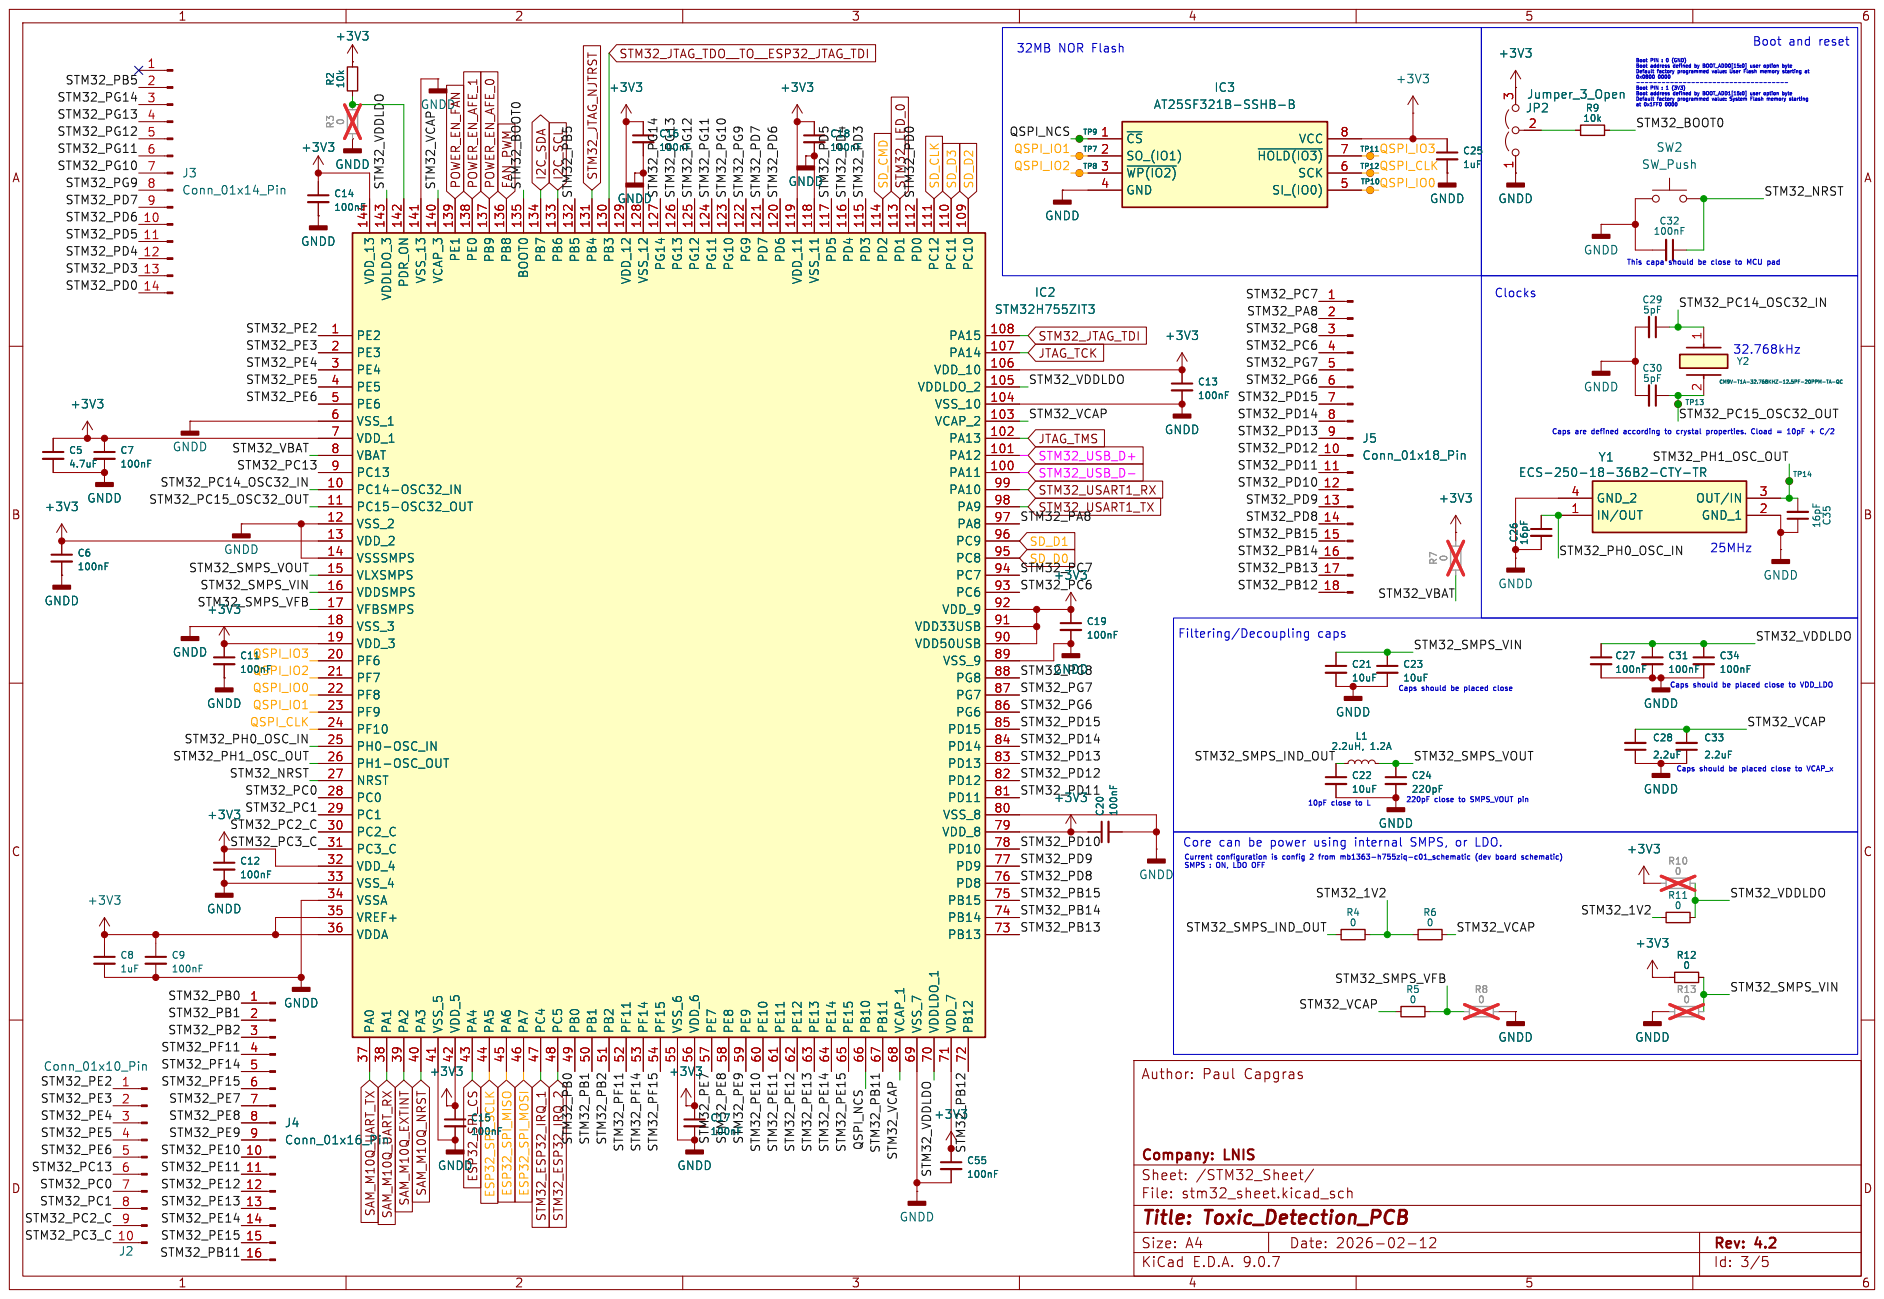
[picture p138: page 3]

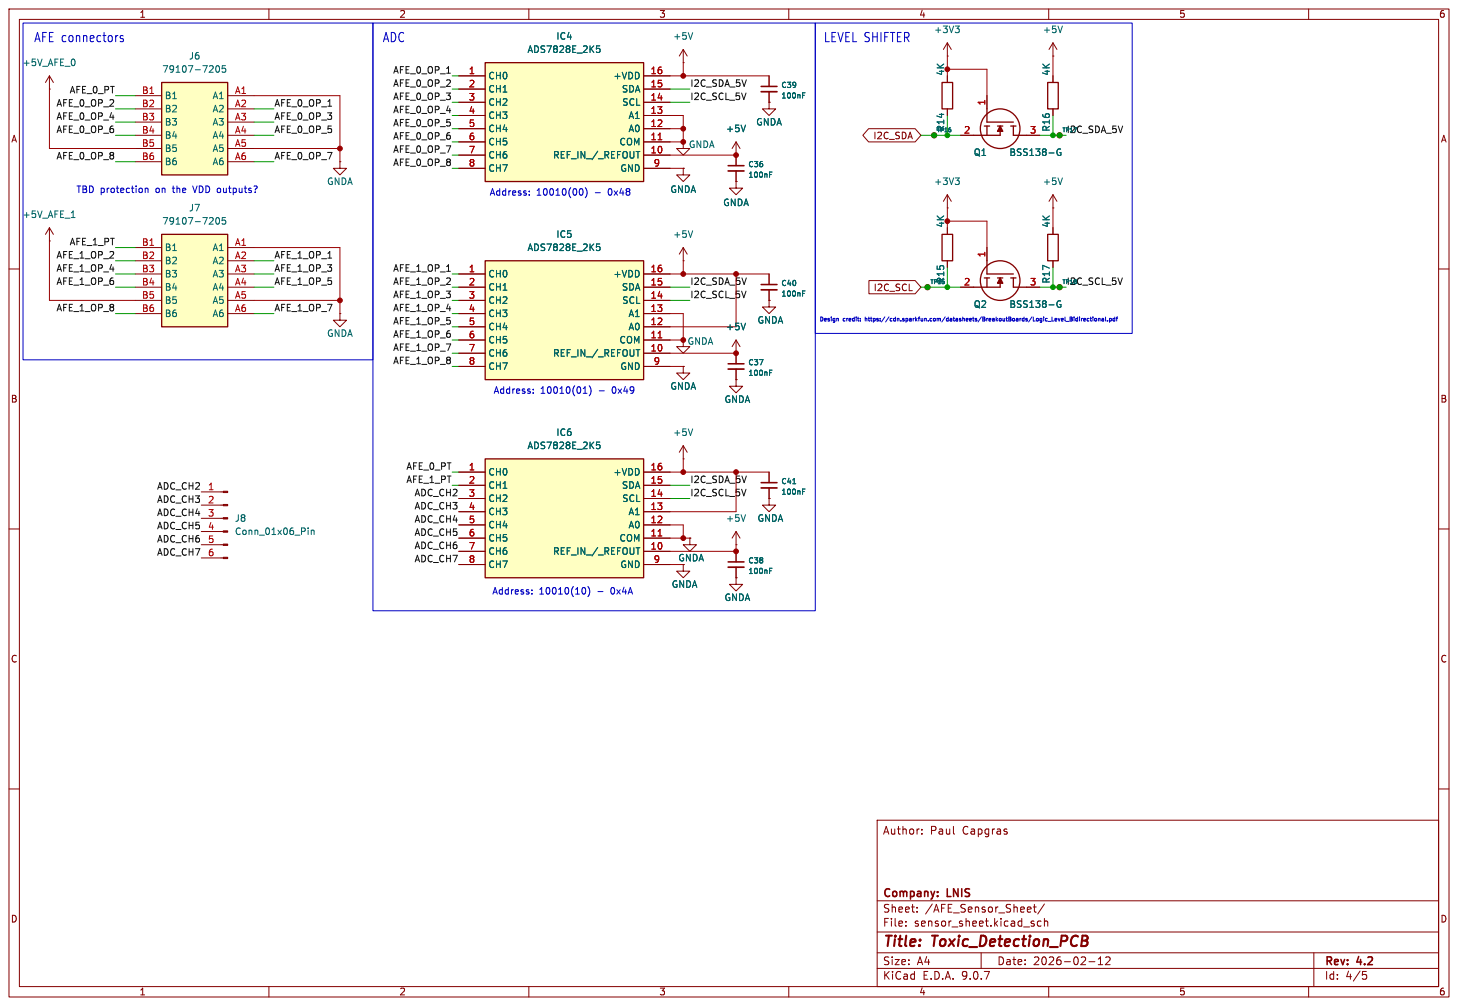
[picture p139: page 4]

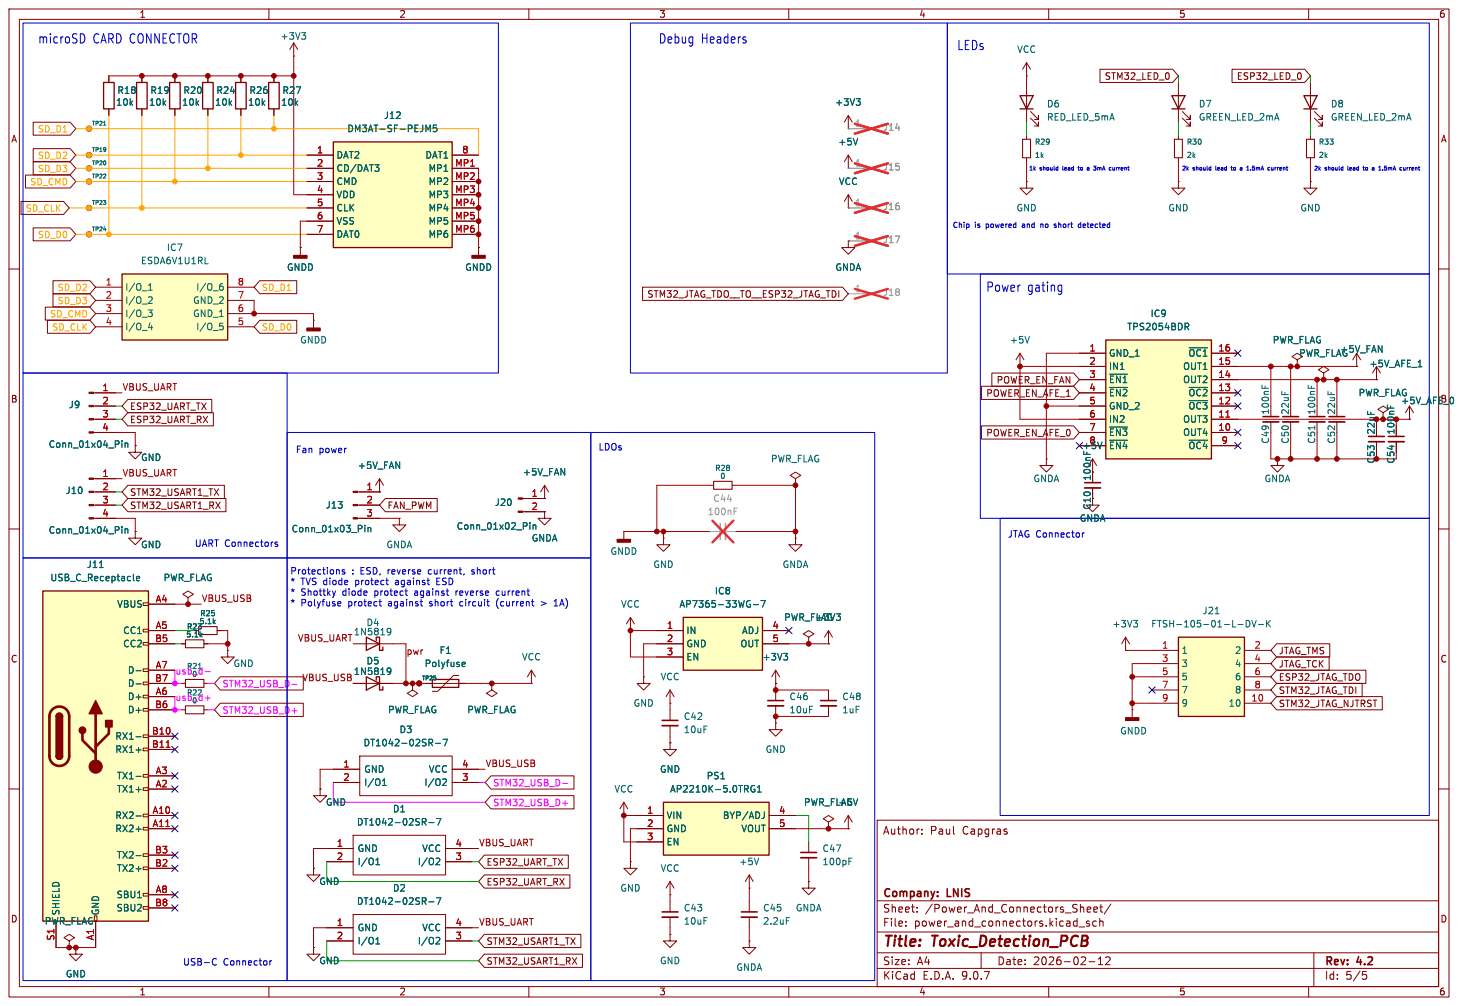
[picture p140: page 5]
