capopaul/Toxic-Detection-PCB/doc/schematic_v4.1.pdf

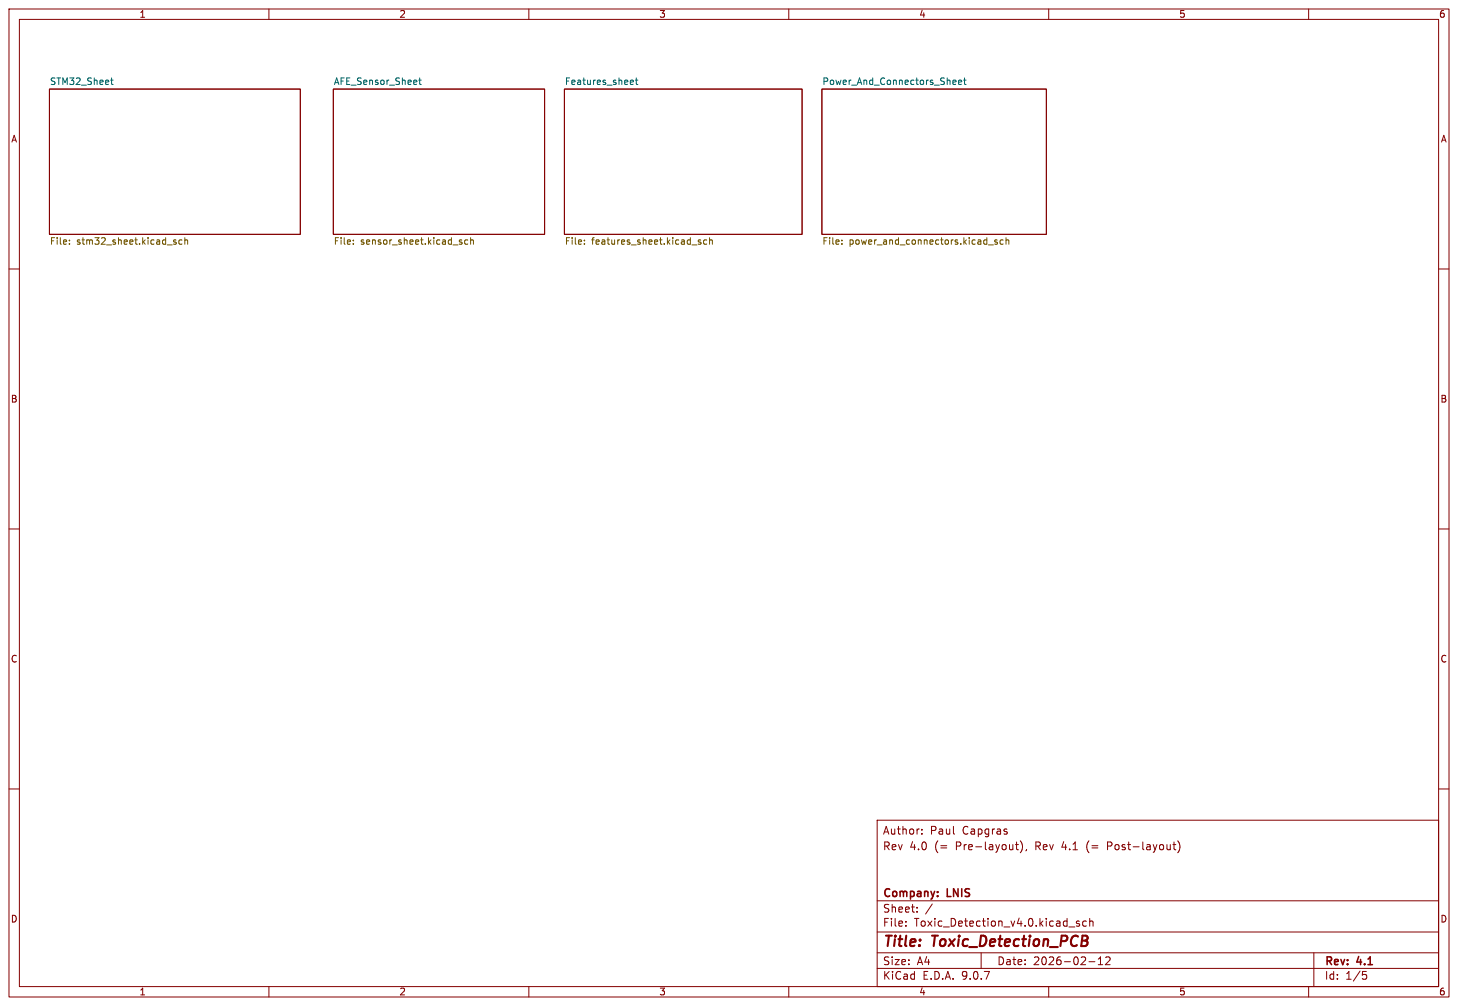
[picture p141: page 1]

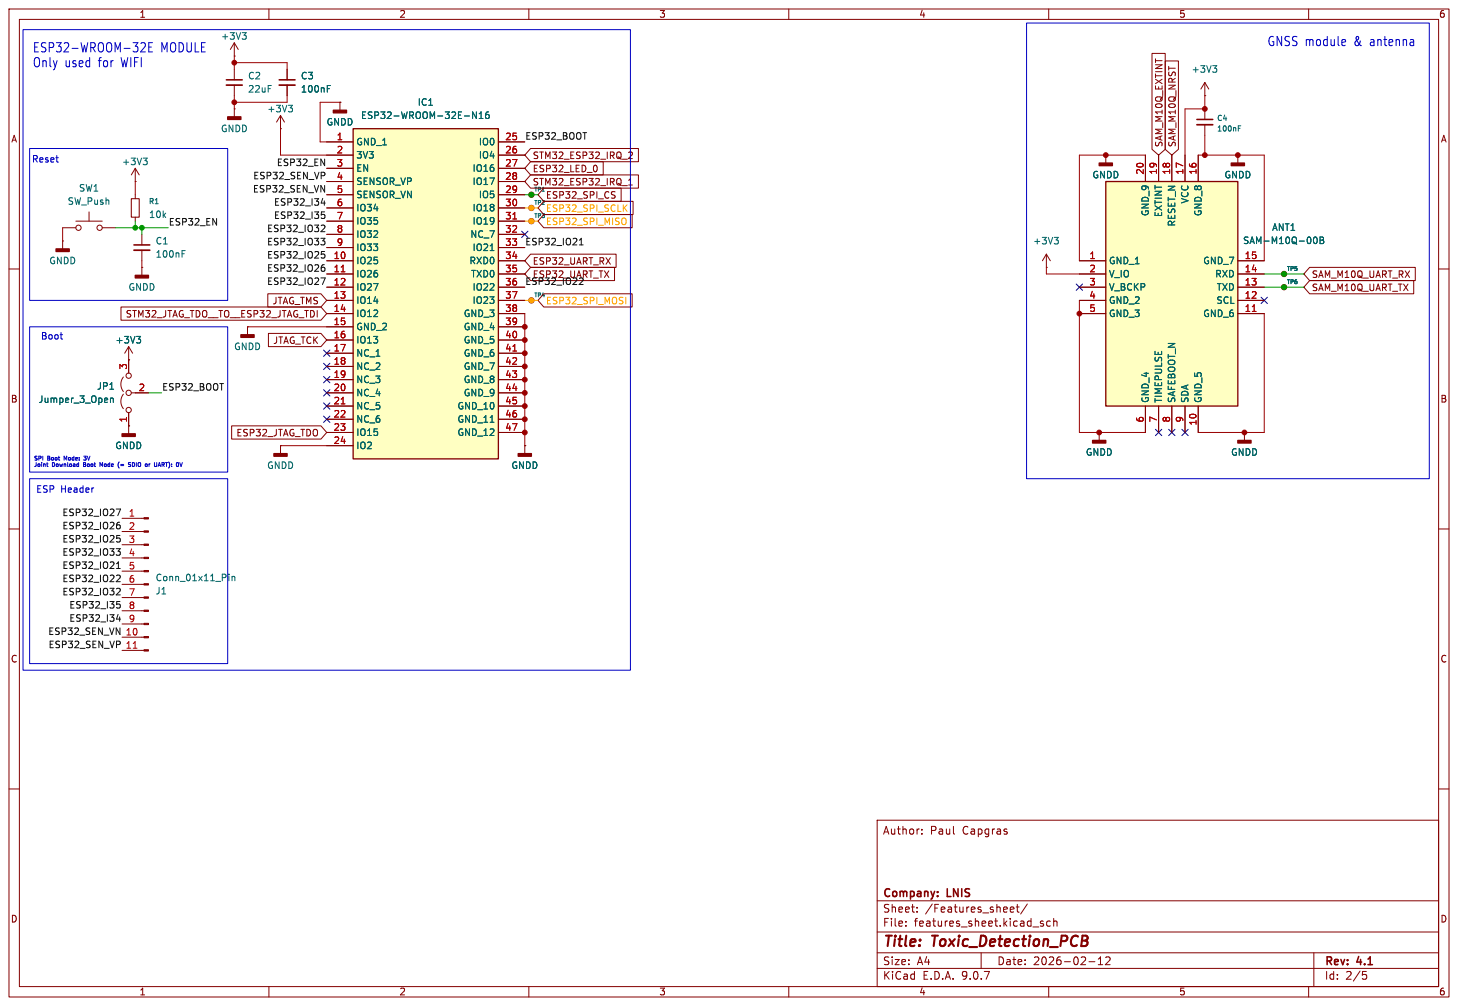
[picture p142: page 2]

Only used for WIFI Reset Boot SPI Boot Mode: 3V

9 GND_8 16 GND_5 10 GND_7 15 RXD 14 TXD 13 SCL 12 GND_6 11 GNDD GNDD

9 GND_8 16 GND_5 10 GND_7 15 RXD 14 TXD 13 SCL 12 GND_6 11 ANT1 SAM-M10Q-00B

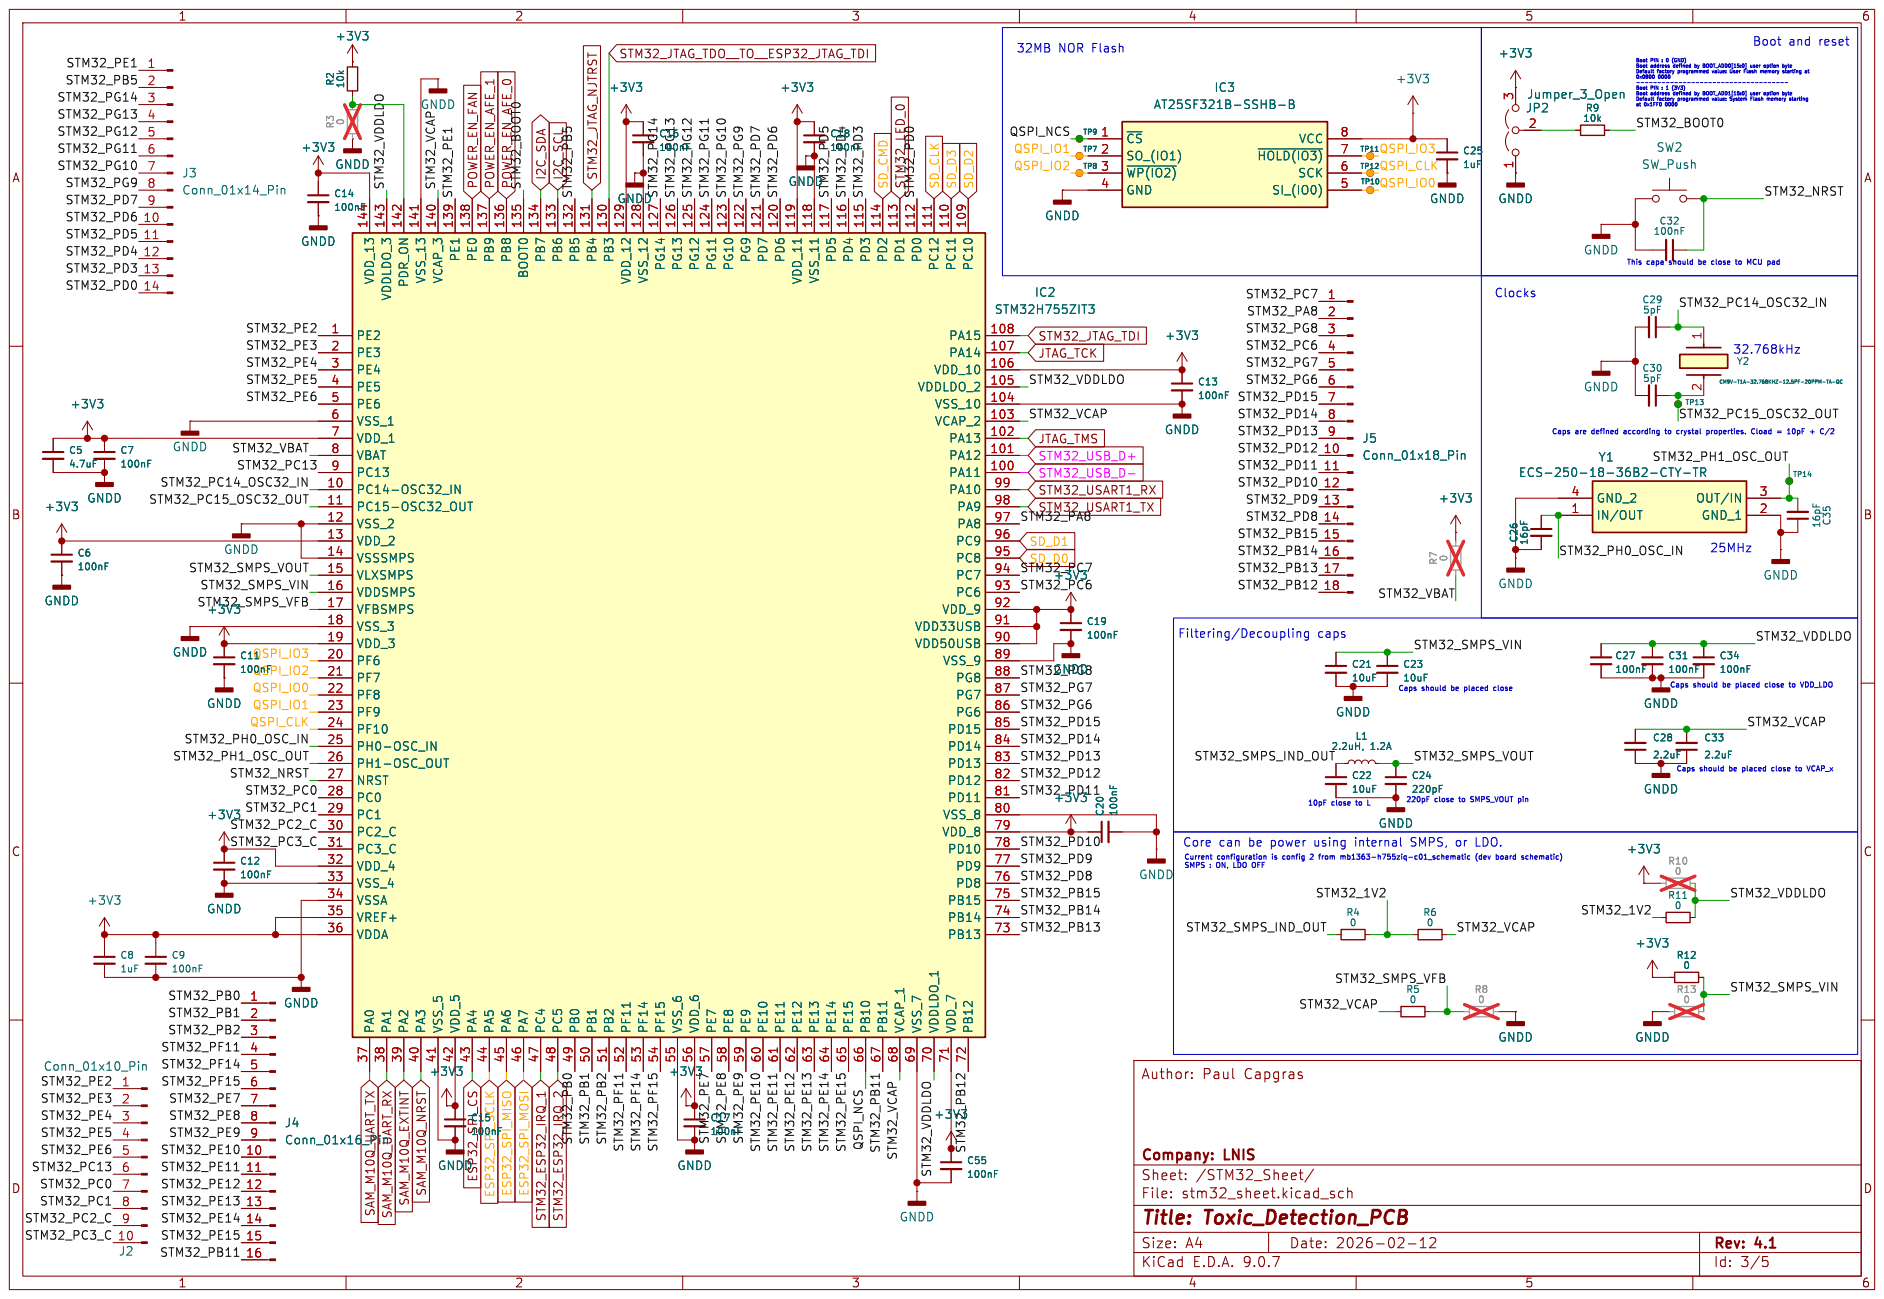
[picture p143: page 3]

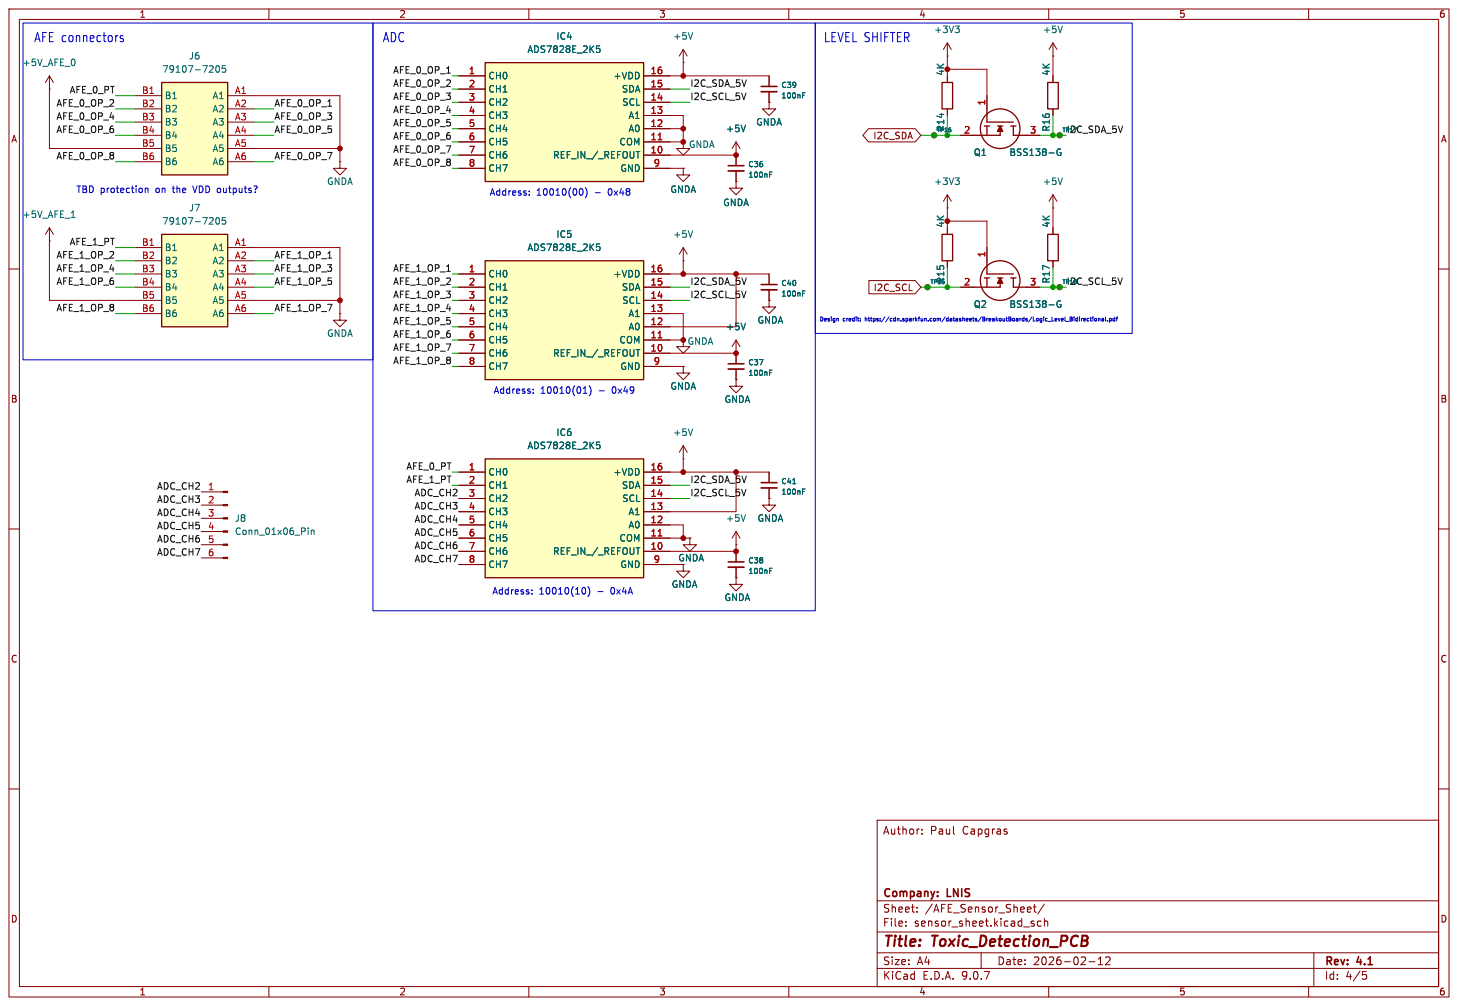
[picture p144: page 4]

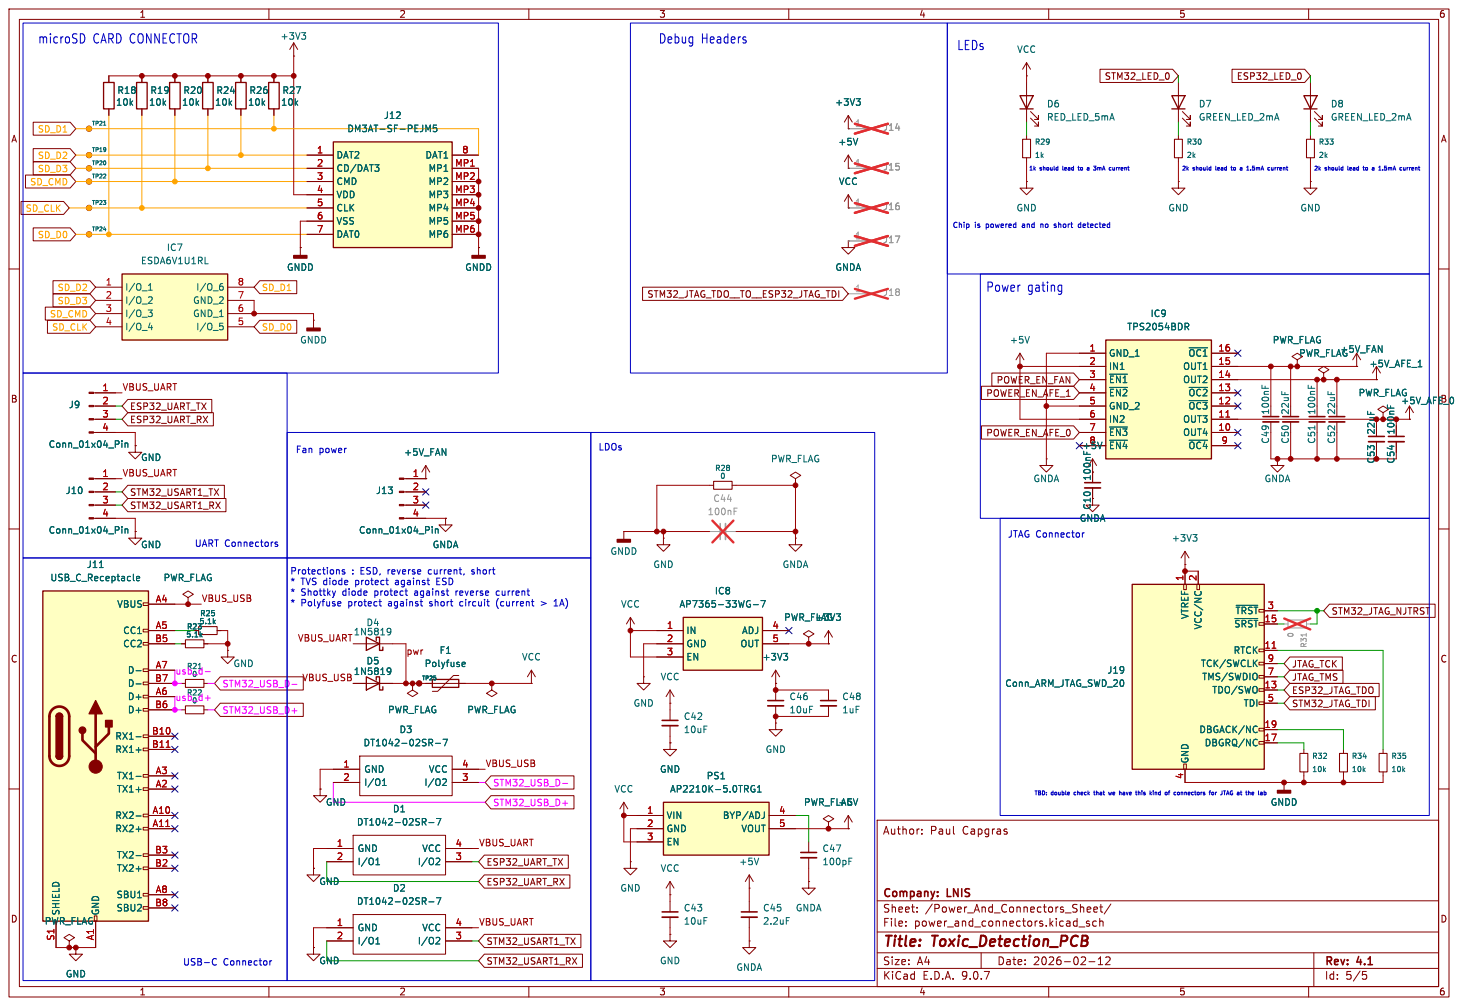
[picture p145: page 5]

2 ~{TRST}3 ~{SRST}15 RTCK 11 TCK/SWCLK 9 TMS/SWDIO 7 TDO/SWO 13 TDI 5 DBGACK/NC 19 DBGRQ/NC 17

2 ~{TRST}3 ~{SRST}15 RTCK 11 TCK/SWCLK 9 TMS/SWDIO 7 TDO/SWO 13 TDI 5 DBGACK/NC 19 DBGRQ/NC 17GNDD
