capopaul/Toxic-Detection-PCB/doc/schematic_v4.0.pdf

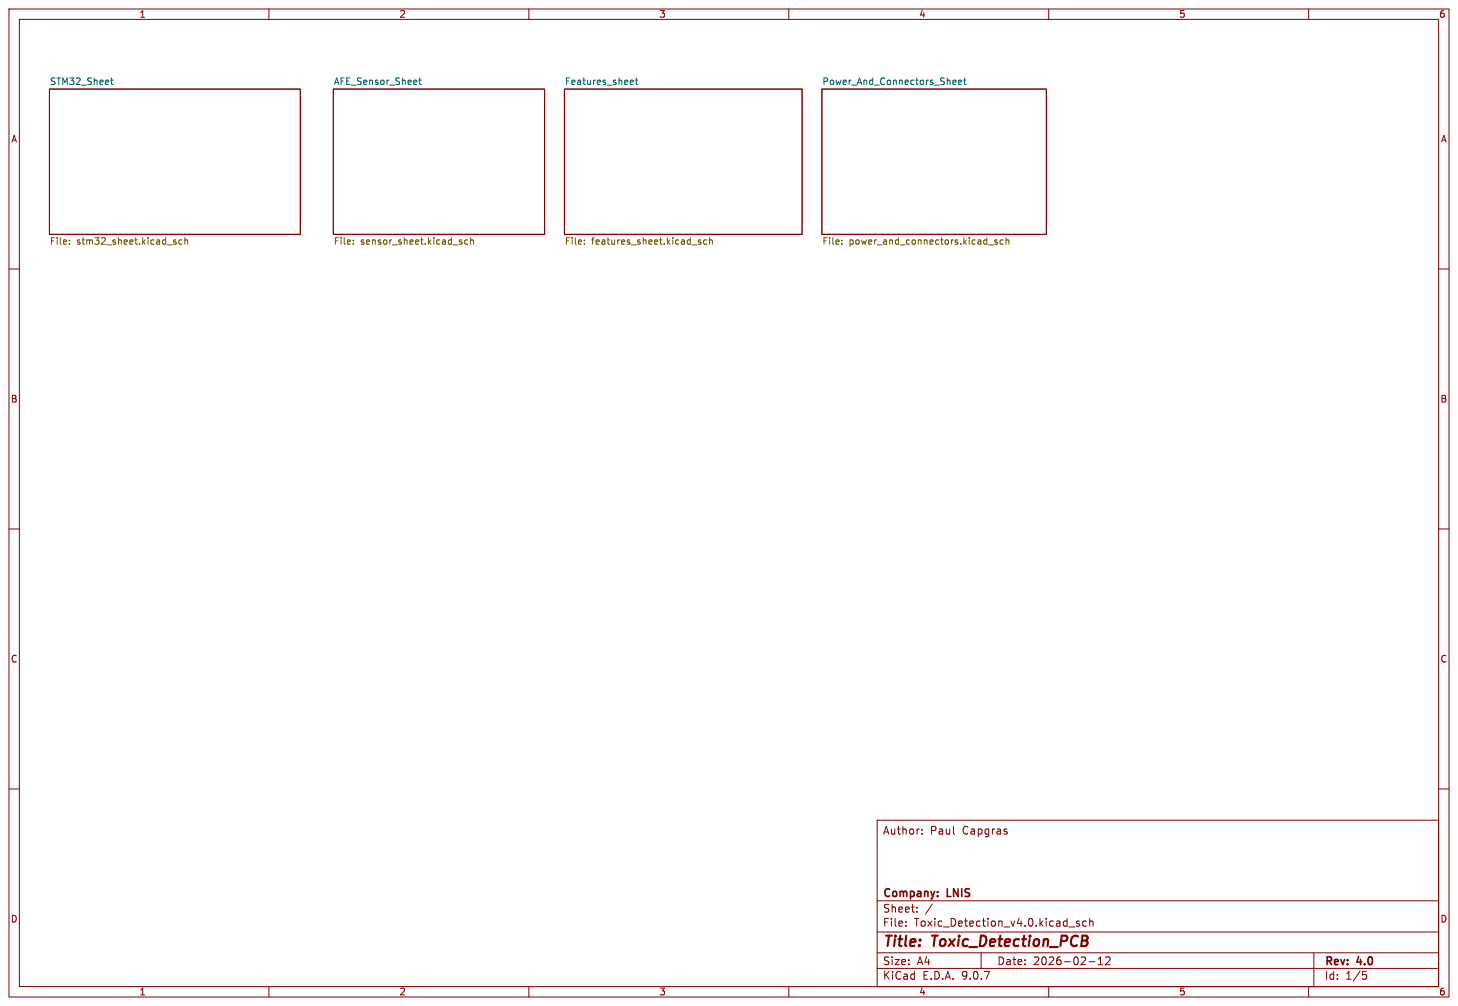
[picture p146: page 1]

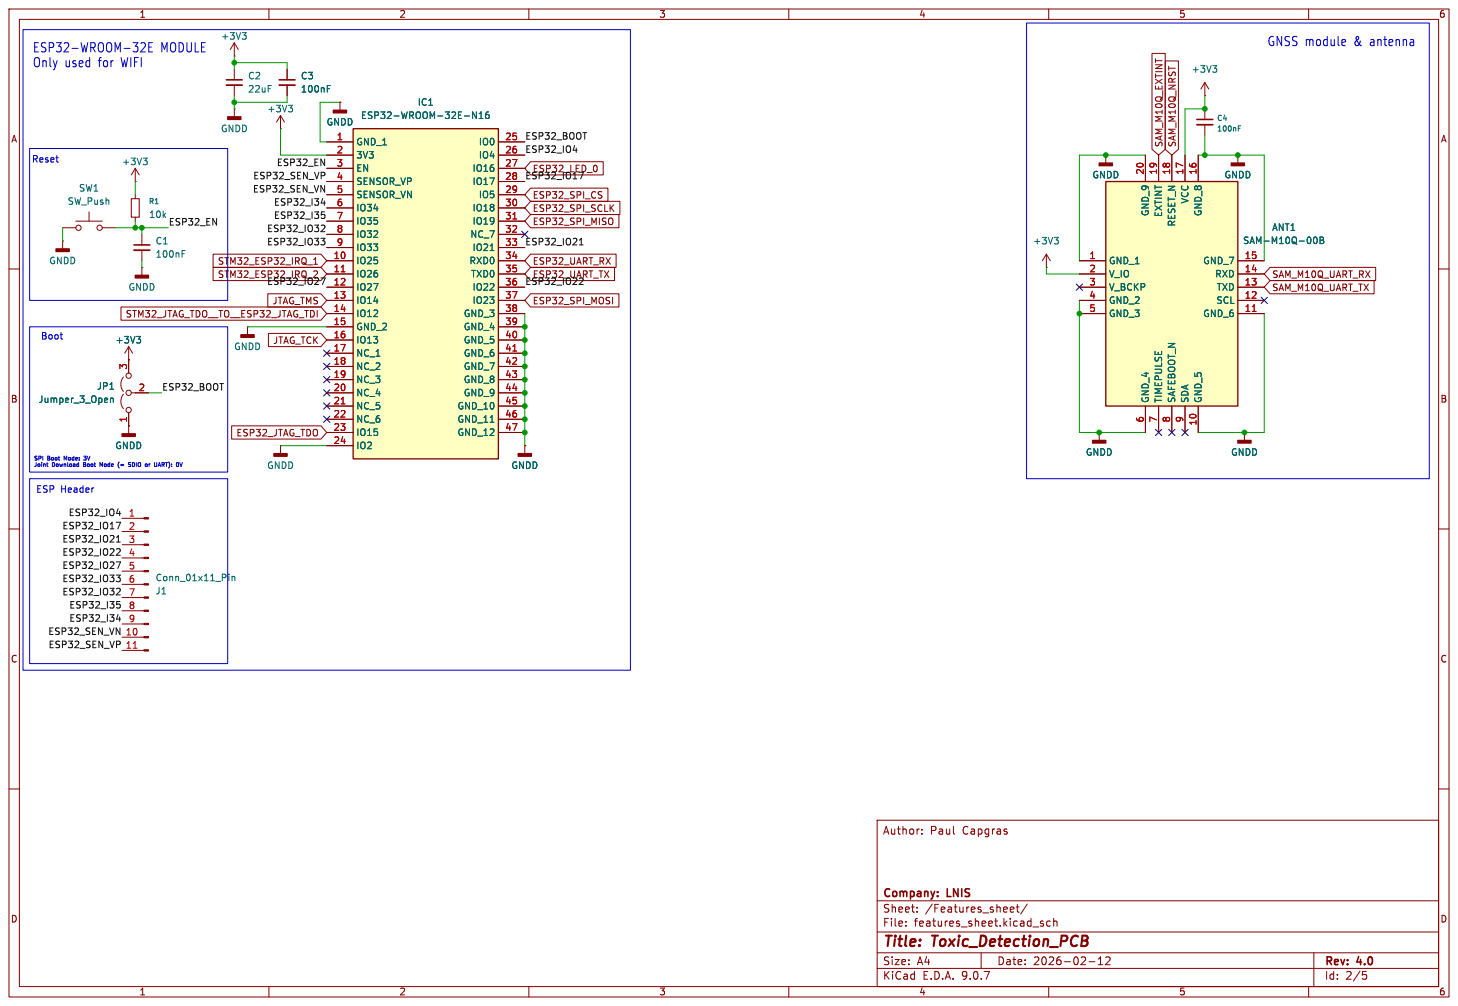
[picture p147: page 2]

Only used for WIFI SPI Boot Mode: 3V

9 GND_8 16 GND_5 10 GND_7 15 RXD 14 TXD 13 SCL 12 GND_6 11 GNDD

9 GND_8 16 GND_5 10 GND_7 15 RXD 14 TXD 13 SCL 12 GND_6 11 ANT1 SAM-M10Q-00B GNDD

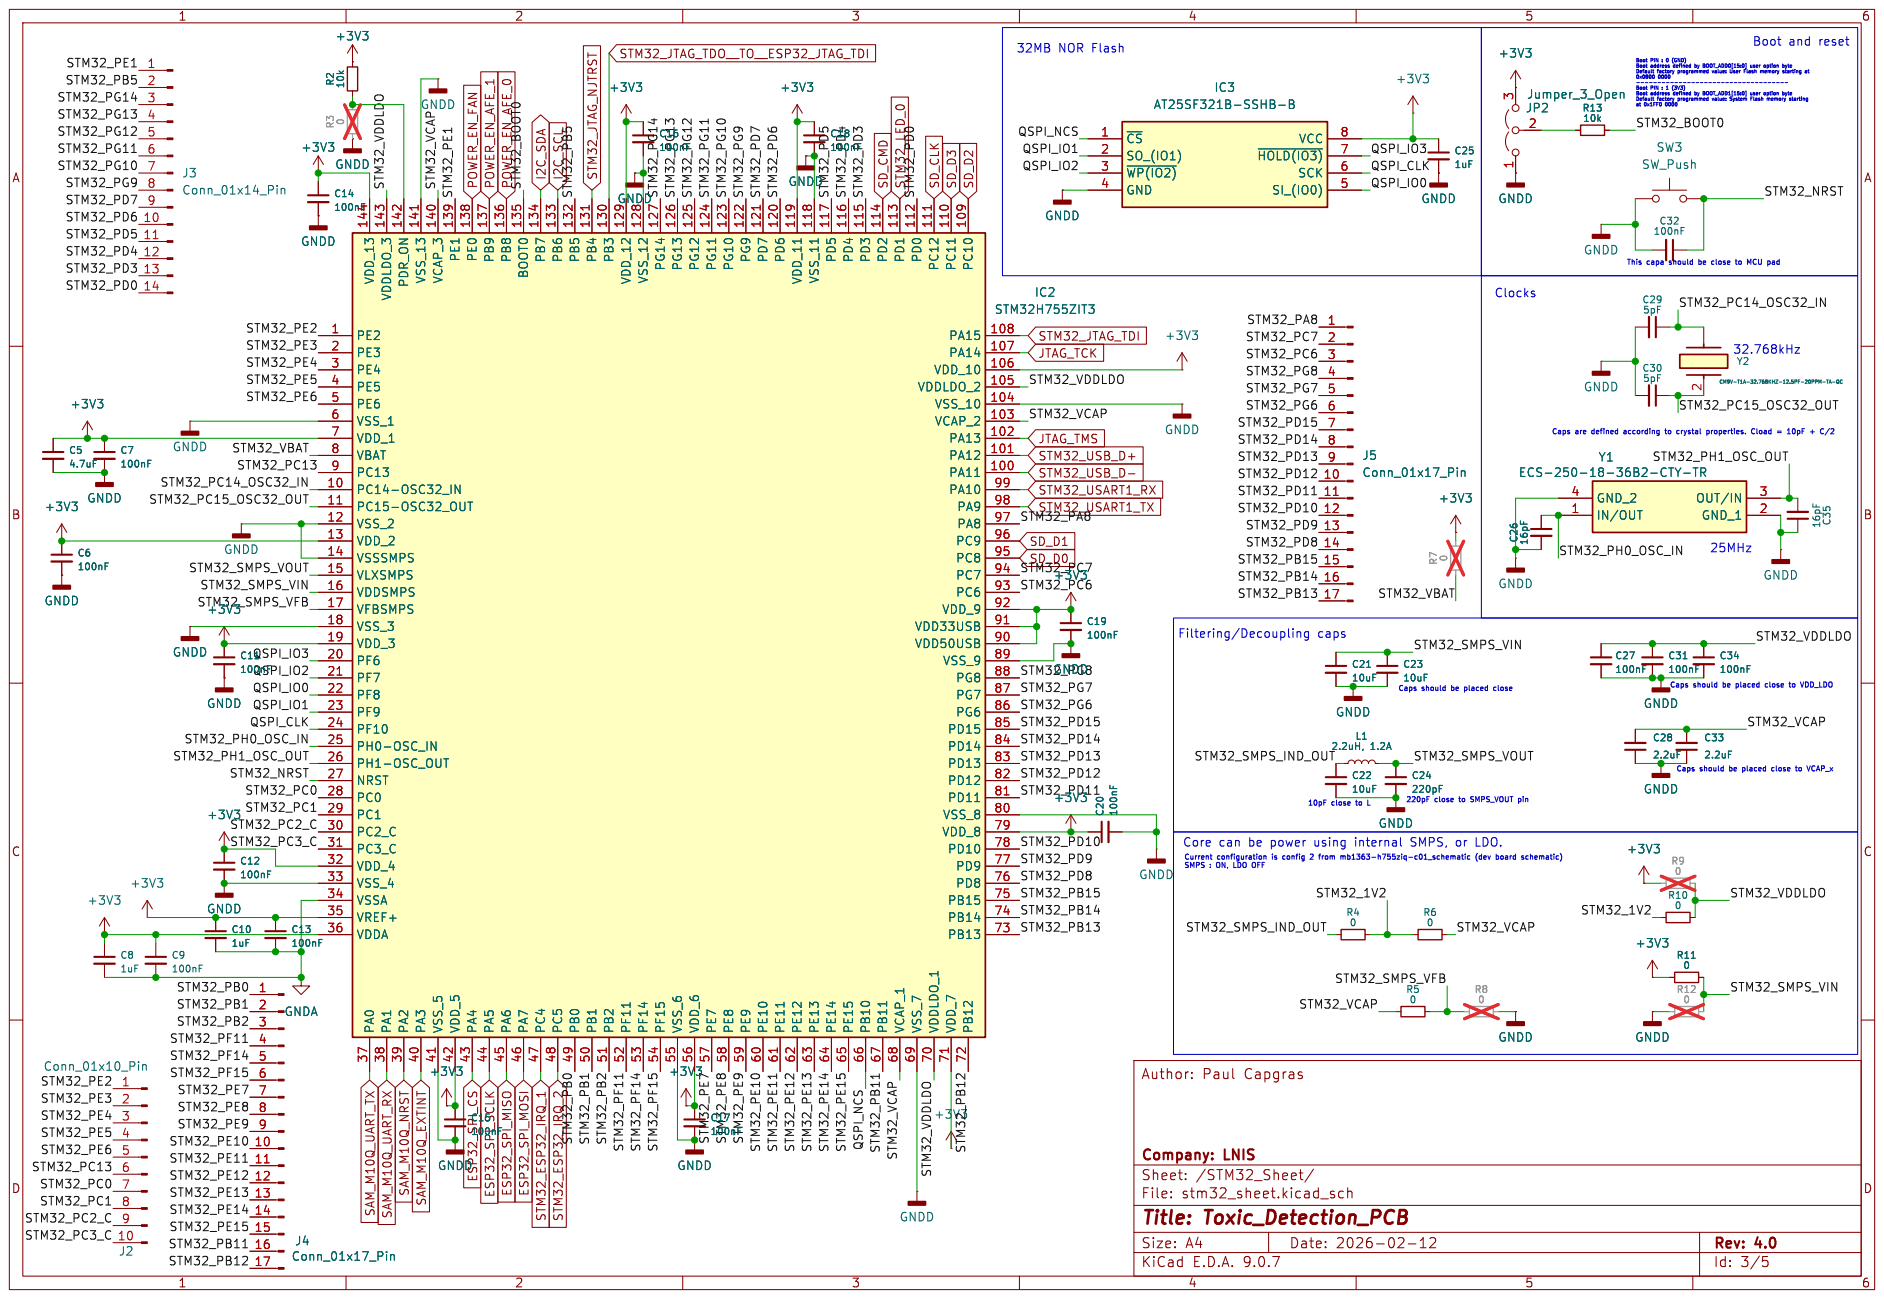
[picture p148: page 3]

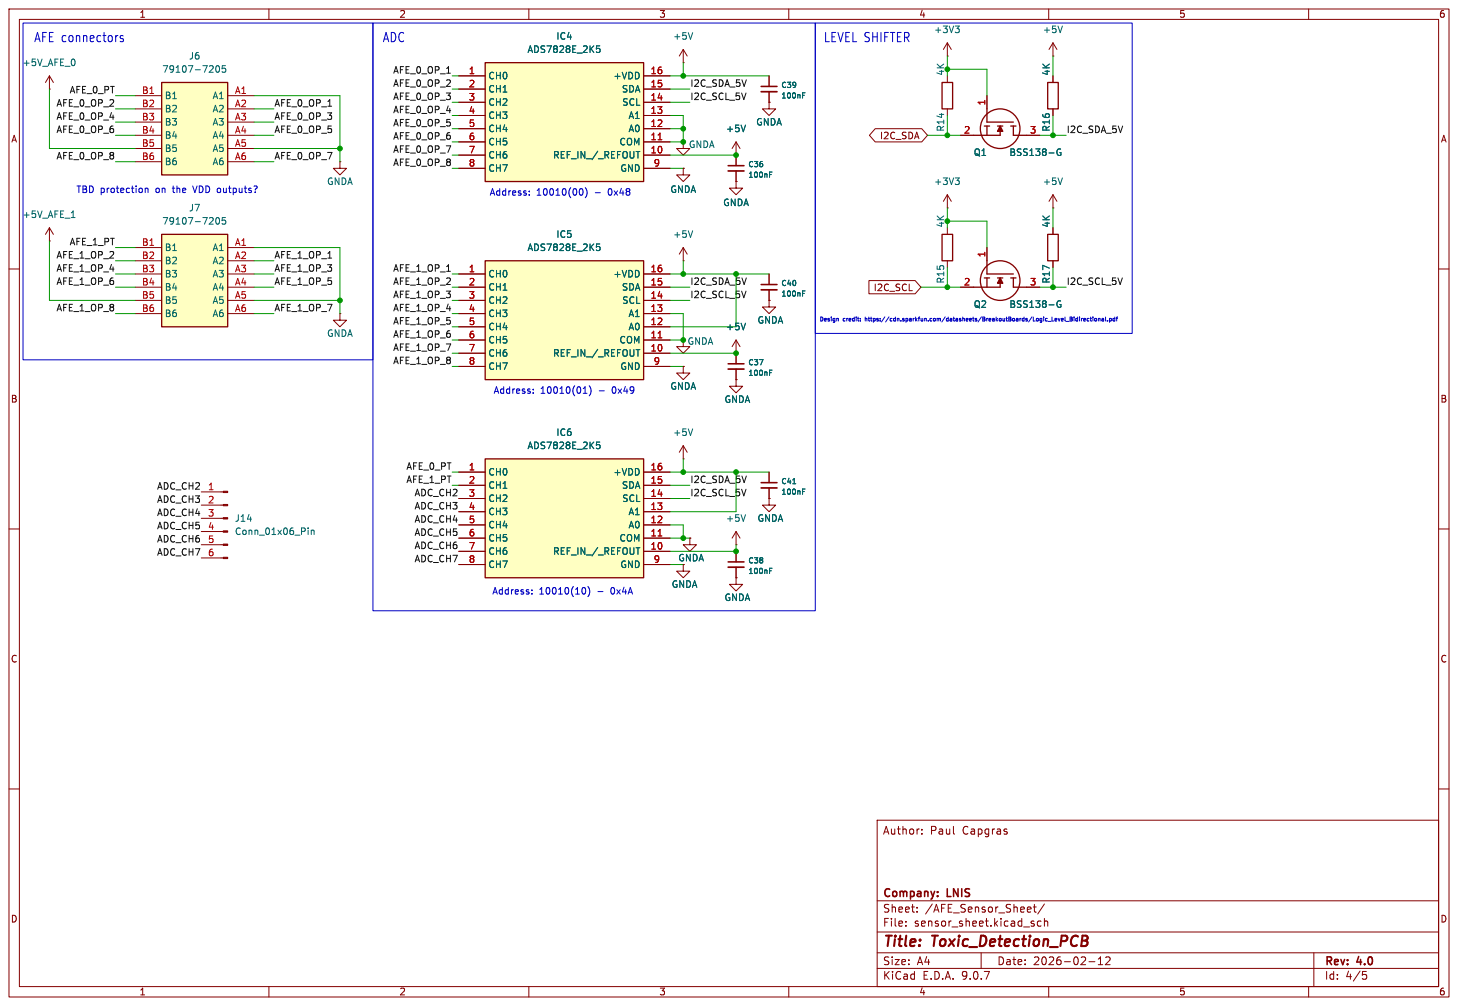
[picture p149: page 4]

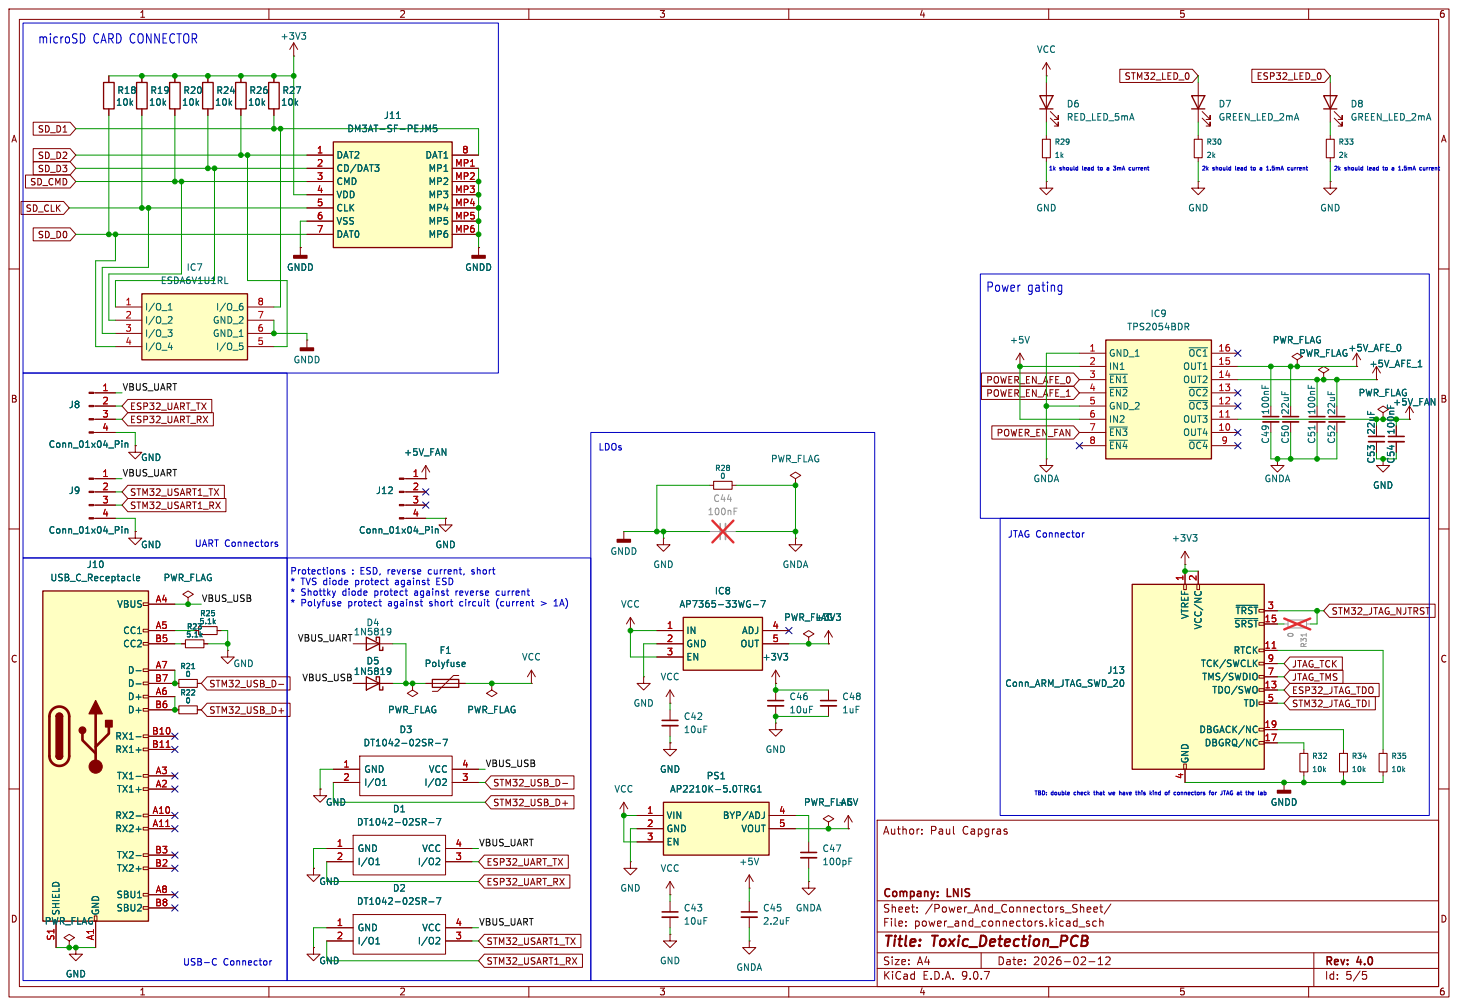
[picture p150: page 5]

2 ~{TRST}3 ~{SRST}15 RTCK 11 TCK/SWCLK 9 TMS/SWDIO 7 TDO/SWO 13 TDI 5 DBGACK/NC 19 DBGRQ/NC 17 GND

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
