capopaul/Toxic-Detection-PCB/doc/layout_v4.1.pdf

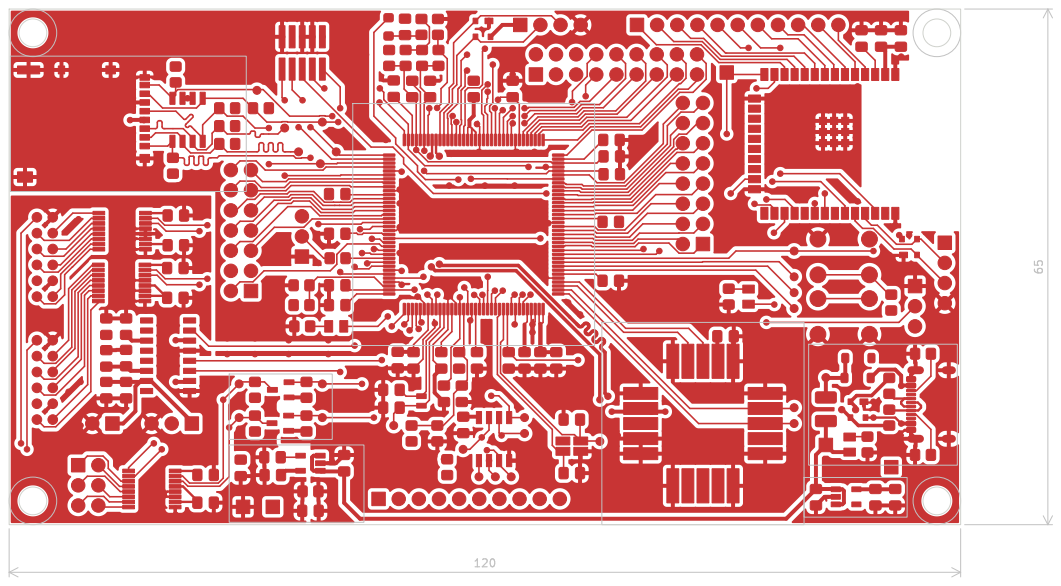
[picture p151: page 1]

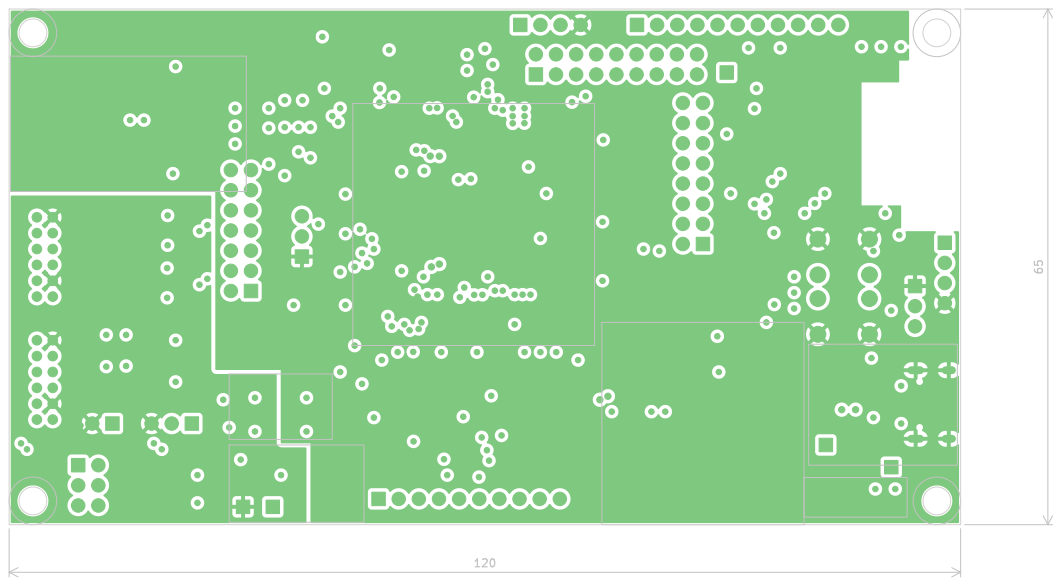
[picture p152: page 2]

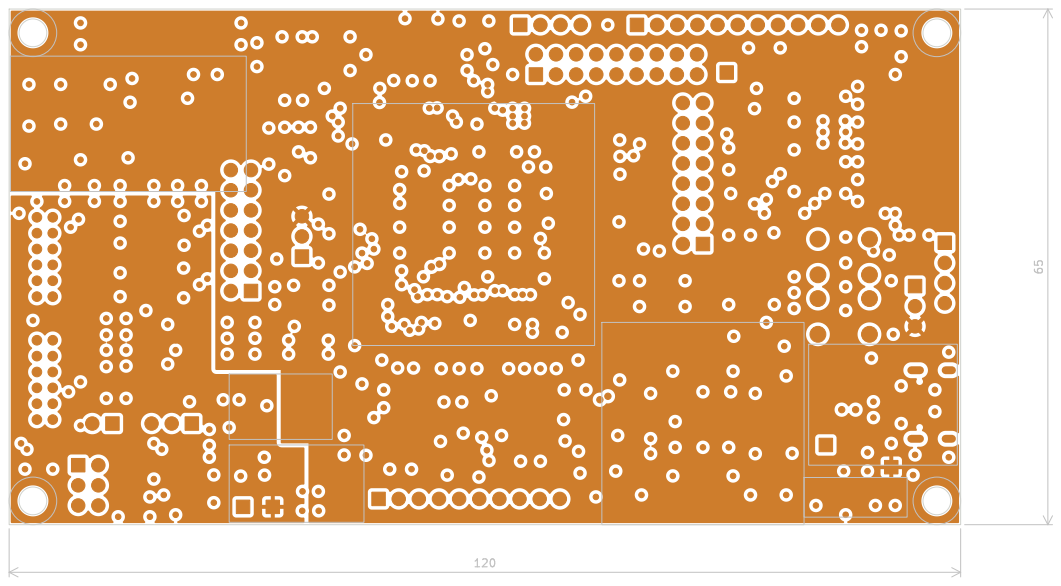
[picture p153: page 3]

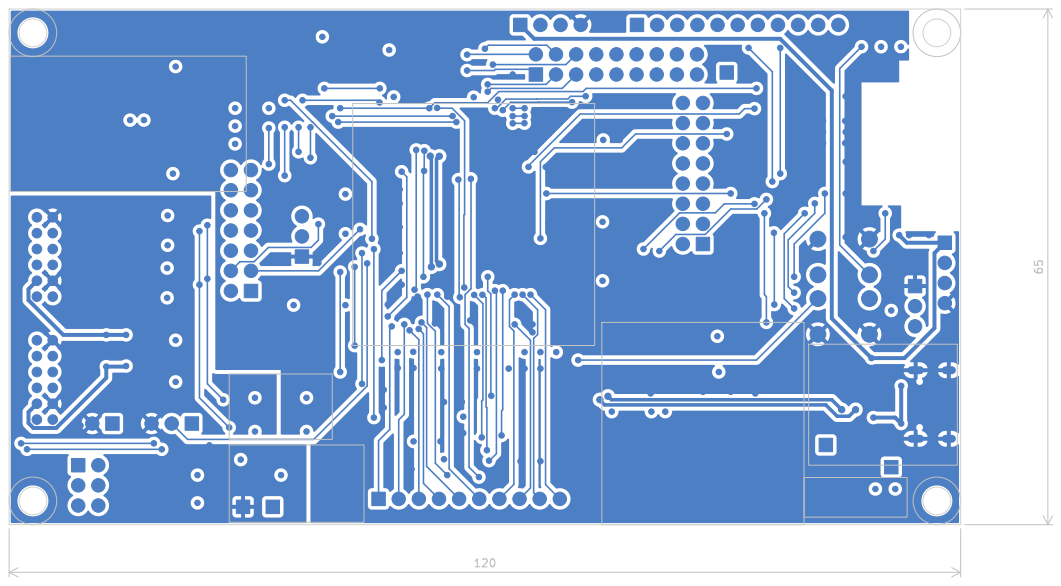
[picture p154: page 4]

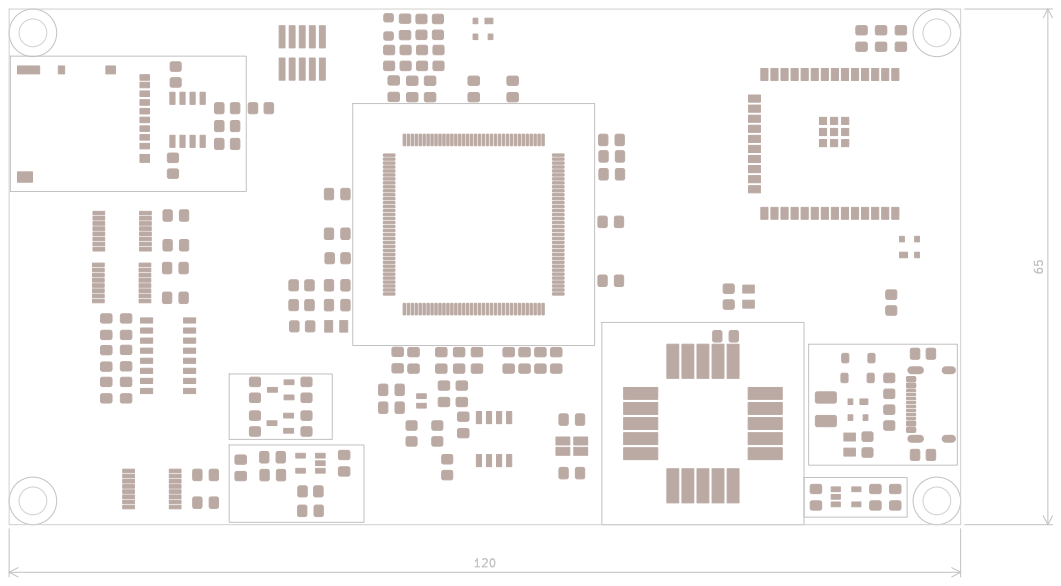
[picture p155: page 5]

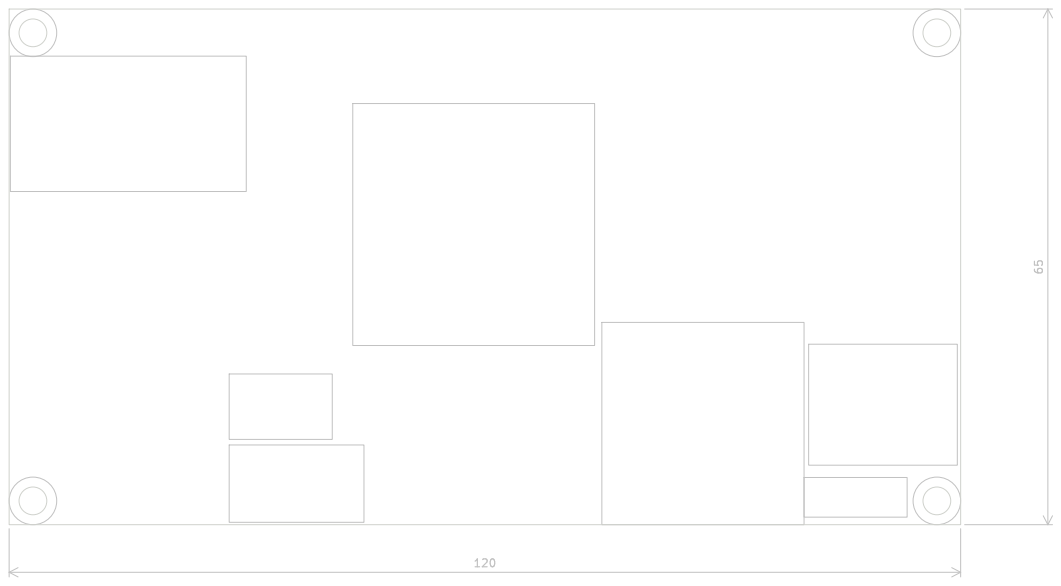
[picture p156: page 6]

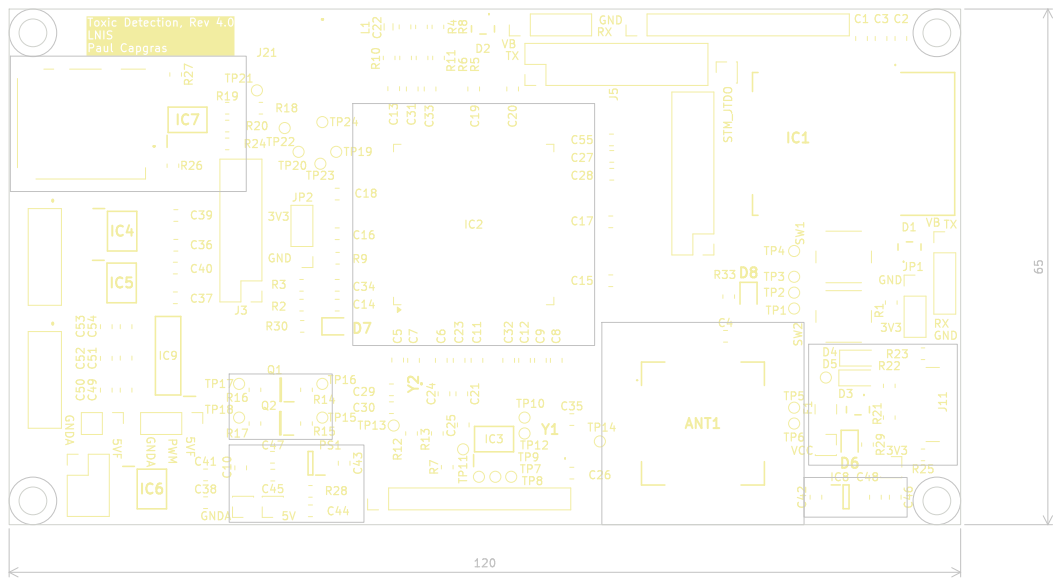
[picture p157: page 7]

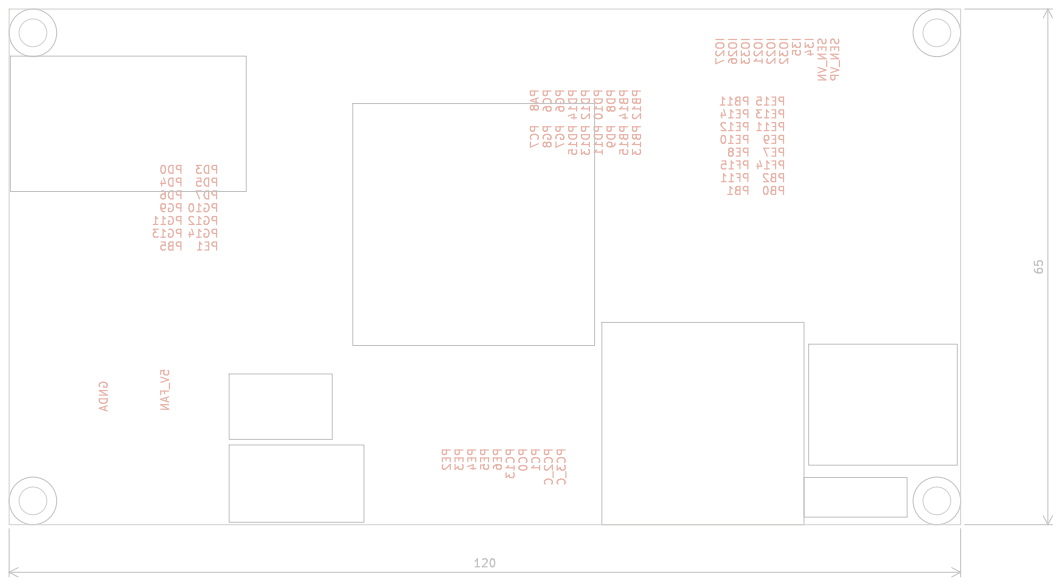
[picture p158: page 8]

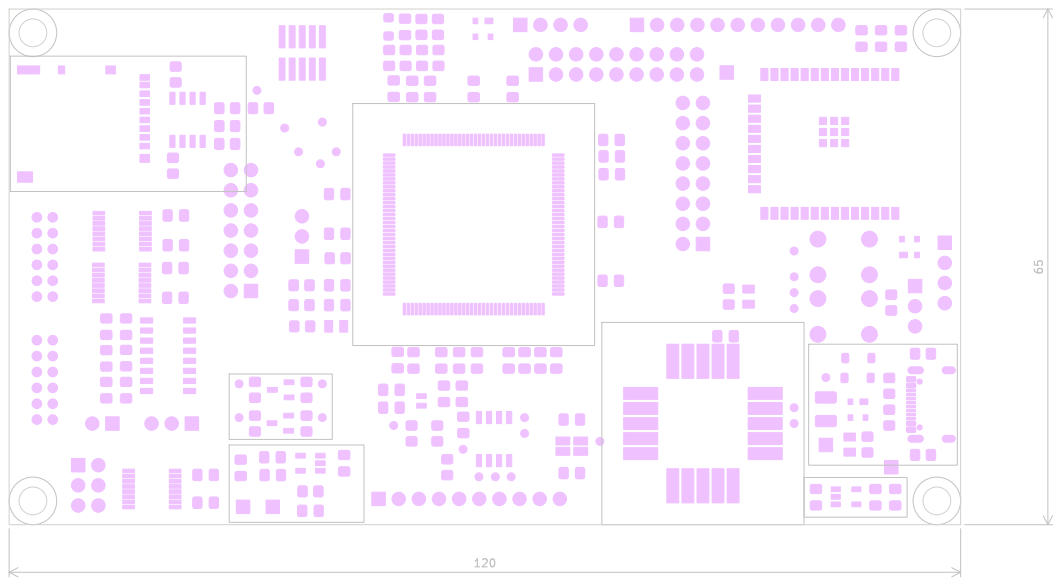
[picture p159: page 9]

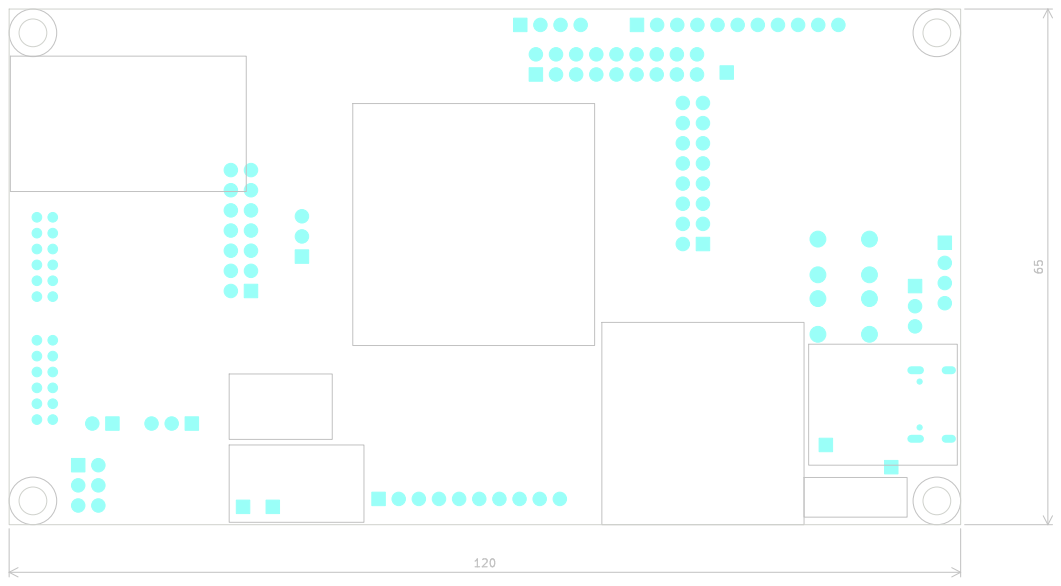
[picture p160: page 10]

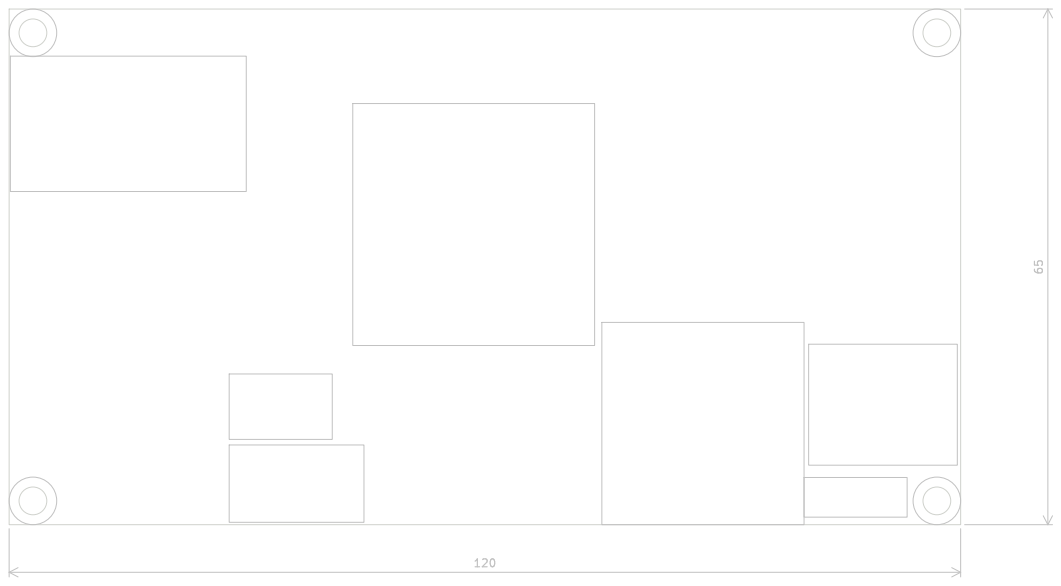
[picture p161: page 11]
