capopaul/Toxic-Detection-PCB/doc/layout_v4.0.pdf

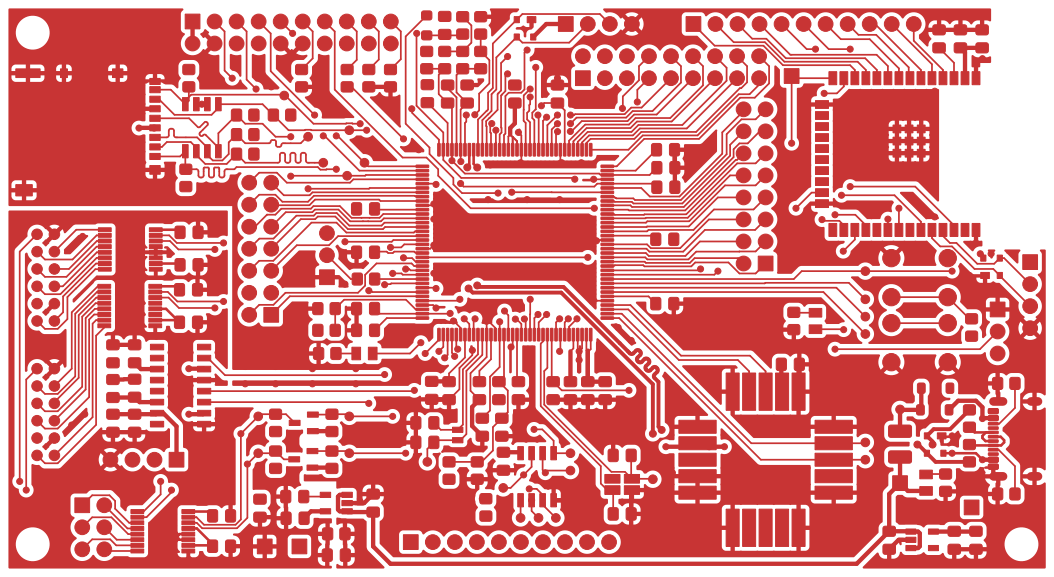
[picture p162: page 1]

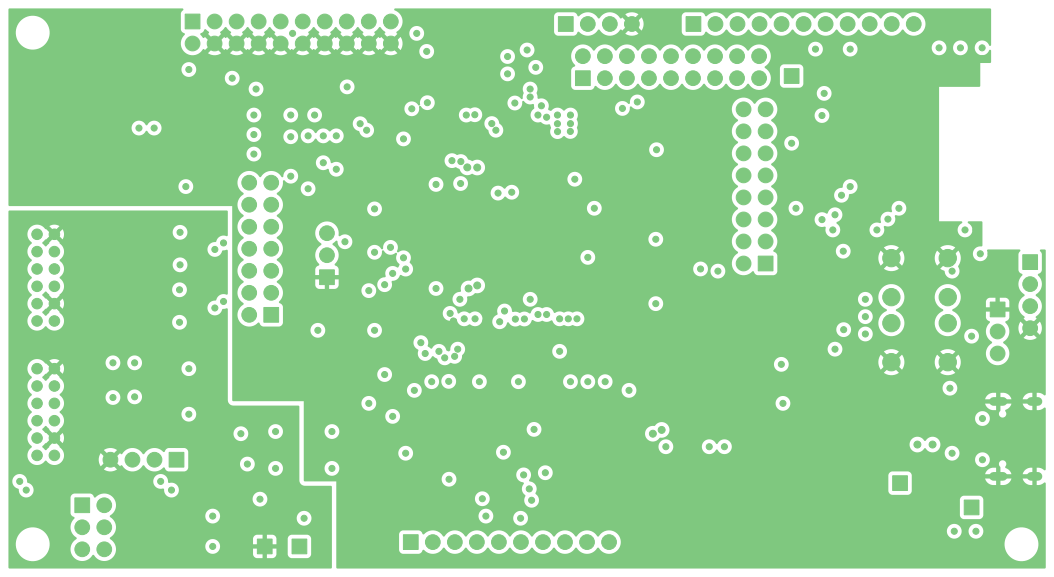
[picture p163: page 2]

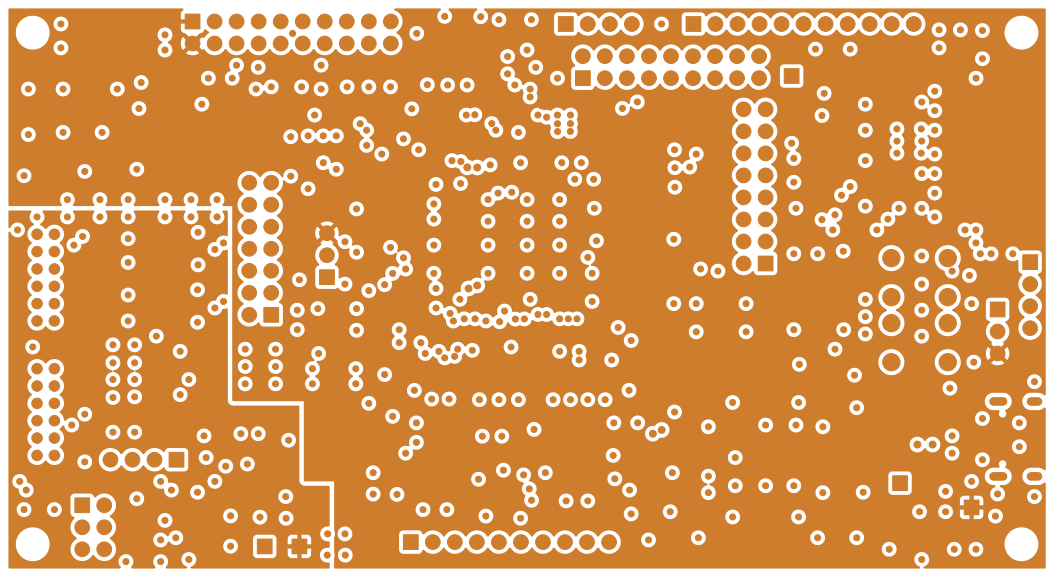
[picture p164: page 3]

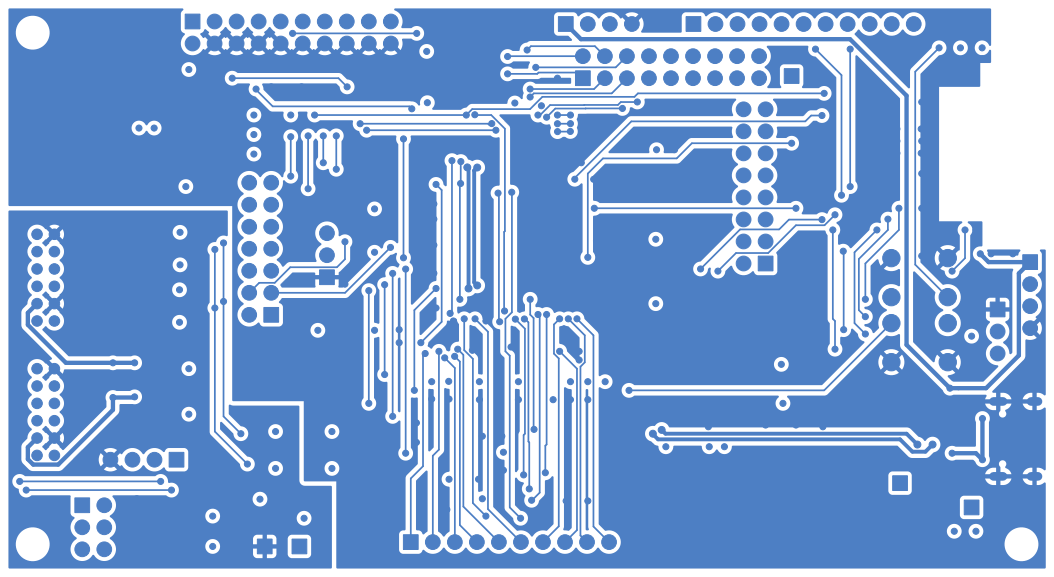
[picture p165: page 4]

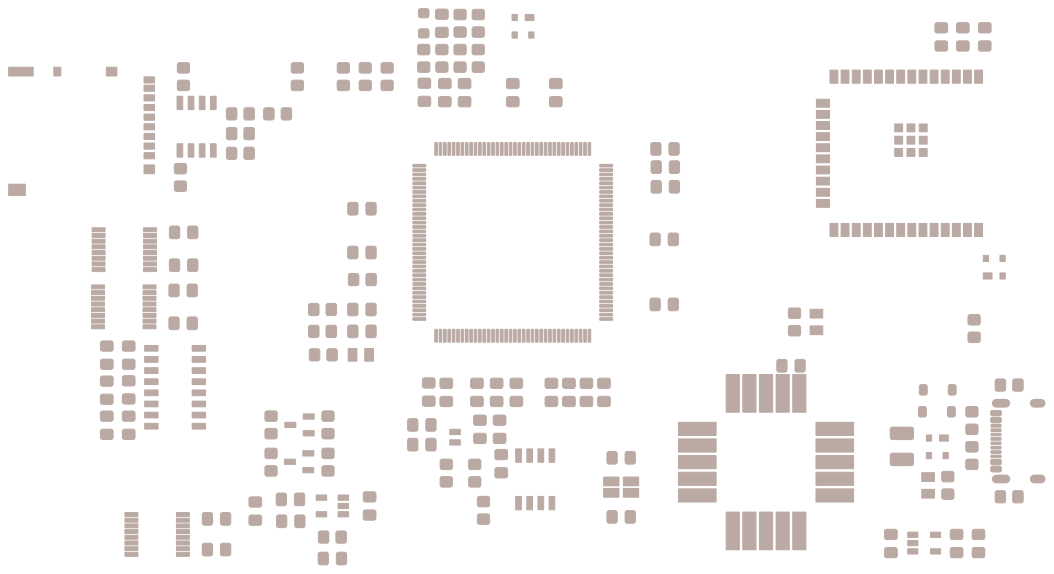
[picture p166: page 5]

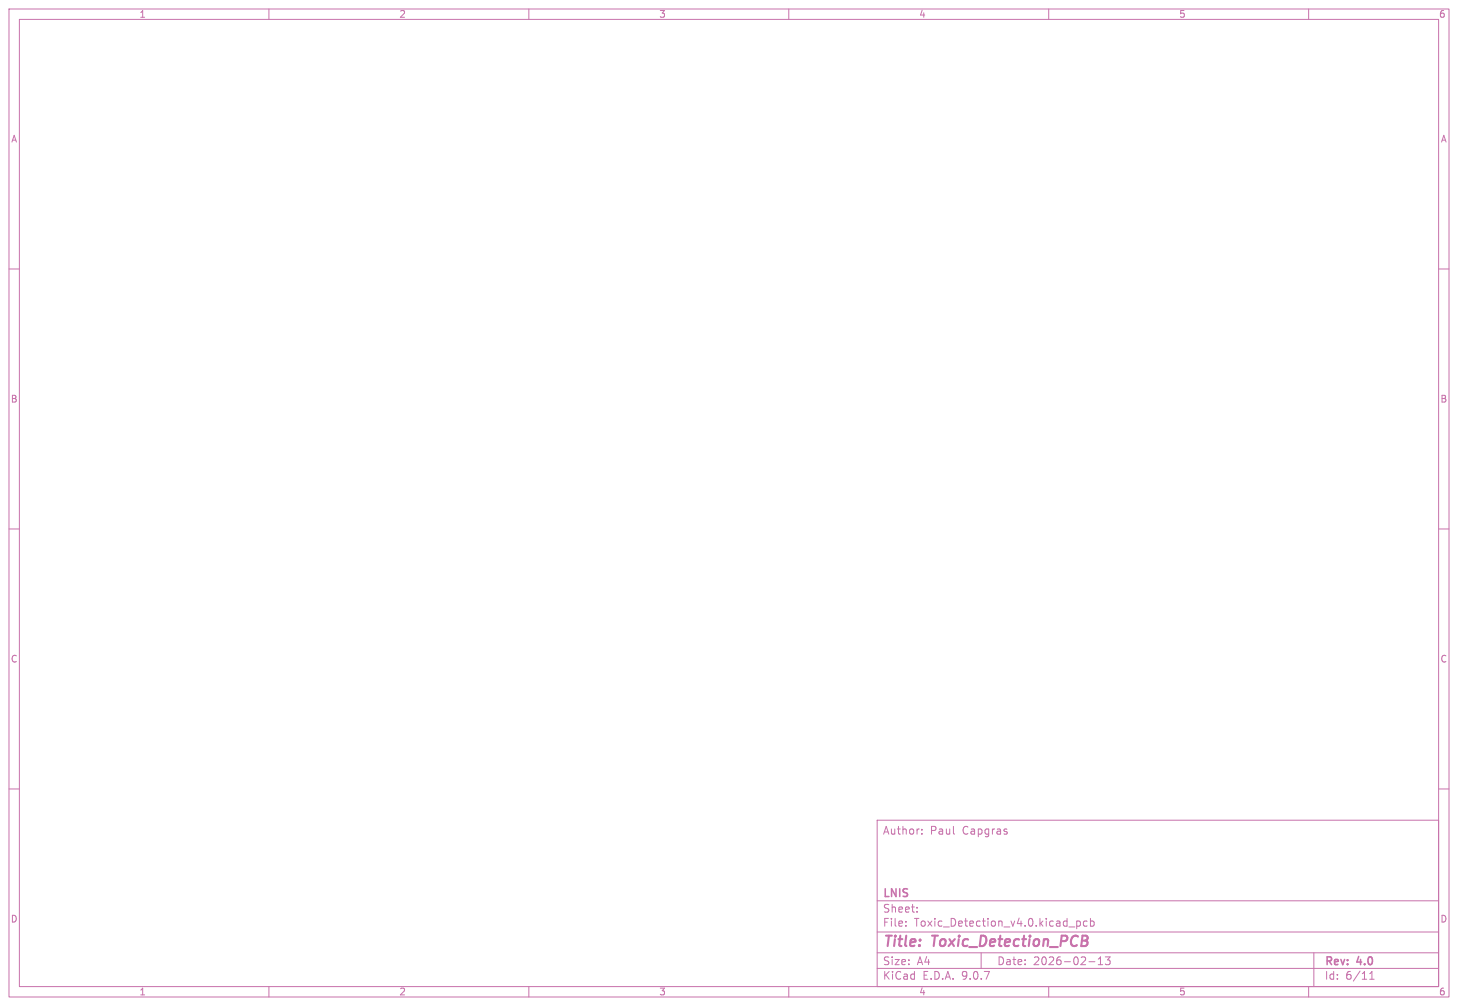
[picture p167: page 6]

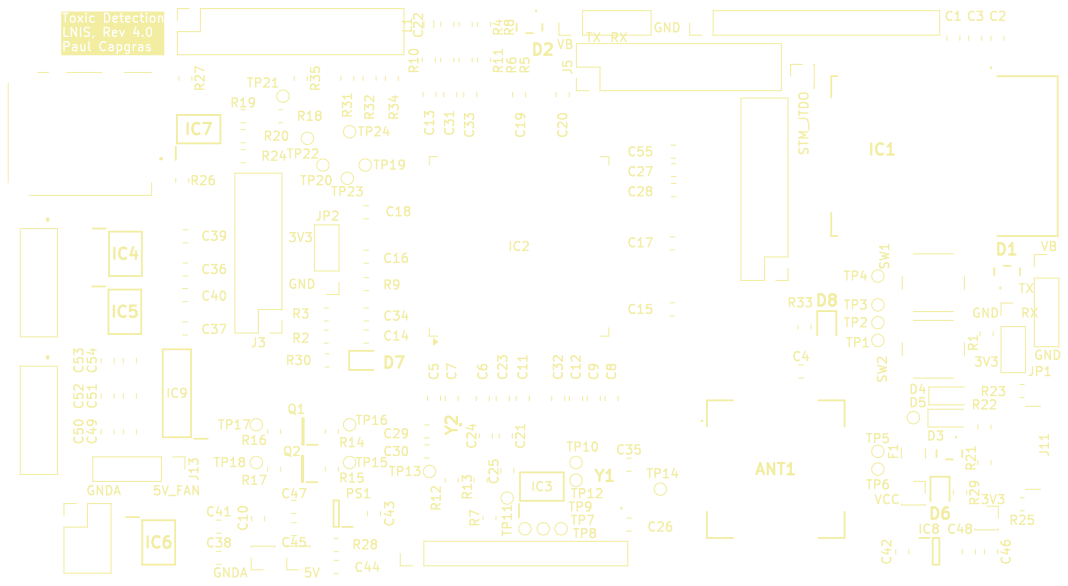
[picture p168: page 7]

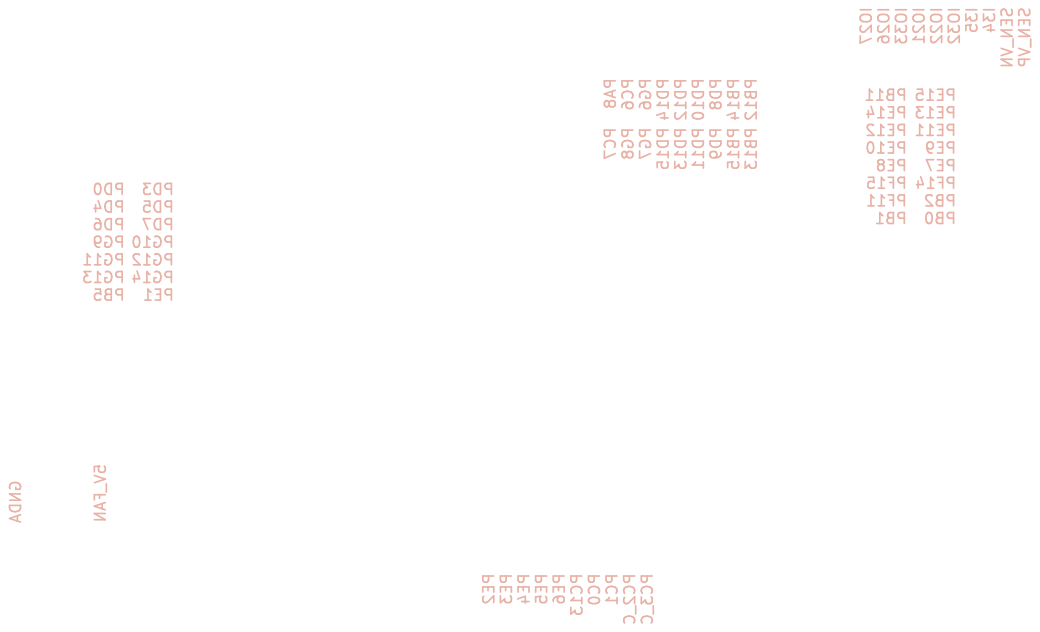
[picture p169: page 8]

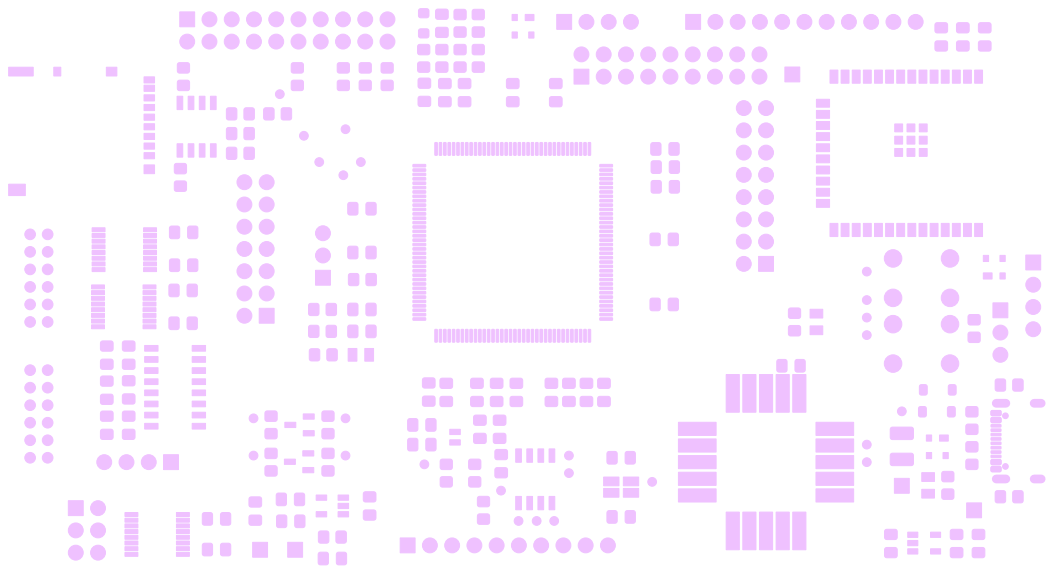
[picture p170: page 9]

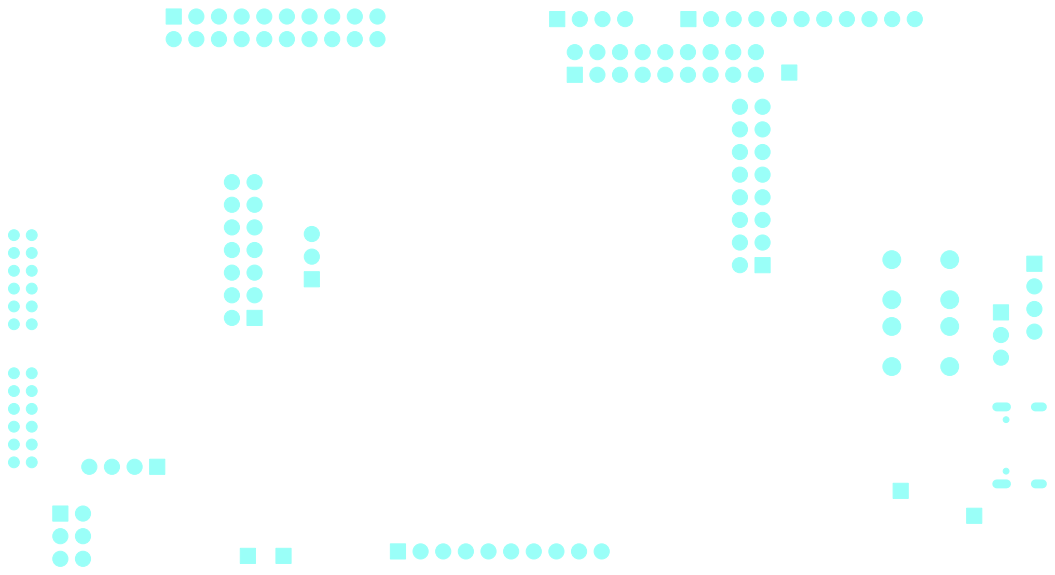
[picture p171: page 10]

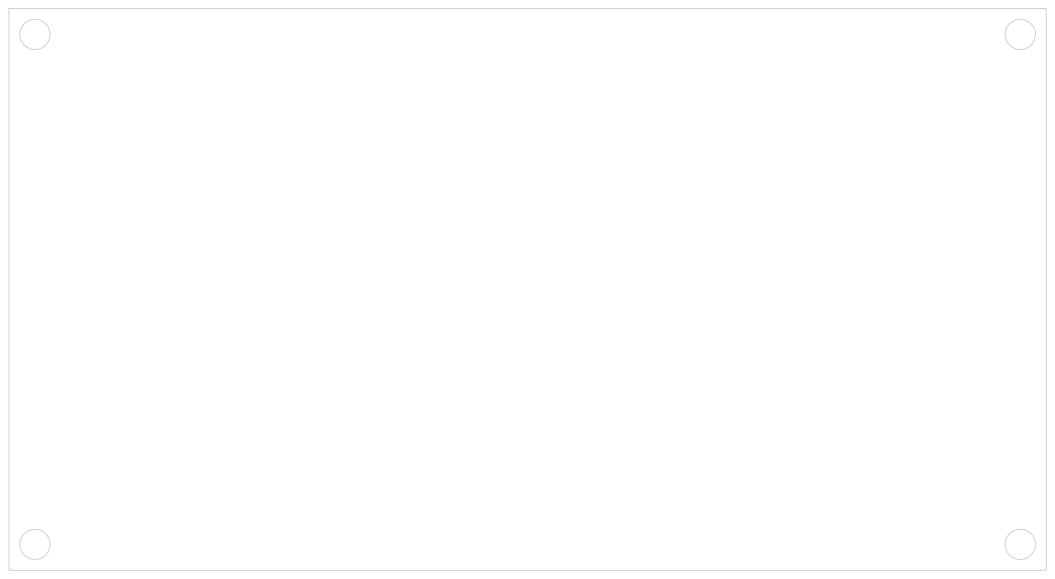
[picture p172: page 11]
