capopaul/Toxic-Detection-PCB/SW/stm32/cube_mx_led_only/cube_mx_led_only.ioc

Mcu.UserName=STM32H755ZITx
PD1.Signal=GPIO_Output
