capopaul/Toxic-Detection-PCB/(commit log)

2026-02-09 feat: add components datasheets, symbols, footprints, 3d models
    [105450-0101.stp, ADS7828E_2K5.stp, BSS138-G.stp, CM9V-T1A-32.768KHZ-12.5PF-20PPM-TA-QC.stp, DT1042-02SR-7.stp, ECS-250-18-36B2-CTY-TR.stp, ESDA6V1U1RL.stp, ESP32-WROOM-32E-N16.stp]
2026-02-09 doc: create design note files. Include STM32 power supply, bootloading, clocks, debug
2026-02-09 feat: create kicad files with STM32 power supply, bootloading, clocks, debug
    [ESP_sheet.kicad_sch, Toxic_Detection_v4.0.kicad_pcb, Toxic_Detection_v4.0.kicad_sch, stm32_sheet.kicad_sch]
2026-02-10 feat: add AFE connectors & ADCs. Add LDOs with power gating
    [79107-7204.stp, 79107-7205.stp, AP2210K-5.0TRG1.stp, AP7365-33WG-7.stp, ESP_sheet.kicad_sch, TPS2054BDR.stp, Toxic_Detection_v4.0.kicad_sch, features_sheet.kicad_sch]
2026-02-11 feat: add spi between STM32 and ESP32, update JTAG to add ESP32 on it
    [features_sheet.kicad_sch, power_and_connectors.kicad_sch, stm32_sheet.kicad_sch]
2026-02-12 feat: add GNSS module and antenna
    [SAM-M10Q-00B.stp, Toxic_Detection_v4.0.kicad_sch, features_sheet.kicad_sch, stm32_sheet.kicad_sch]
2026-02-12 feat: add 32MB NOR flash
    [AT25SF321B-SSHB-B.stp, power_and_connectors.kicad_sch, stm32_sheet.kicad_sch]
2026-02-12 feat: assign all pins to stm32
    [stm32_sheet.kicad_sch]
2026-02-12 feat: add leds and headers
    [APTD2012LCGCK.stp, PCA9533DP_01,118.stp, features_sheet.kicad_sch, power_and_connectors.kicad_sch, sensor_sheet.kicad_sch, stm32_sheet.kicad_sch]
2026-02-12 feat: assign footprints and pass ERC
    [features_sheet.kicad_sch, power_and_connectors.kicad_sch, sensor_sheet.kicad_sch, stm32_sheet.kicad_sch]
2026-02-13 doc: update schematic documentation, design notes and all other kind of documentation. Add product_brief revision history
    [1N5819HW-7-F.stp, Toxic_Detection_v4.0.kicad_sch, features_sheet.kicad_sch, power_and_connectors.kicad_sch, sensor_sheet.kicad_sch, stm32_sheet.kicad_sch]
2026-02-16 feat: first placement (layout)
    [Toxic_Detection_v4.0.kicad_pcb, Toxic_Detection_v4.0.kicad_sch, features_sheet.kicad_sch, power_and_connectors.kicad_sch, sensor_sheet.kicad_sch, stm32_sheet.kicad_sch]
2026-02-16 feat: second and third placement (layout)
    [Toxic_Detection_v4.0.kicad_pcb, stm32_sheet.kicad_sch]
2026-02-17 feat (layout) : finish routing, fill zones, and create custom footprints for some components
    [Toxic_Detection_v4.0.kicad_pcb, features_sheet.kicad_sch, power_and_connectors.kicad_sch, stm32_sheet.kicad_sch]
2026-02-17 feat: finish silkscreen and update doc
    [Toxic_Detection_v4.0.kicad_pcb, features_sheet.kicad_sch, stm32_sheet.kicad_sch]
2026-02-18 feat: usb matching lines
    [Toxic_Detection_v4.0.kicad_pcb]
2026-02-19 doc: export rev 4.1 doc in PDF
    [Toxic_Detection_v4.0.kicad_pcb]
2026-03-03 feat: take into account PE's feedback : update jtag connector, add second port for 2wires-fan, add pwm pin to control fan.
    [FTSH-105-01-L-DV-K.stp, Toxic_Detection_v4.0.kicad_pcb, Toxic_Detection_v4.0.kicad_sch, features_sheet.kicad_sch, power_and_connectors.kicad_sch, sensor_sheet.kicad_sch, stm32_sheet.kicad_sch]
2026-03-03 doc: update schematic and layout link in readme. update rev on silkscreen
    [Toxic_Detection_v4.0.kicad_pcb]
2026-03-17 feat: take into account all reviews: add anti-aliasing filters, upgrade 3V3 LDO to support up to 5A, fix UART bug between STM and GNSS
    [AP7365-33WG-7.stp, AZ1084CD-3.3TRG1.stp, Toxic_Detection_v4.0.kicad_pcb, Toxic_Detection_v4.0.kicad_sch, features_sheet.kicad_sch, power_and_connectors.kicad_sch, sensor_sheet.kicad_sch, stm32_sheet.kicad_sch]
2026-03-17 feat: generate gerber, bom, and prepare mouser order
    [Toxic_Detection_v4.0-B_Adhesive.gbr, Toxic_Detection_v4.0-B_Cu.gbr, Toxic_Detection_v4.0-B_Mask.gbr, Toxic_Detection_v4.0-B_Paste.gbr, Toxic_Detection_v4.0-B_Silkscreen.gbr, Toxic_Detection_v4.0-Edge_Cuts.gbr, Toxic_Detection_v4.0-F_Adhesive.gbr, Toxic_Detection_v4.0-F_Cu.gbr]
2026-03-18 feat: remove via in pads
    [Toxic_Detection_v4.0-B_Adhesive.gbr, Toxic_Detection_v4.0-B_Cu.gbr, Toxic_Detection_v4.0-B_Mask.gbr, Toxic_Detection_v4.0-B_Paste.gbr, Toxic_Detection_v4.0-B_Silkscreen.gbr, Toxic_Detection_v4.0-Edge_Cuts.gbr, Toxic_Detection_v4.0-F_Adhesive.gbr, Toxic_Detection_v4.0-F_Cu.gbr]
2026-10-18 feat: update gerber for second version
2026-10-18 feat: add hello world example and boot on esp32
2026-11-02 chore: ignore dev board lib
2026-11-02 feat: add STM32CubeMX file
2026-11-02 feat: edit project name to be loaded in STM32CubeIDE
2026-11-02 feat: create basic led project with cubemx
2026-11-02 feat: successfully blink a led
