capopaul/Toxic-Detection-PCB/(notices)

Notices in the files:
SW/stm32/cube_mx_led_only/CM7/Core/Src/main.c:
Copyright (c) 2026 STMicroelectronics.
All rights reserved.
